ROHMUSDC/ROHM_SensorPlatform_Multi-Sensor-Shield/Platform Code/NXP_LPCXpresso54102_BlinkyExample/Firmware/periph_blinky/example/readme.txt

LPC5410x Simple blinky example
============================

Example description
-------------------
The Blinky example is known as the "Hello, World!" of embedded programming. This
example will flash an LED on your board at a periodic rate using sysTick.

Special connection requirements
-------------------------------
There are no special connection requirements for this example.

Build procedures:
-----------------
Visit the at 'LPCOpen quickstart guides' [http://www.lpcware.com/content/project/lpcopen-platform-nxp-lpc-microcontrollers/lpcopen-v200-quickstart-guides]
to get started building LPCOpen projects.
