ROHMUSDC/ROHM_SensorPlatform_Multi-Sensor-Shield/Documentation/CE Declaration of Conformity/technical_documentation/[10]_ROHMSensorShield_BoxPhotos_20160830.pdf

© 2016 ROHM Semiconductor U.S.A.,LLC

# SENSORSHLD1-EVK-101

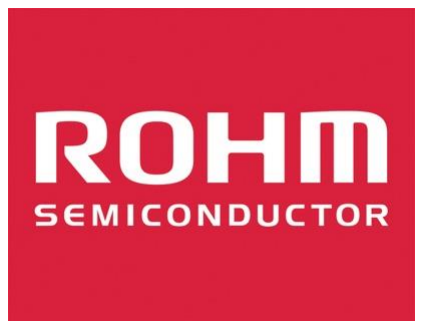
[picture p1: figure]

# Evaluation Board Box Pictures

# 08 August 2016 ROHM USDC Applications Engineering

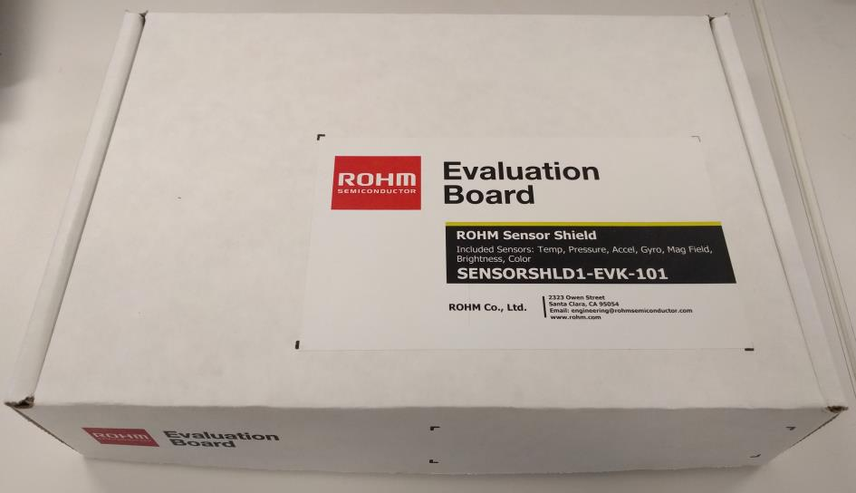
[picture p2: figure]

© 2016 ROHM Semiconductor U.S.A.,LLC | P. 1

# Sensor Shield Box, TOP

# Sensor Shield Box, TOP/SIDE

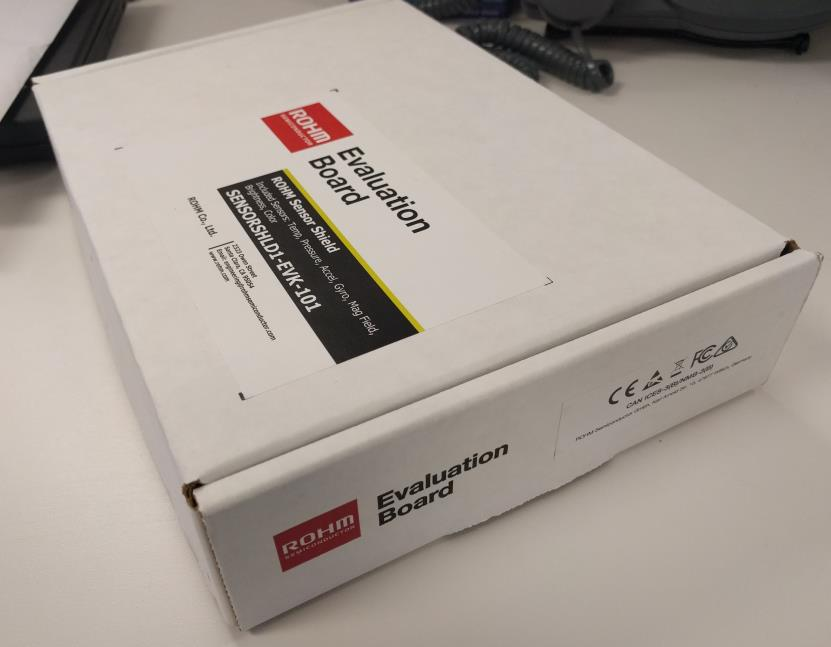
[picture p3: figure]

# Sensor Shield Box, SIDE

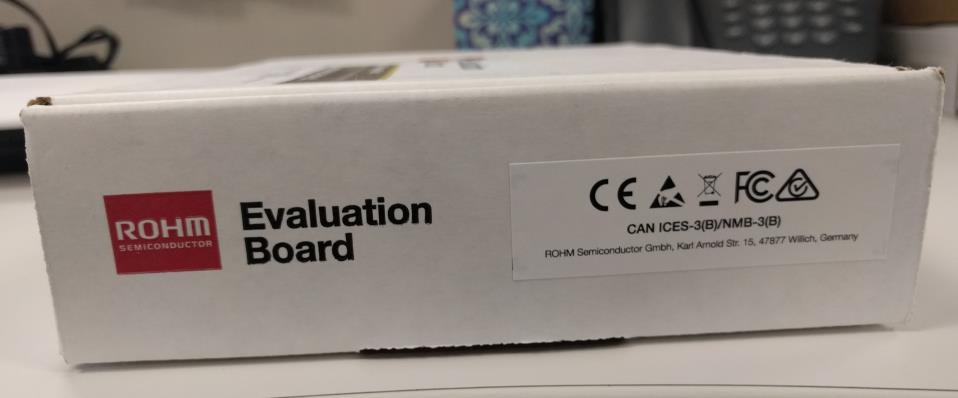
[picture p4: figure]

# Sensor Shield Box, Board Placement/Inner Box

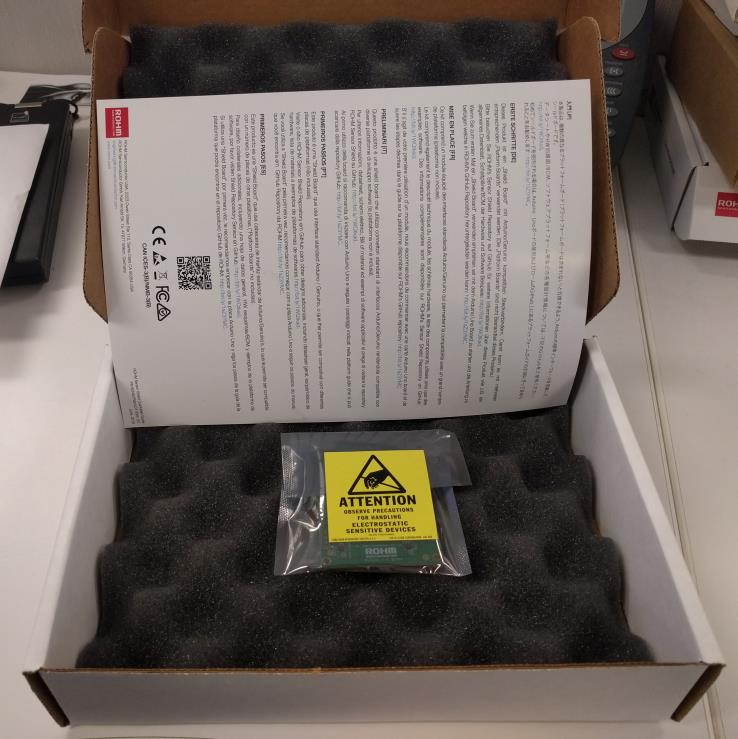
[picture p5: figure]

# Sensor Shield Box, Final QSG Placement

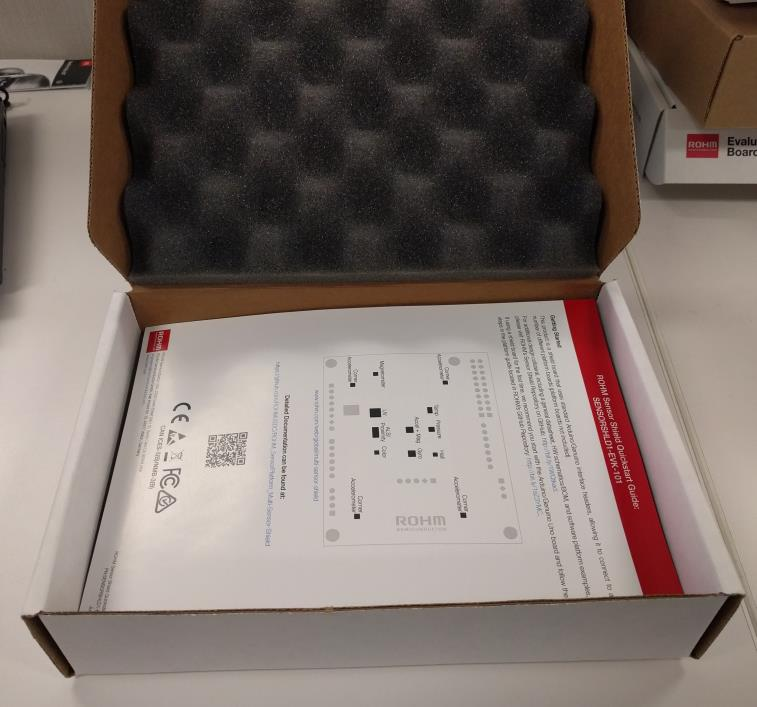
[picture p6: figure]

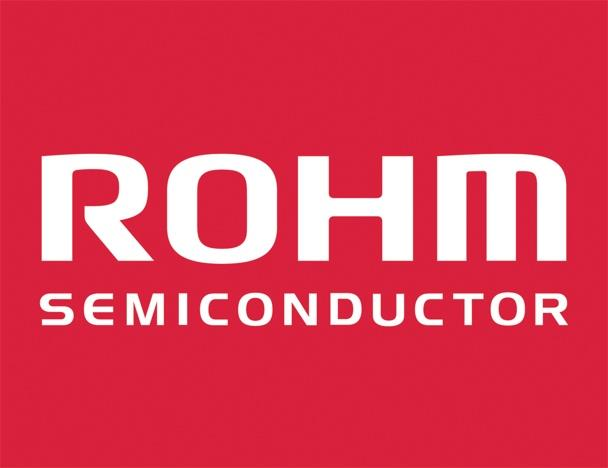
[picture p7: figure]

© 2016 ROHM Semiconductor U.S.A.,LLC .
