ROHMUSDC/ROHM_SensorPlatform_Multi-Sensor-Shield/Documentation/CE Declaration of Conformity/EUDC-DoC-201602-SENSORSHLD1-EVK-101.pdf

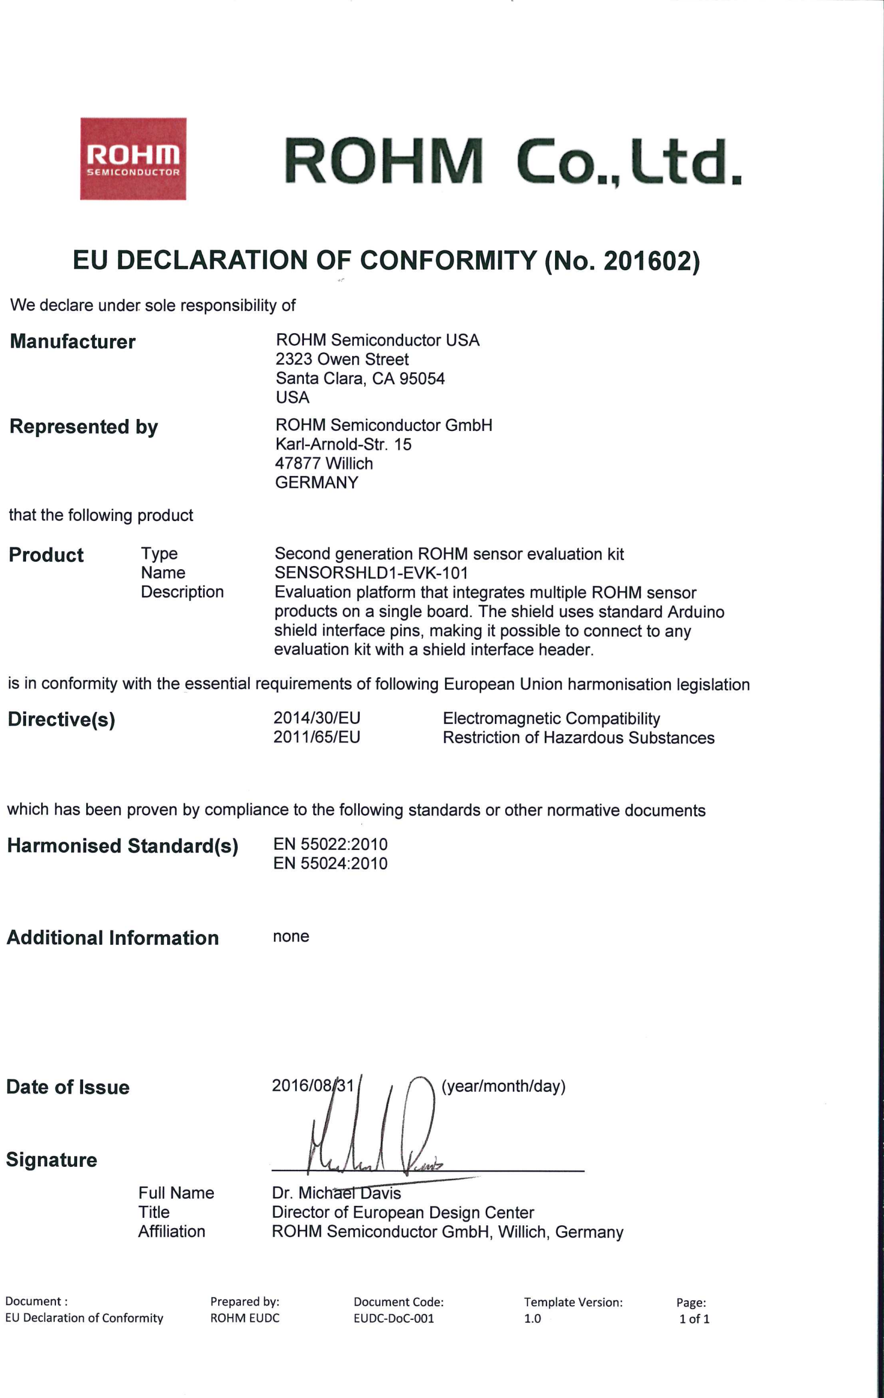
[picture p8: page 1]
