ROHMUSDC/ROHM_SensorPlatform_Multi-Sensor-Shield/Platform Code/LAPIS_SensorPlatform_Firmware/Firmware/_output/_hex/HTU8Success_Checksum.PNG

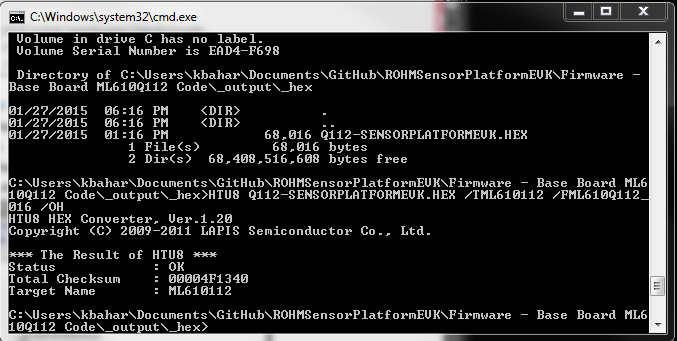
Platform Code/LAPIS_SensorPlatform_Firmware/Firmware/_output/_hex/HTU8Success_Checksum.PNG
