ROHMUSDC/ROHM_SensorPlatform_Multi-Sensor-Shield/HW Source Files/SENSORSHLD0-EVK-101 HW Design Files/Schematic_BOM/Revision 00.1/ROHM_SENSORSHLD1-EVK-101_BOM_REV00.1_2015-03-03.xlsx

Sheet: SENSORKIT-MULTISENSORSHIELD
Sensor Platform Multi-Sensor Shield Revised: Thursday, Sep 10, 2015
Bill Of Materials
Item | Quantity | Reference | Part | PCB Footprint | DESCRIPTION | MFG1 | MFG1_PART# | DISTR1 | DISTR1_PART# | DNP | Provided by ROHM | ROHM Comment
1 | 22 | C1,C2,C3,C5,C6,C9,C10,C11,C13,C14,C17,C21,C23,C24,C25,C26,C27,C28,C29,C30,C31,37 | 0.1uF | C0402 | CAP CER 0.1UF 10V 10% X5R 0402 | Murata | GRM155R61A104KA01D | DIGIKEY | 490-1318-1-ND |  | No
2 | 1 | C7 | 1nF | C0402 | CAP CER 1000PF 50V 10% X7R 0402 | Murata | GRM155R71H102KA01D | DIGIKEY | 490-1303-1-ND |  | No
3 | 1 | C8 | 0.47uF | C0402 | CAP CER 0.47UF 10V 10% X5R 0402 | Murata | GRM155R61A474KE15D | DIGIKEY | 490-3264-1-ND |  | No
4 | 6 | C12, C32, C33, C34,C35,C36, C38 | 1uF | C0402 | CAP CER 1UF 6.3V 10% X5R 0402 | Murata | GRM155R60J105KE19D | DIGIKEY | 490-1320-1-ND |  | No
5 | 1 | C19 | 2.2nF | C0402 | CAP CER 2200PF 50V 5% X7R 0402 | Murata | GRM155R71H222JA01J | DIGIKEY | 490-6359-1-ND |  | No
6 | 1 | C22 | 10nF | C0402 | CAP CER 10000PF 50V 10% X7R 0402 | Murata | GRM155R71H103KA88D | DIGIKEY | 490-4516-1-ND |  | No
7 | 1 | D1 | SML-P11VTT86 | LED0402 | LED 0402 RED 50MW 20MA SMD | Rohm | SML-P11VTT86 | ROHM | SML-P11VTT86 |  | Yes
8 | 9 | R1,R38,R8,R9,R10,R34,R36,R37,R43,R45,R46 | 10k | R0603 | RES SMD 10K OHM 5% 1/10W 0603 | Rohm | MCR03ERTJ103 | DIGIKEY | RHM10KCGTR-ND |  | Yes
9 | 28 | R11,R12,R13,R14,R15,R16,R17,R18,R19,R20,R21,R22,R23,R24,R25,R26,R27,R28,R29,R30,R31,R32,R33,R39,R40,R41,R44,R47 | 0 | R0603 | RES 0.0 OHM 1/10W JUMP 0603 SMD | Rohm | MCR03ERTJ000 | DIGIKEY | MCR03ERTJ000 |  | Yes
9 | 1 | R47 | 0 | R0603 | RES 0.0 OHM 1/10W JUMP 0603 SMD | Rohm | MCR03ERTJ000 | DIGIKEY | MCR03ERTJ000 | DNP | Yes
10 | 1 | R35 | 22 | R0603 | RES SMD 22 OHM 5% 1/10W 0603 | Rohm | MCR03ERTJ220 | Digi-Key | RHM22CGTR-ND |  | Yes
11 | 1 | R42 | 200k | R0402 | RES SMD 200K OHM 1% 1/16W 0402 | Rohm | TRR01MZPF2003 | Digi-Key | RHM200KBHCT-ND |  | Yes
12 | 1 | U1 | BDE0600G | SSOP5 | IC TEMP SENSOR THERM 60°C SSOP5 | Rohm | BDE0600G-TR | DIGIKEY | BDE0600GCT-ND |  | Yes
13 | 1 | U2 | BM1383GLV | BM1383GLV | Pressure Sensor IC | Rohm | BM1383GLV | ROHM | BM1383GLV |  | Yes
14 | 1 | U4 | BU52014HFV | HVSOF5 | IC HALL EFFECT SW BIPO HVSOF5 | Rohm | BU52011HFV-TR | DIGIKEY | BU52011HFV-TR |  | Yes
15 | 1 | U5 | ML8511 | TQFN12 | UV SENSOR W/AMP TQFN12 | Rohm | ML8511-00FCZ05B | DIGIKEY | ML8511-00FCZ05B |  | Yes
16 | 1 | U6 | RPR-0521 | IC_3P94X2P36 | ALS/Proximity Sensor | Rohm | RPR-0521 | Rohm | RPR-0521 |  | Yes
17 | 1 | U7 | BH1745NUC | BH1745NUC | Color Sensor | Rohm | BH1745NUC | Rohm | BH1745NUC |  | Yes
18 | 1 | U8 | KMX62 | LGA_3x3x0P9 | MAGNETOMETER AND ACCELEROMETER TRI-AXIS LGA16 | Kionix/Rohm | KMX62 | Kionix/Rohm | KMX62 |  | Yes
19 | 1 | U9 | KX122 | LGA_2x2x0P9 | Accel MEM Sensors | Kionix/Rohm | KX122 | Kionix/Rohm | KX122 |  | Yes
20 | 1 | U11 | KXG03 | LGA_3x3x0P9 | Gyro Sensor | Kionix/Rohm | KXG03 | Kionix/Rohm | KXG03 |  | Yes
21 | 1 | U12 | SPM0423HD4H-WB | IC_4P72X3P76 | MIC MEMS DIGITAL PDM OMNI -26DB | Knowles | SPM0423HD4H-WB | Digi-Key | 423-1126-2-ND |  | No
22 | 2 | U13,U15 | KX123 | LGA_3X3X0P9 | BOARD EVAL KXCJK ACCELEROMETER | Kionix Inc | KX123-1039 | ROHM | N/A |  | Yes
23 | 2 | U14,U16 | KX123 | LGA_3X3X0P9 | BOARD EVAL KXCJK ACCELEROMETER | Kionix Inc | KX123-1050 | ROHM | N/A |  | Yes
24 | 1 | U17 | BM1422GMV | MLLGA010V020A | 3-Axis Magnetometer | Rohm | BM1422GMV | Digi-Key | BM1422GMV |  | Yes
25 | 1 | U18 | NVT2003DP,118 (http://www.digikey.com/product-detail/en/NVT2003DP,118/568-8383-2-ND/2763882) | TSSOP10 | 3 Channel Level Shifter | NXP | NVT2003DP,118 (http://www.digikey.com/product-detail/en/NVT2003DP,118/568-8383-2-ND/2763882) | Digi-Key | 568-8383-2-ND (http://www.digikey.com/product-detail/en/NVT2003DP,118/568-8383-2-ND/2763882) |  | No
26 | 1 | U19 | BU18TA2WNVX-TR | 4-SSON-EP | 1.8v LDO | Rohm | BU18TA2WNVX-TR | Digi-Key | BU18TA2WNVXCT-ND |  | Yes
27 | 1 | H1 | SensorInterfaceHeader_1 | HDR_THVT_1X5_100 | CONN HEADER VERT SGL 5POS | Standard Pitch Through-Hole Male |  |  |  | DNP
28 | 1 | H2 | SensorInterfaceHeader_2 | HDR_THVT_1X5_100 | CONN HEADER VERT SGL 5POS |  |  |  |  | DNP
29 | 1 | H3 | SensorInterfaceHeader_3 | HDR_THVT_1X6_100 | CONN HEADER VERT SGL 6POS |  |  |  |  | DNP
30 | 1 | H4 | Stackable Headers | HDR_THVT_1X8_100 | CONN RCPT .100" 8POS TIN WW | Osepp | LS-00010 | MCMelectronics | 83-15512 |  | No | One order comes perfectly with (1)6-pos, (2) 8-pos, and (1) 10-pos http://www.mcmelectronics.com/product/OSEPP-LS-00010-/83-15512
31 | 1 | H5 | Stackable Headers | HDR_THVT_1X6_100 | CONN RCPT .100" 6POS TIN WW | Osepp | LS-00011 | MCMelectronics | 83-15513 |  | No
32 | 1 | H6 | Stackable Headers | HDR_THVT_1X8_100 | CONN RCPT .100" 8POS TIN WW | Osepp | LS-00012 | MCMelectronics | 83-15514 |  | No
33 | 1 | H7 | Stackable Headers | HDR_THVT_1X10_100 | CONN RCPT .100" 10POS TIN WW | Osepp | LS-00013 | MCMelectronics | 83-15515 |  | No
34 | 1 | H8 | ExpansionHeader_I2C+ADC | HDR_THVT_1X8_100 | CONN HEADER VERT SGL 8POS | Standard Pitch Through-Hole Male |  |  |  | DNP
35 | 1 | H9 | ExpansionHeader_SPI | HDR_THVT_1X7_100 | CONN HEADER VERT SGL 7POS |  |  |  |  | DNP
36 | 1 | H10 | Header_Ard_Digital2_TopSide | HDR_THVT_1X10_100 | CONN HEADER VERT SGL 8POS
37 | 5 | H11,H12,H13,H14, H15 | 3PinHeader | HDR_THVT_1X3_100 | CONN HEADER VERT SGL 3POS
38 | 4 | J1,J2,J3,J4 | 2-Pin Header | HDR_THVT_1X2_100 | CONN HEADER VERT SGL 2POS |  |  |  |  | DNP
39 | 1 | Header Purchase Info (This is the sum of headers for lines 18-28) | 111-Pin Header | N/A | CONN HEADER VERT SGL 2POS | EMS should have many of these leftover as I ordered way too many for the last build… Need to Confirm Before ordering again! |  |  |  |  | Yes

Sheet: Rohm Parts Only
Single Board Quantity | Total Build Quantity | Part Reference | DESCRIPTION | MFG1 | MFG1_PART#
1 | 1500 | SML-P11VTT86 | LED 0402 RED 50MW 20MA SMD | Rohm | SML-P11VTT86
9 | 13500 | 10k | RES SMD 10K OHM 5% 1/10W 0603 | Rohm | MCR03ERTJ103
28 | 42000 | 0 | RES 0.0 OHM 1/10W JUMP 0603 SMD | Rohm | MCR03ERTJ000
1 | 1500 | 22 | RES SMD 22 OHM 5% 1/10W 0603 | Rohm | MCR03ERTJ220
1 | 1500 | 200k | RES SMD 200K OHM 1% 1/16W 0402 | Rohm | TRR01MZPF2003
1 | 1500 | BDE0600G | IC TEMP SENSOR THERM 60°C SSOP5 | Rohm | BDE0600G-TR
1 | 1500 | BM1383GLV | Pressure Sensor IC | Rohm | BM1383GLV
1 | 1500 | BU52014HFV | IC HALL EFFECT SW BIPO HVSOF5 | Rohm | BU52011HFV-TR
1 | 1500 | ML8511 | UV SENSOR W/AMP TQFN12 | Rohm | ML8511-00FCZ05B
1 | 1500 | RPR-0521 | ALS/Proximity Sensor | Rohm | RPR-0521
1 | 1500 | BH1745NUC | Color Sensor | Rohm | BH1745NUC
1 | 1500 | KMX62 | MAGNETOMETER AND ACCELEROMETER TRI-AXIS LGA16 | Kionix/Rohm | KMX62
1 | 1500 | KX122 | Accel MEM Sensors | Kionix/Rohm | KX122
1 | 1500 | KXG03 | Gyro Sensor | Kionix/Rohm | KXG03
2 | 3000 | KX123 | BOARD EVAL KXCJK ACCELEROMETER | Kionix Inc | KX123-1039
2 | 3000 | KX123 | BOARD EVAL KXCJK ACCELEROMETER | Kionix Inc | KX123-1050
1 | 1500 | BM1422GMV | 3-Axis Magnetometer | Rohm | BM1422GMV
1 | 1500 | BU18TA2WNVX-TR | 1.8v LDO | Rohm | BU18TA2WNVX-TR
