ROHMUSDC/ROHM_SensorPlatform_Multi-Sensor-Shield/Documentation/CE Declaration of Conformity/technical_documentation/[6]_ROHM_SENSORSHLD1-EVK-101_BOM_REV01_2016-03-16_ROHS/FAB-9_FAB-ASSY_RoHS Cert.pdf

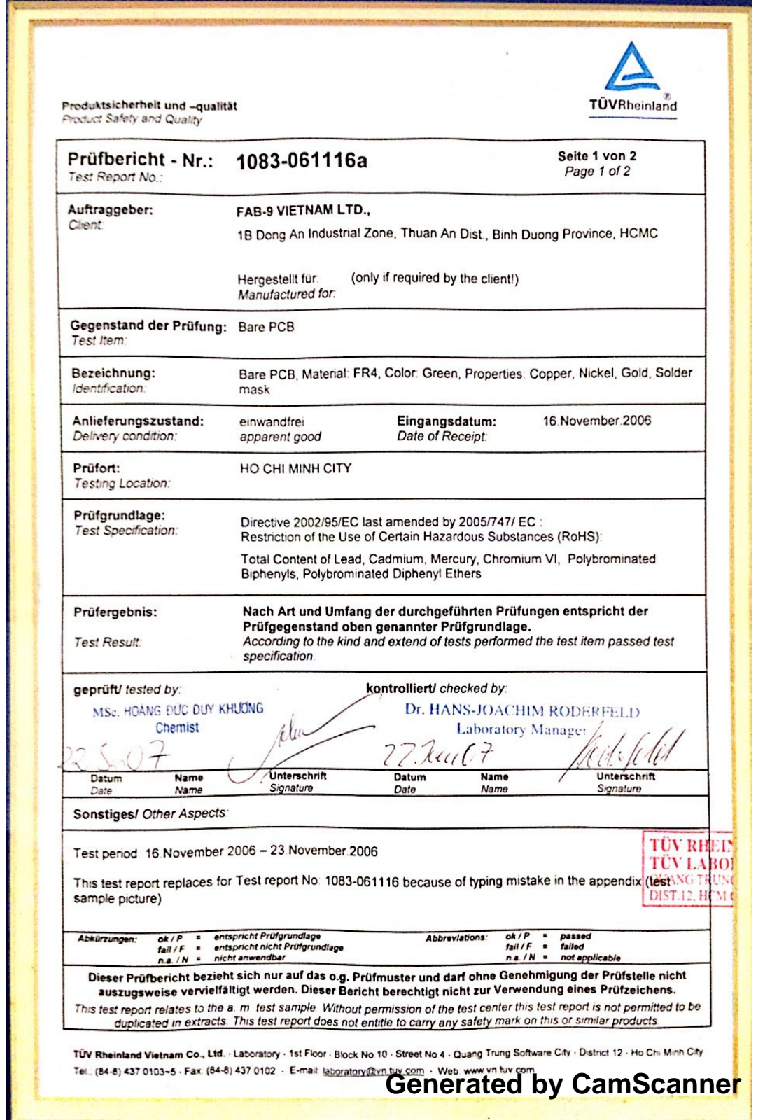
[picture p10: page 1]

Generated by CamScanner

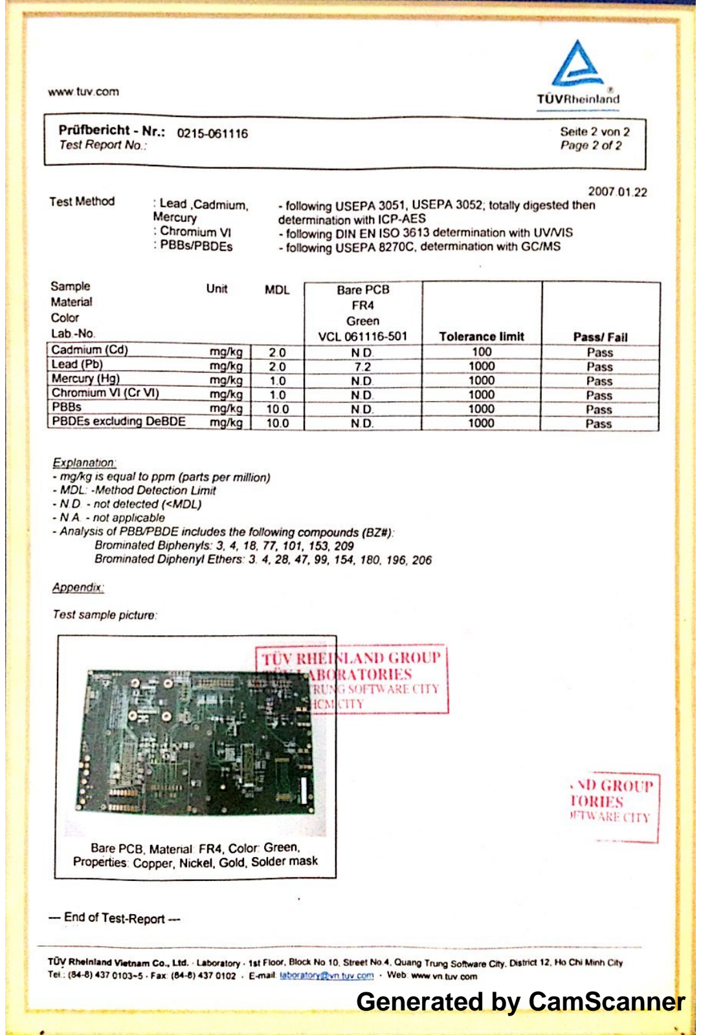
[picture p11: page 2]

Generated by CamScanner
