ROHMUSDC/ROHM_SensorPlatform_Multi-Sensor-Shield/Documentation/CE Declaration of Conformity/technical_documentation/[6]_ROHM_SENSORSHLD1-EVK-101_BOM_REV01_2016-03-16_ROHS/Knowles-Environmental-Compliance-Initiatives.pdf

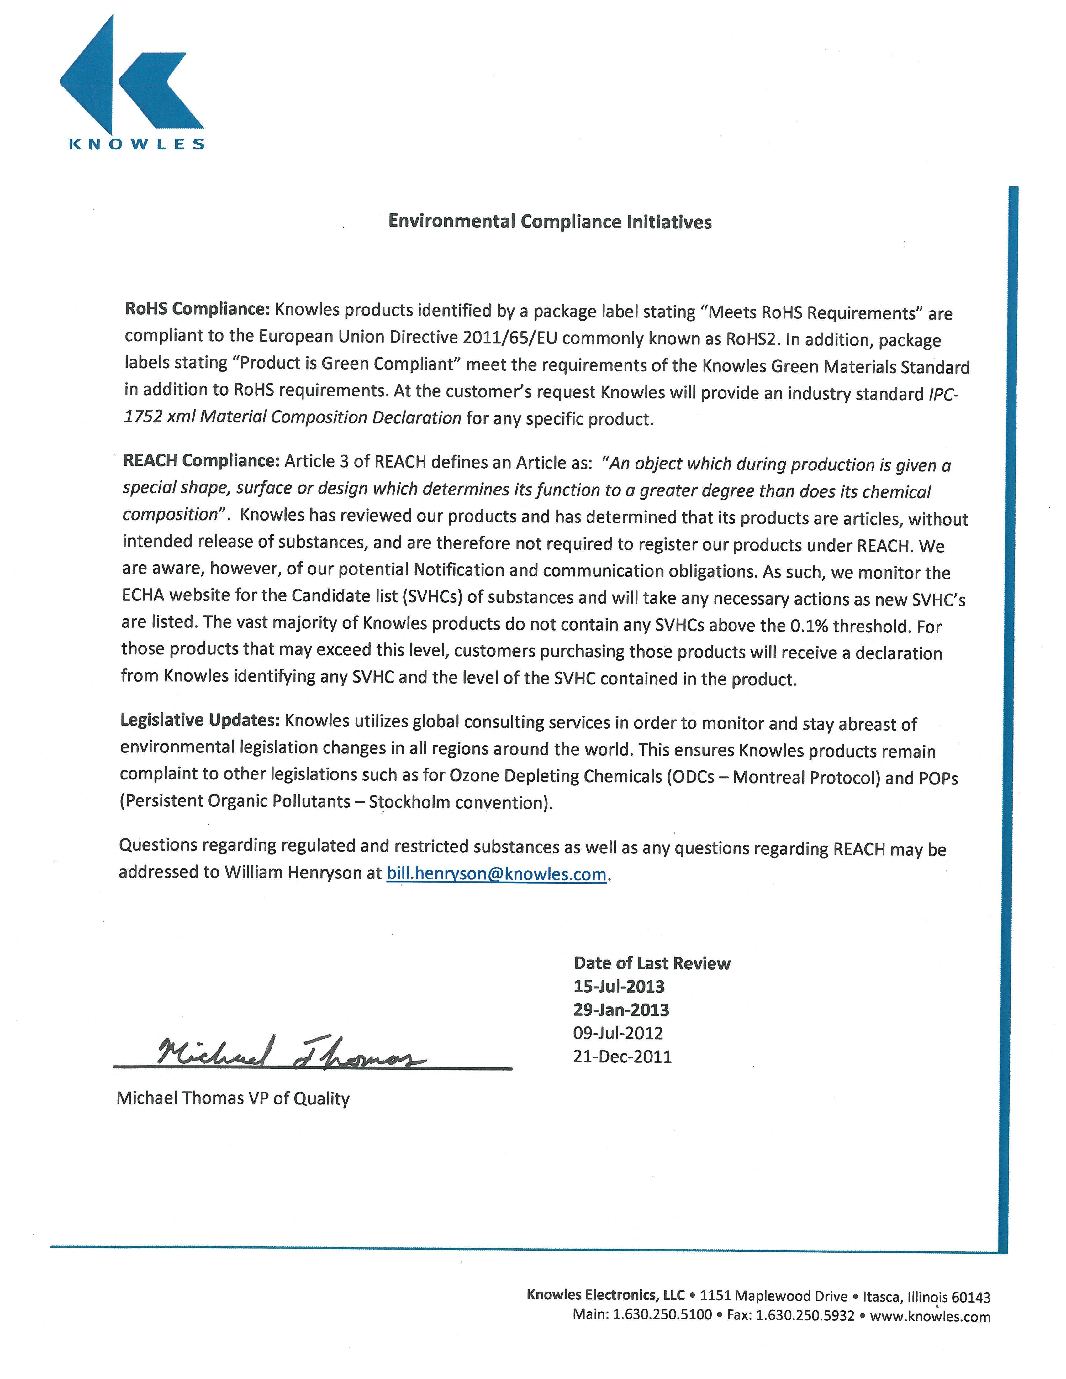
[picture p12: page 1]
