ROHMUSDC/ROHM_SensorPlatform_Multi-Sensor-Shield/Documentation/CE Declaration of Conformity/technical_documentation/[6]_ROHM_SENSORSHLD1-EVK-101_BOM_REV01_2016-03-16_ROHS/NXP-ROHS-DECLARATION.pdf

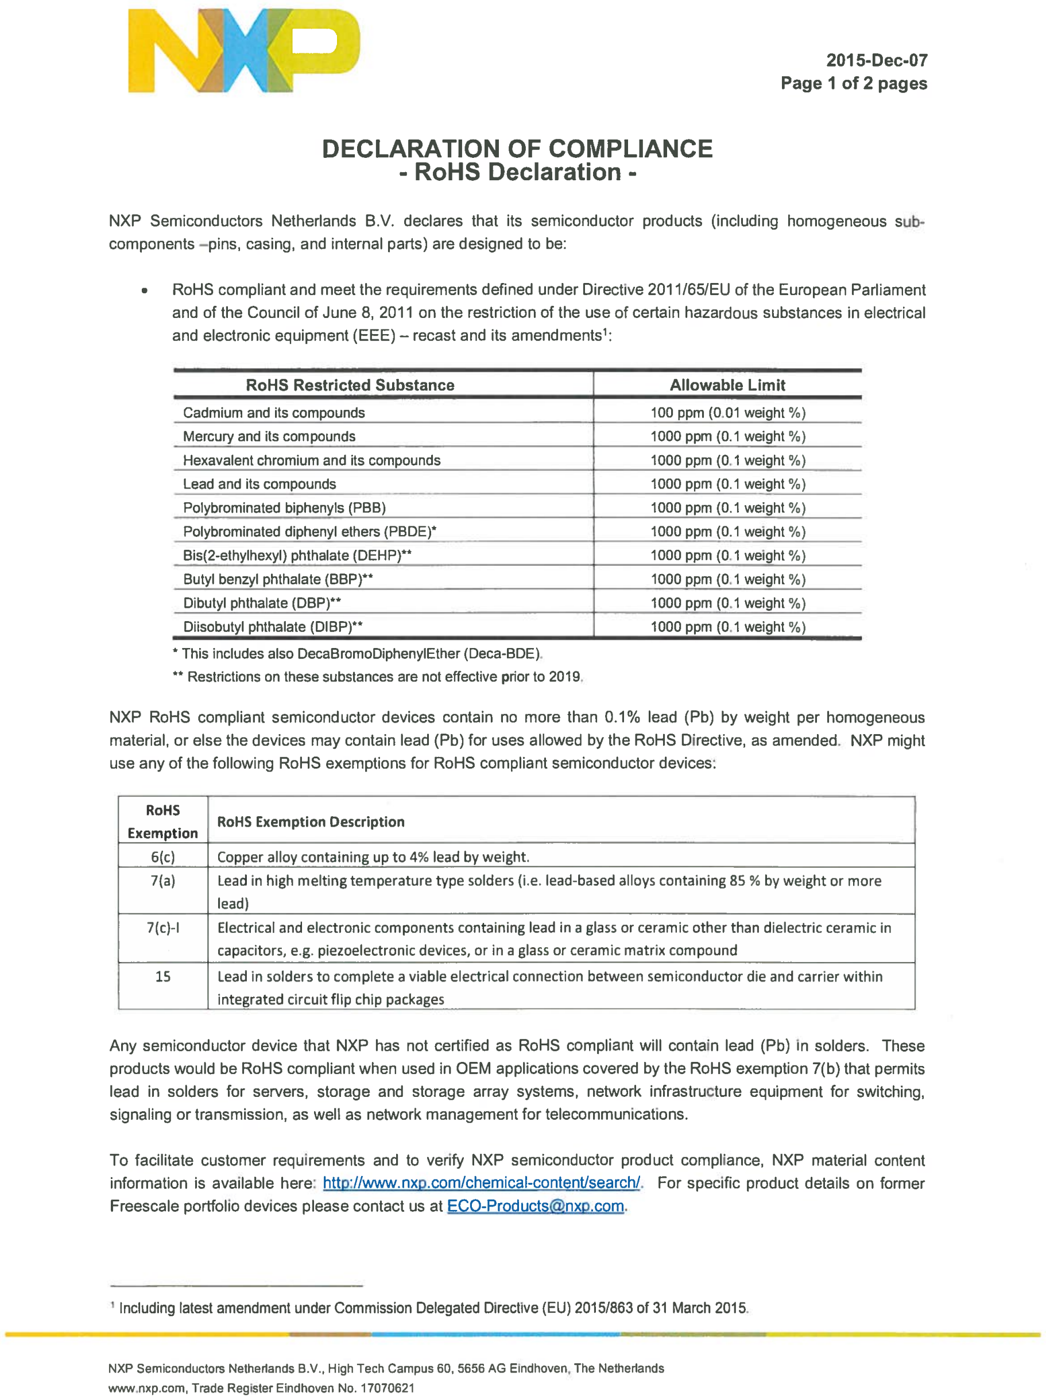
[picture p13: page 1]
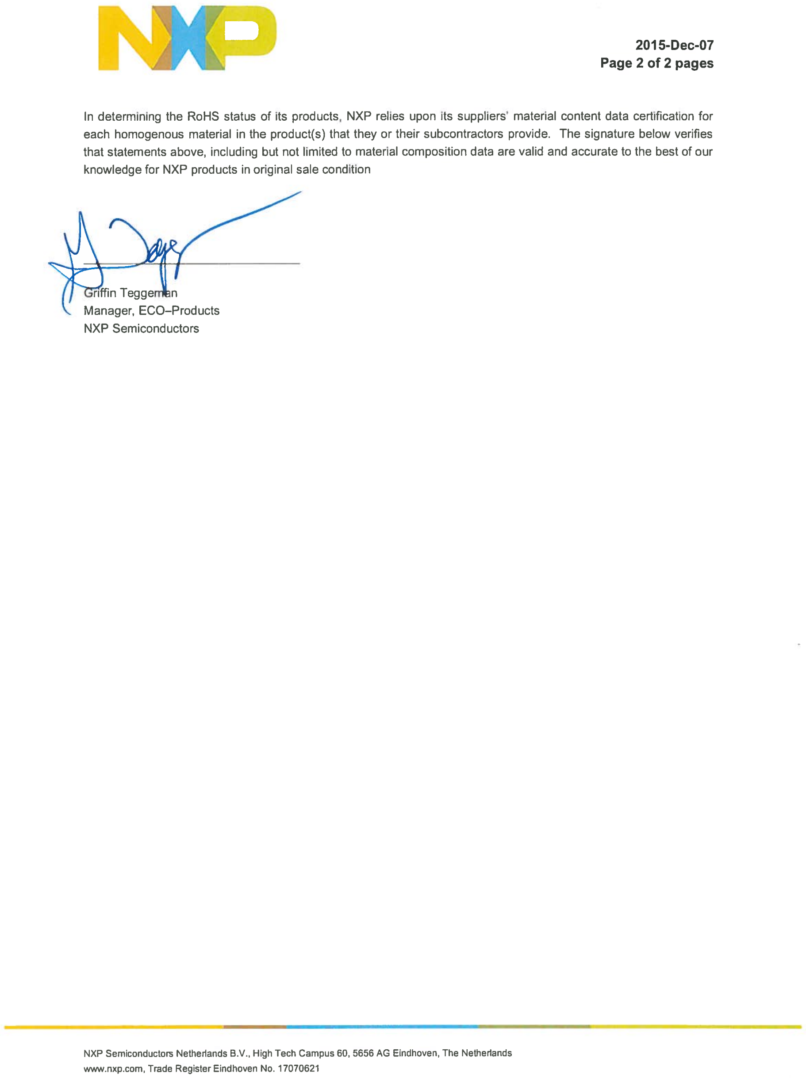
[picture p14: page 2]
