ROHMUSDC/ROHM_SensorPlatform_Multi-Sensor-Shield/HW Source Files/SENSORSHLD1-EVK-101 HW Design Files/Gerber/ASSY/ASSEMBLYINSTRUCTIONS_README.txt

NOTE: Please use "no clean" solder/flux and do not wash this board after assembly.
Two sensors on board (Pressure and Microphone sensor) are susceptible to failure if washed.
