ROHMUSDC/ROHM_SensorPlatform_Multi-Sensor-Shield/(threads)

Thread 8 (2015-06-26):

Issues with ROHM Base Board Application

kbahar, 2015-06-26:
Right now, I've messed up routing J1 to J11. Depending on the pins connected, initially, I wanted each single pin to map to the GPIO location... but in doing this, I inadvertently tied all these GPIO pins together.  Next revision, we will tie each GPIO to an individual jumper that will then map to the binary listing we made earlier.

Also, right now the code is trying to be modular by using the same block of code used with past sensors.  We will need to adjust this slightly so the standalone GPIO functionality does not cycle though each section and blink the LEDs quickly.  Needs to be cleaned

kbahar, 2016-03-19:
Removed from Shield1 design. This is no longer applicable. Closed.

Closed 2016-03-19.

Thread 9 (2016-03-01):

Add Jumpers to change I2C pins to accommodate Arduino Uno Scheme

kbahar, 2016-03-01:
Arduino UNO has I2C pins tied to some of the analog pins.  When making new layout for SHLD1, be sure to add jumpers/resistor settings to accommodate this without having to do wire re-work.

Closed 2016-03-19.

Thread 10 (2016-06-25):

Code for H2 ADC 0 and 1?

bigdady70, 2016-06-25:
All,
If this is the improper forum for a question, please direct me appropriately.

I am using the Multitech dragonfly with this shield. How do I read H2 ADC[0] and ADC[1] which I have wired to analog sensors? How are these pins addressed in code?
Thanks

kbahar, 2016-06-27:
Hi bigdady70,

_>>How do I read H2 ADC[0] and ADC[1] which I have wired to analog sensors?_
Please see the mbed section on how to use Analog input.
https://developer.mbed.org/handbook/AnalogIn. There are some examples shown in the platform code for the UV sensor.

_>>How are these pins addressed in code?_
I found the following link helpful for the dragonfly pinouts.
https://developer.mbed.org/platforms/MTS-Dragonfly/#pinout-diagram
A0 on Dragonfly is connected to Pin 18 (PC_2)
A1 on Dragonfly is connected to Pin 20 (PC_0)

Best regards,
Kris

bigdady70, 2016-06-28:
Kris,
A follow up question please, as this is my first time wiring up something external to the dragonfly with the Rohm Expansion Board.

On H2 of the Rohm Expansion / Sensor Board, the Rohm Schematic diagram (page 3 of https://github.com/ROHMUSDC/ROHM_SensorPlatform_Multi-Sensor-Shield/blob/master/Documentation/Sensor%20Shield%20HW%20PDF%20Files/ROHM_SENSORSHLD1-EVK-101_BRD_REV01_2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 ), labels ADC [0] and ADC[1]. And reading your response, above, is the below correct?
ADC[0] = A0 which is connected to Pin 18 (PC_2) and
ADC[1] = A1 which is connected to Pin 20 (PC_0) ?

If the above is correct, then I believe I understand the situation. The different Headers (Hx where x is a number corresponding to a Header in the schematic) are all connected to the same A/D converter. The expansion headers allow more analog inputs based on the size of the header, but they all trace back to the same A/D converter. Correct?

Thank you again for your patience and guidance.
Brian

kbahar, 2016-06-29:
Hi Brian,

I would recommend you take a look at the schematic file at the following link:
https://github.com/ROHMUSDC/ROHM_SensorPlatform_Multi-Sensor-Shield/blob/master/Documentation/Sensor%20Shield%20HW%20PDF%20Files/ROHM_SENSORSHLD1-EVK-101_SCH_REV01_2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

The board file you referenced works but as it is a PDF file, it is difficult to see where the pins are routed to in that file.  In the schematic shown above, we can see that the H2 ADC pins are routed to A0 and A1.  See below for some snipped images from the schematic:
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
Therefore, it looks like your indications are correct:
_ADC[0] = A0 which is connected to Pin 18 (PC_2)
ADC[1] = A1 which is connected to Pin 20 (PC_0)_

_>>The different Headers (Hx where x is a number corresponding to a Header in the schematic) are all connected to the same A/D converter. The expansion headers allow more analog inputs based on the size of the header, but they all trace back to the same A/D converter. Correct?_
The above is partially correct; the different headers were built in to accommodate any extra sensor devices users may want to add to the device, however they are not all connected to the same A/D converter.  These points are all connected to different pins on the shield board, which then get routed to different pins on the host board (in this case, the host board is the multitech dragonfly). As long as the pins connected to the host board support A/D conversion, it should work correctly.

BR,
Kris

Closed 2016-06-27.

Thread 11 (2017-03-20):

I2C Init Failed (SDA or SCL may not be pulled up!

OdingdongO, 2017-03-20:
When I use the demo "ROHM_SENSORSHLD1-EVK-101_TerminalDemo_11-10-2016.ino",the error is printed in the serial port. "I2C Init Failed (SDA or SCL may not be pulled up!"

kbahar, 2017-03-20:
See Question #4 in the FAQ section of the readme for this repository.

Closed 2017-03-20.

Thread 12 (2017-03-27):

"AssertionError: Incoming message too short" or " ib.evkit_protocol.ProtocolException: Version request wrong message type 91"

OdingdongO, 2017-03-27:
hi,
I would like to use the stream pattern of arduino and ROHM_SensorPlatform_MultiSensor-Shield.
But when I use Kionix-Multi-OS-Evaluation-Software, these problems arise.
https://github.com/RohmSemiconductor/Kionix-IoT-Evaluation-Kit/tree/master/Kionix-Multi-OS-Evaluation-Software
"""""
DEBUG :	sensor_base.py (39) :	__init__ :	Using INTERVAL_READ for data ready.
INFO :	connection_setup.py (112) :	setup_default_connection :	Bus serial_com_arduino_usdc selected
INFO :	bus_serial.py (126) :	get_com_port :	Automatic port choice: COM8
INFO :	bus_serial.py (144) :	open :	Waiting 3 seconds
DEBUG :	bus_serial.py (164) :	open :	Version query failed. Try 2nd time.
DEBUG :	bus_serial.py (101) :	_flush_input :	Flushing serial input.
CRITICAL :	connection_setup.py (129) :	open_bus_or_exit :	Version request wrong message type 56
WARNING :	connection_setup.py (131) :	open_bus_or_exit :	Try again.
Traceback (most recent call last):
  File "C:/Users/detao/Desktop/ROHM_SensorPlatform_Multi-Sensor-Shield/Kionix-IoT-Evaluation-Kit-master/Kionix-IoT-Evaluation-Kit-master/Kionix-Multi-OS-Evaluation-Software/kmx62/kmx62_data_logger.py", line 222, in <module>
    bus = open_bus_or_exit(sensor)
  File "..\connection_setup.py", line 122, in open_bus_or_exit
    bus = setup_default_connection(sensor)
  File "..\connection_setup.py", line 118, in setup_default_connection
    return bus_index_dict[bus_index](sensor)
  File "..\connection_setup.py", line 87, in setup_serial_i2c
    b.open()
  File "..\lib\bus_serial.py", line 170, in open
    self._message_handler.handle_version_resp(reponse_data)
  File "..\lib\evkit_protocol.py", line 144, in handle_version_resp
    raise ProtocolException('Version request wrong message type %d' % msg_type)
lib.evkit_protocol.ProtocolException: Version request wrong message type 56
"""

thank you
