ROHMUSDC/ROHM_SensorPlatform_Multi-Sensor-Shield/HW Source Files/SENSORSHLD0-EVK-101 HW Design Files/Schematic_BOM/ROHM_SENSORSHLD0-EVK-101_SCH_REV00_2015-05-18.pdf

# ROHM Sensor Platform MultiSensor Shield

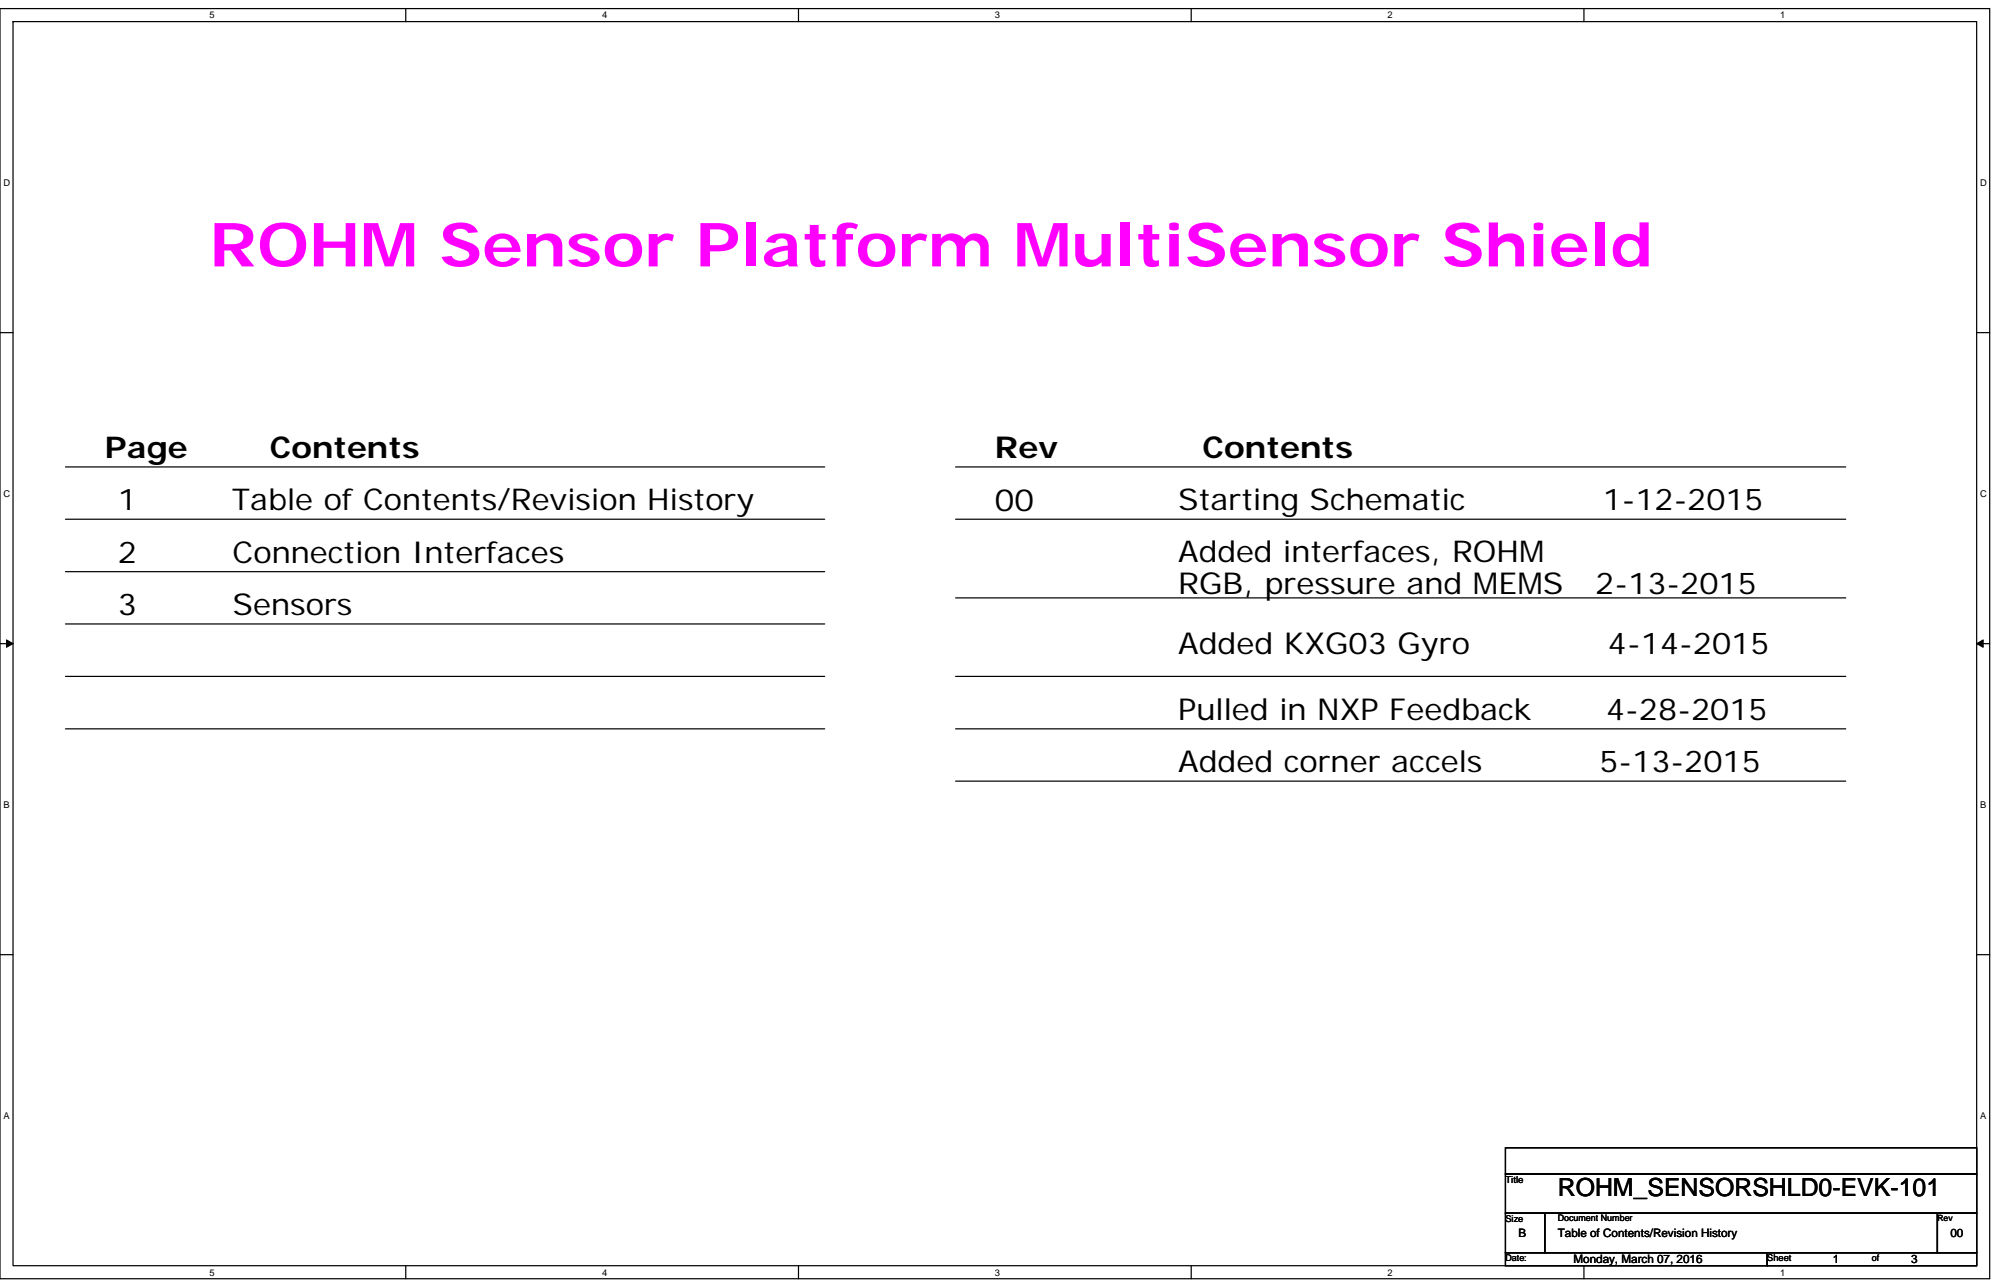
[picture p71: page 1]
Page; Contents; Table of Contents/Revision History; Rev; Starting Schematic; Sensors; Connection Interfaces; Added interfaces, ROHM; Added KXG03 Gyro; Pulled in NXP Feedback; Added corner accels; Title; ROHM_SENSORSHLD0-EVK-101

RGB, pressure and MEMS 2-13-2015

Size Size Size B B B | Document Number Document Number Document Number Table of Contents/Revision History Table of Contents/Revision History Table of Contents/Revision History | Rev Rev Rev 00 00 00

Date: Date: Date: Monday, March 07, 2016 Monday, March 07, 2016 Monday, March 07, 2016 | Sheet Sheet Sheet 1 1 1 of of of 3 3 3

# Hall Sensor BU52014HFV

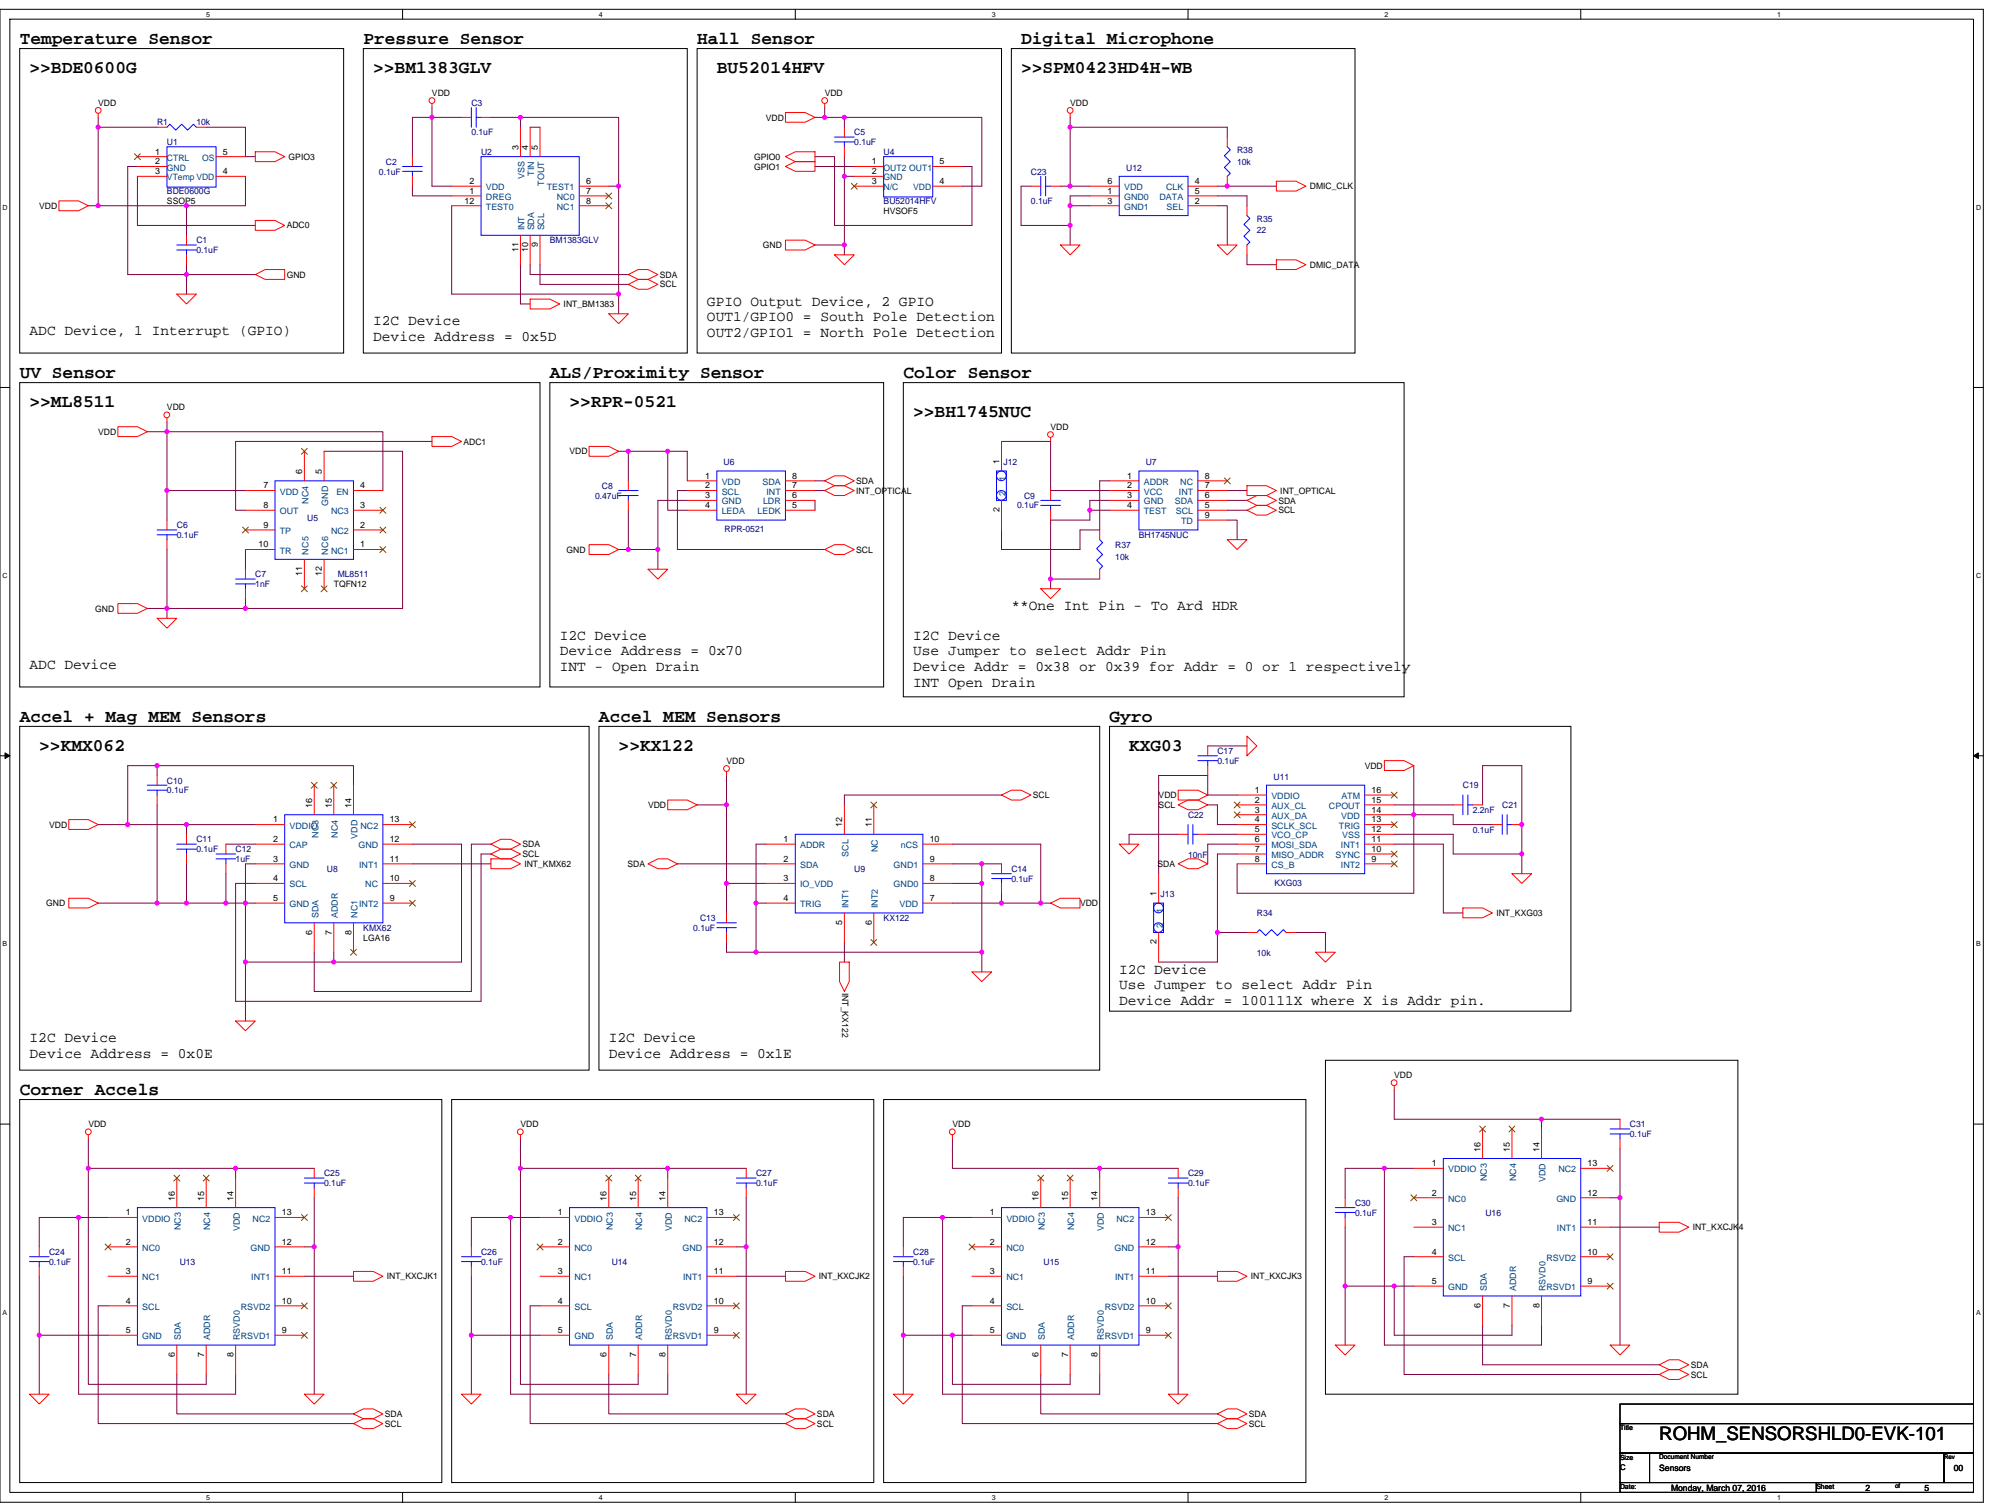
[picture p72: page 2]

SDA
SCL
GPIO Output Device, 2 GPIO
OUT1/GPIO0 = South Pole Detection
OUT2/GPIO1 = North Pole Detection

ADC Device, 1 Interrupt (GPIO)

**One Int Pin - To Ard HDR

I2C Device
Use Jumper to select Addr Pin
Device Addr = 0x38 or 0x39 for Addr = 0 or 1 respectively
INT Open Drain

Accel + Mag MEM Sensors
>>KMX062

Device Addr = 100111X where X is Addr pin.

# Common Platform Header Pins (Shield Layout)

# Sensor Platform Header Pins

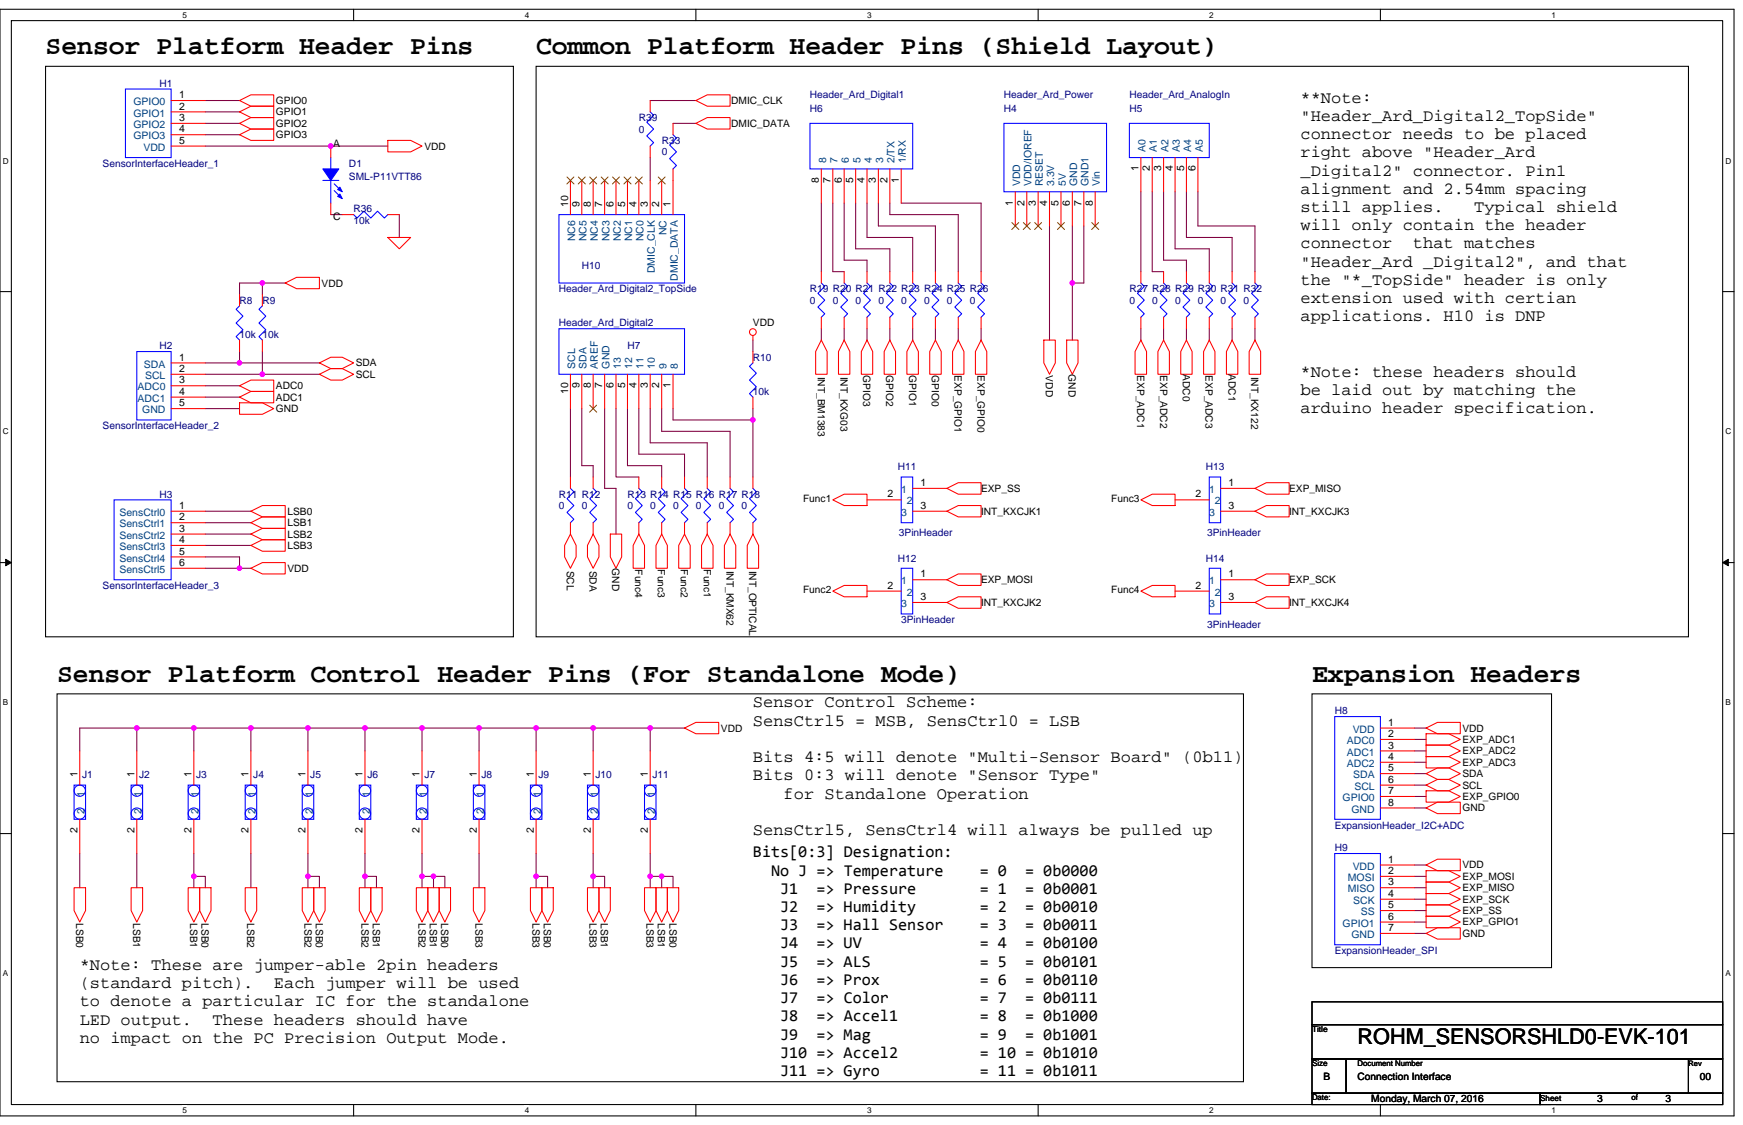
[picture p73: page 3]

**Note:
"Header_Ard_Digital2_TopSide"
connector needs to be placed
right above "Header_Ard
_Digital2" connector. Pin1
alignment and 2.54mm spacing
will only contain the header
connector that matches
"Header_Ard _Digital2", and that
the "*_TopSide" header is only

extension used with certian
applications. H10 is DNP

8 1 9 2 10 3 11 4 12 5 13 6 GND 7 AREF 8 SDA 9 SCL 10

*Note: these headers should
be laid out by matching the
arduino header specification.

Sensor Platform Control Header Pins (For Standalone Mode)

Sensor Control Scheme:
SensCtrl5 = MSB, SensCtrl0 = LSB
VDD
Bits 4:5 will denote "Multi-Sensor Board" (0b11)
Bits 0:3 will denote "Sensor Type"
for Standalone Operation
SensCtrl5, SensCtrl4 will always be pulled up
Bits[0:3] Designation:

LSB0
*Note: These are jumper-able 2pin headers
(standard pitch). Each jumper will be used
to denote a particular IC for the standalone
LED output. These headers should have
no impact on the PC Precision Output Mode.

Size Size Size B B B | Document Number Document Number Document Number Connection Interface Connection Interface Connection Interface | Rev Rev Rev 00 00 00

Date: Date: Date: Monday, March 07, 2016 Monday, March 07, 2016 Monday, March 07, 2016 | Sheet Sheet Sheet 3 3 3 of of of 3 3 3
