ROHMUSDC/ROHM_SensorPlatform_Multi-Sensor-Shield/HW Source Files/SENSORSHLD0-EVK-101 HW Design Files/PCB_Layout/FAB_DRAWING.pdf

D

2

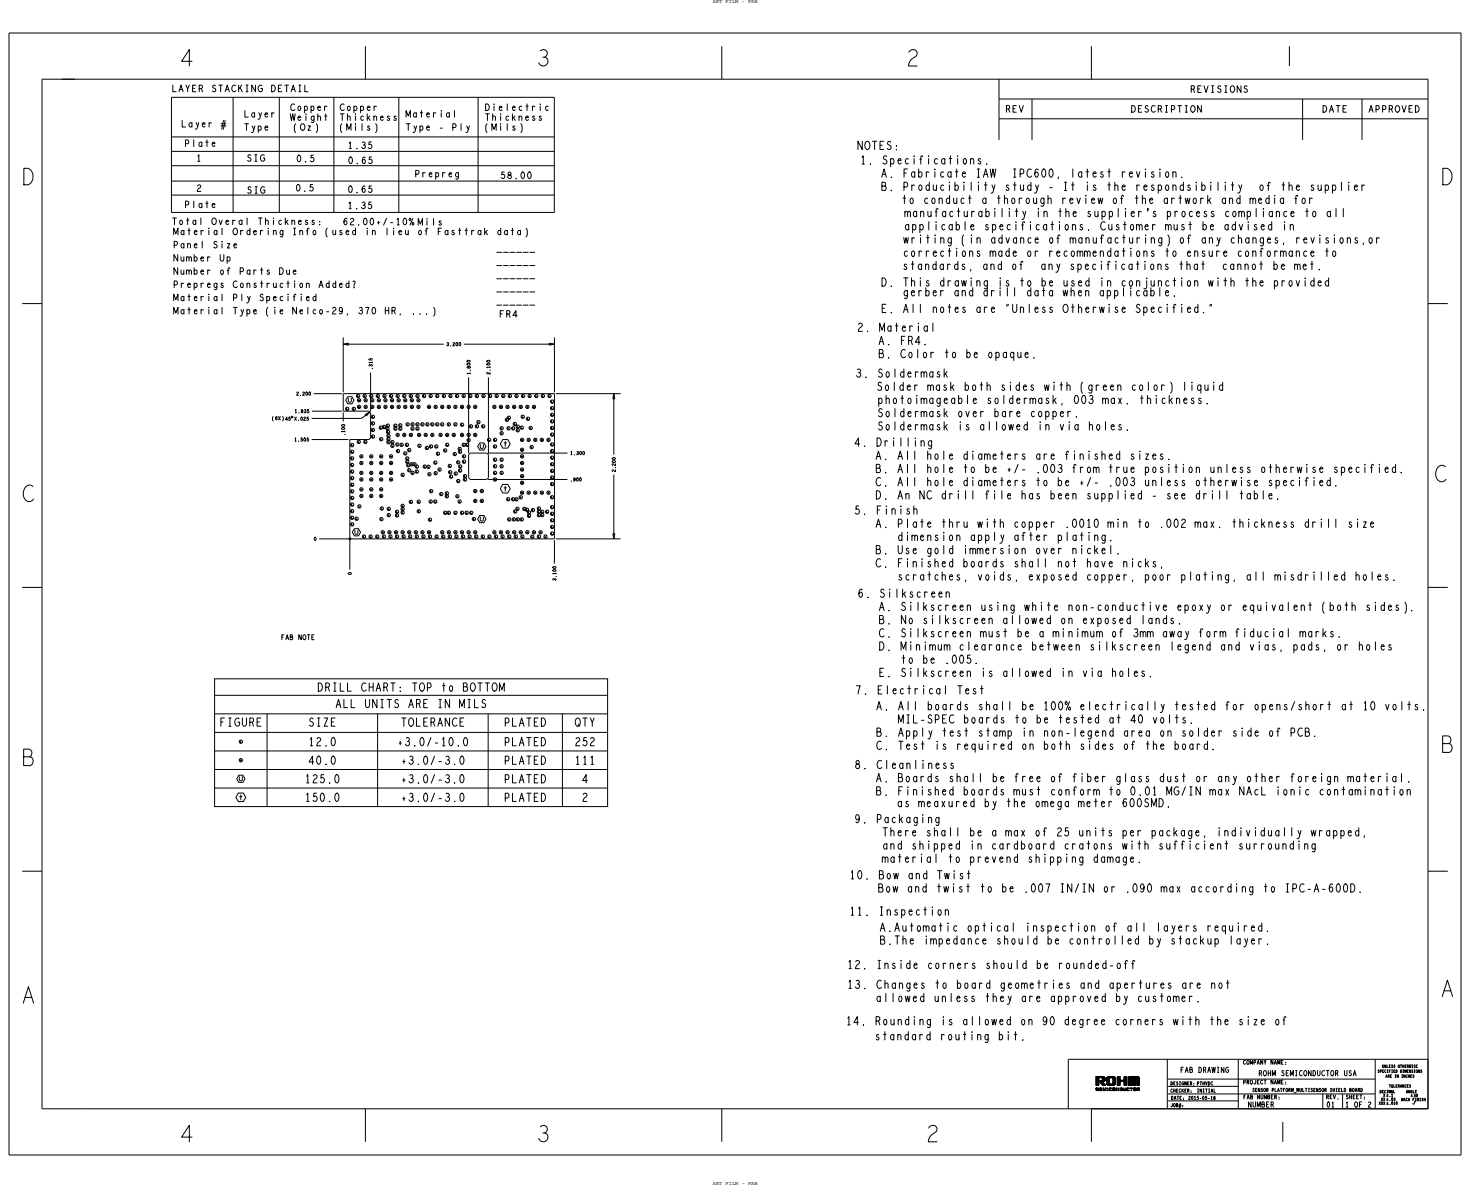
[picture p74: page 1]
APPROVED; SHEET:; DATE; REV.; NUMBER; FAB NUMBER:; REVISIONS; INITIAL; FAB DRAWING; JOB#:; DATE:; CHECKER:; REV; DESCRIPTION; B. Producibility study -; the; respondsibility of; the supplier; A. Fabricate IAW; IPC600,; latest; revision.; corrections; made or; recommendations; to ensure conformance; applicable specifications. Customer; must; advised; D. This drawing; be used; in conjunction with; provided; standards, and of any specifications; that cannot; met.; E. All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

ART FILM - FAB

LAYER STACKING DETAIL

NOTES:
1. Specifications.
gerber and drill data when applicable.
2. Material
3. Soldermask
4. Drilling
5. Finish
6. Silkscreen

Plate
Total Overal Thickness:
Material Ordering Info (used in lieu of Fasttrak data)
Panel Size
Number Up
Number of Parts Due
Prepregs Construction Added?
Material Ply Specified
Material Type (ie Nelco-29, 370 HR, ...)

DRILL CHART: TOP to BOTTOM
ALL UNITS ARE IN MILS
SIZE

9. Packaging
and shipped in cardboard cratons with sufficient surrounding
material to prevend shipping damage.
10. Bow and Twist
Bow and twist to be .007 IN/IN or .090 max according to IPC-A-600D.
11. Inspection
12. Inside corners should be rounded-off
13. Changes to board geometries and apertures are not
allowed unless they are approved by customer.
14. Rounding is allowed on 90 degree corners with the size of
standard routing bit.

COMPANY NAME: ROHM SEMICONDUCTOR USA | UNLESS OTHERWISE SPECIFIED DIMENSIONS ARE IN INCHES TOLERANCES DECIMAL ANGLE X .1 30 XX .03 MACH FINISH XXX .010

DESIGNER: PTHVDC | PROJECT NAME: SENSOR PLATFORM_MULTISENSOR SHIELD BOARD
