ROHMUSDC/ROHM_SensorPlatform_Multi-Sensor-Shield/Documentation/CE Declaration of Conformity/technical_documentation/[9]_CarboardBoxLayout_LabelProofs/EvaluationBoardBoxDimensions.pdf

## 20.875in / 530.225mm

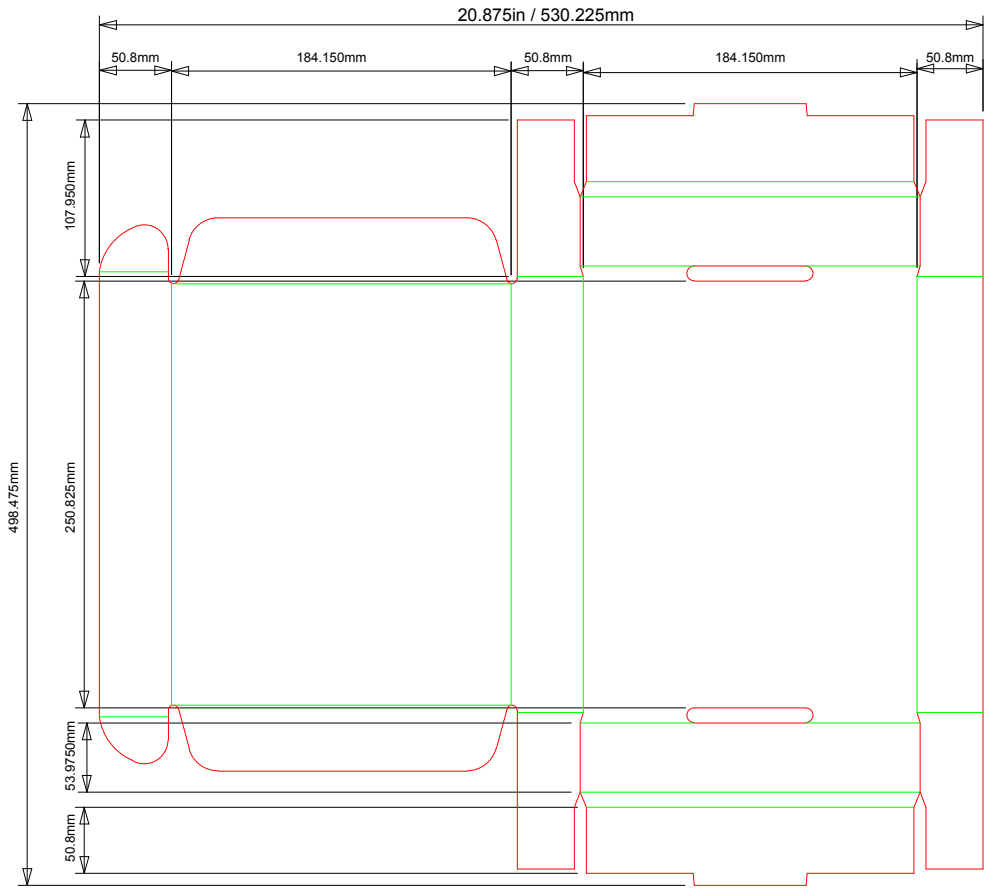
[picture p75: page 1]
