ROHMUSDC/ROHM_SensorPlatform_Multi-Sensor-Shield/HW Source Files/SENSORSHLD1-EVK-101 HW Design Files/Gerber/FAB/FAB_DRAWING.pdf

D

2

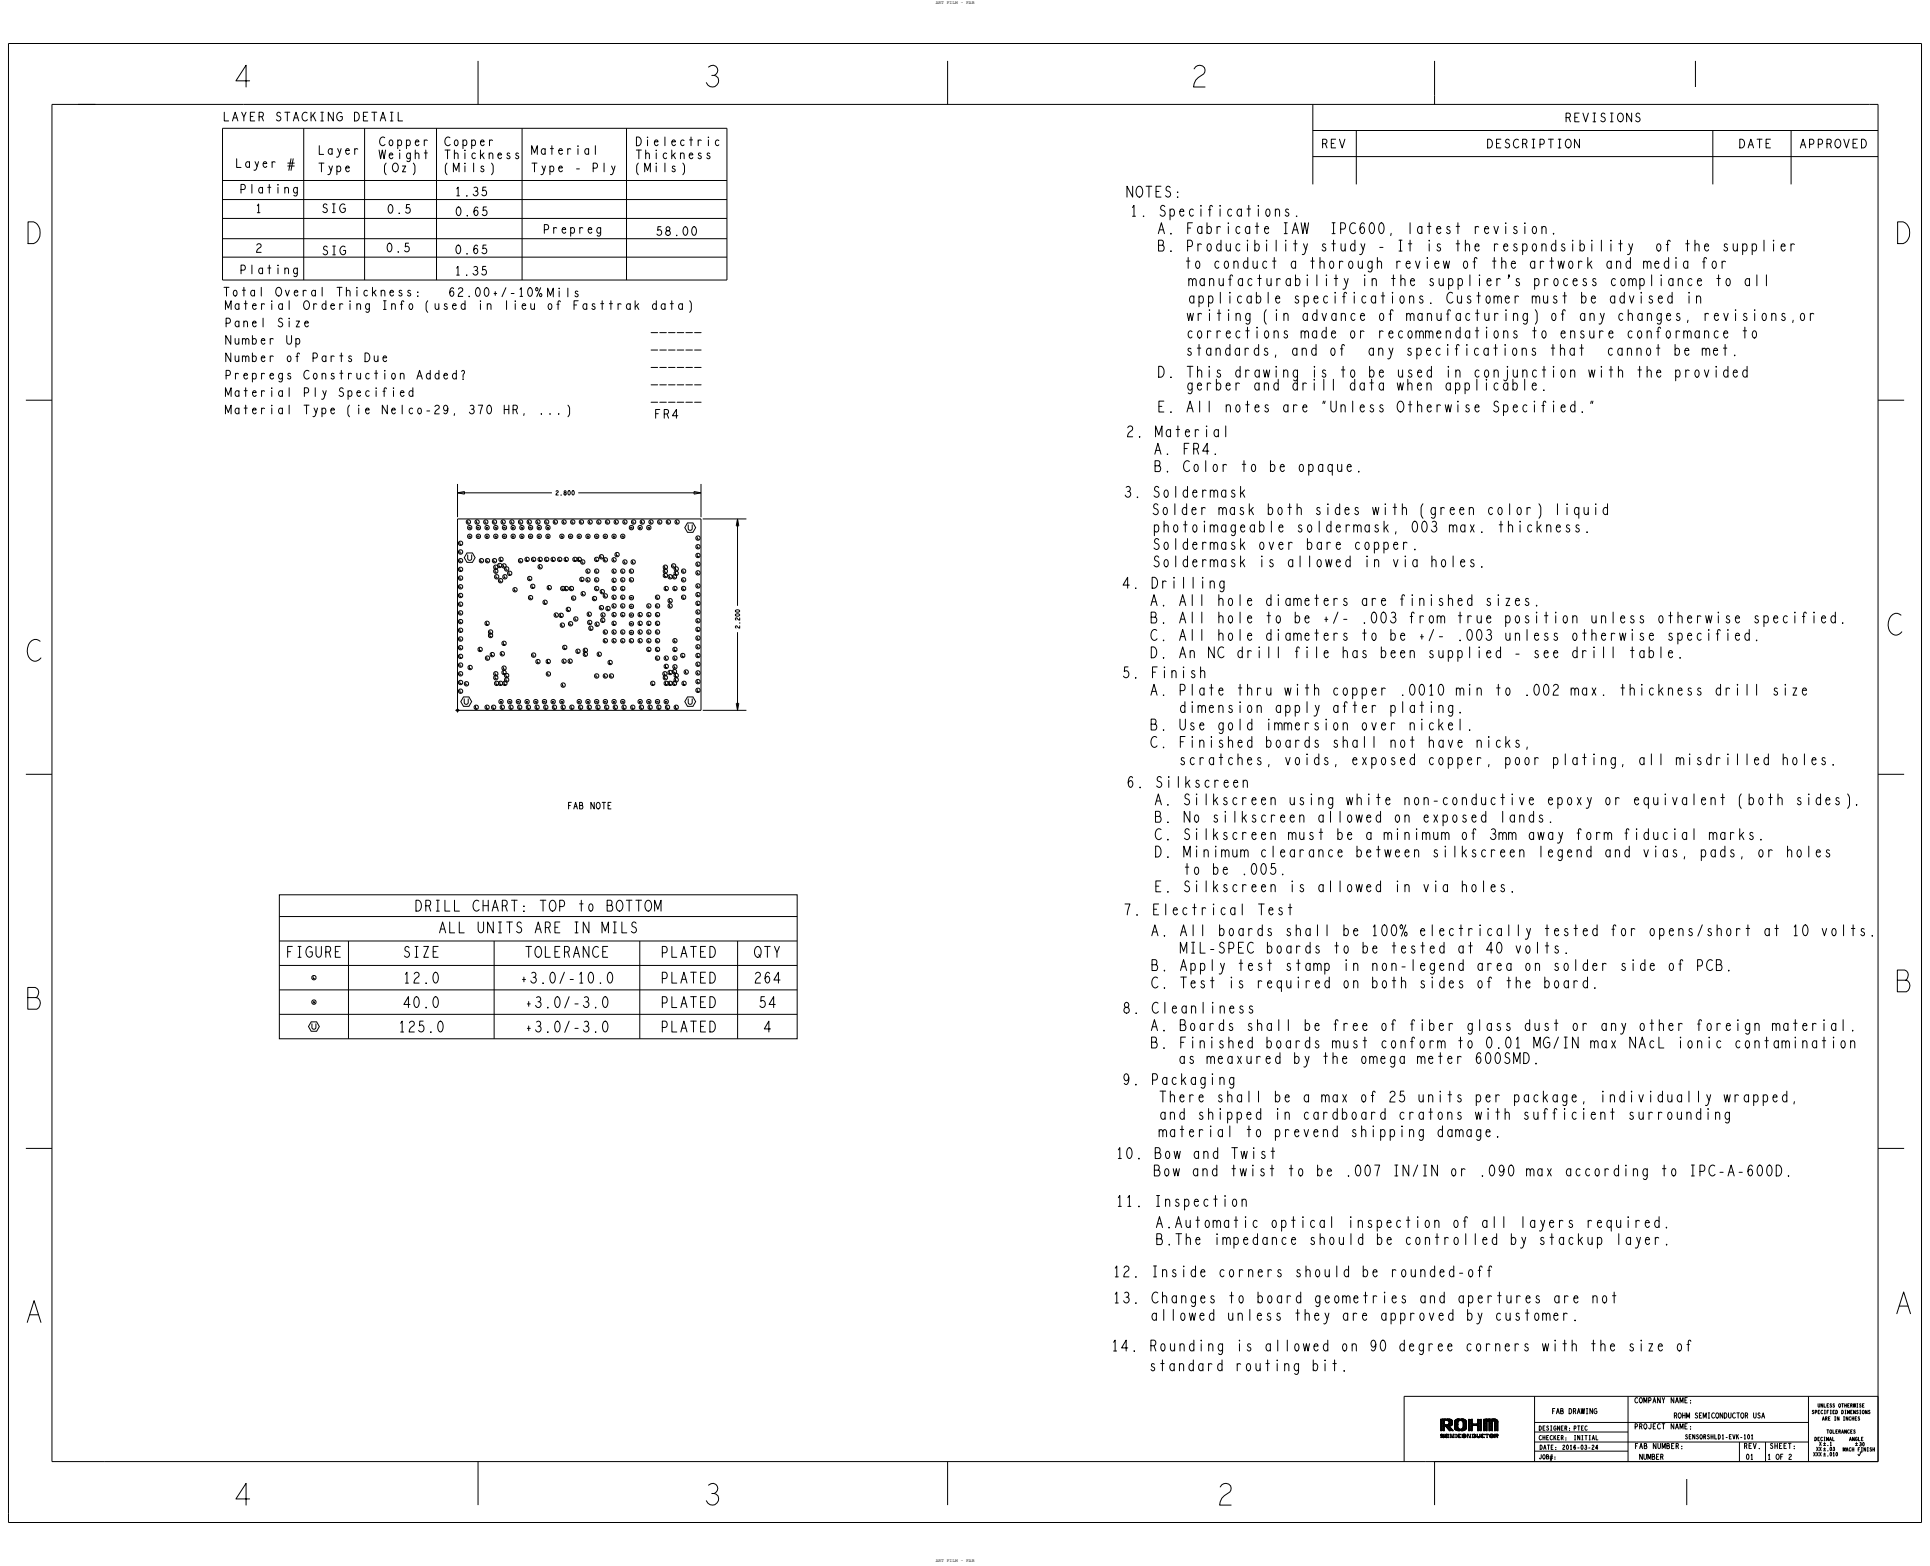
[picture p76: page 1]
TOLERANCES; MACH FINISH; ANGLE; APPROVED; XXX; DECIMAL X; SHEET:; DATE; REV.; SENSORSHLD1-EVK-101; ROHM; SEMICONDUCTOR USA; PROJECT; NAME:; COMPANY NAME:; NUMBER; FAB NUMBER:; PTEC; INITIAL; REVISIONS; DESIGNER:; FAB DRAWING; JOB#:; DATE:; CHECKER:; REV; DESCRIPTION; applicable; specifications.; Customer; must be; advised; standards, and of; any specifications that cannot; met.; B. Producibility study - It; is the respondsibility of the; supplier; corrections; made or; recommendations to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

ART FILM - FAB

LAYER STACKING DETAIL

NOTES:
1. Specifications.
A. Fabricate IAW IPC600, latest revision.

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

DRILL CHART: TOP to BOTTOM
ALL UNITS ARE IN MILS

10. Bow and Twist
Bow and twist to be .007 IN/IN or .090 max according to IPC-A-600D.

12. Inside corners should be rounded-off

13. Changes to board geometries and apertures are not
allowed unless they are approved by customer.

14. Rounding is allowed on 90 degree corners with the size of
standard routing bit.

UNLESS OTHERWISE
SPECIFIED DIMENSIONS
ARE IN INCHES
