ROHMUSDC/ROHM_SensorPlatform_Multi-Sensor-Shield/HW Source Files/SENSORSHLD0-EVK-101 HW Design Files/PCB_Layout/REV00.1/FAB_DRAWING.pdf

D

2

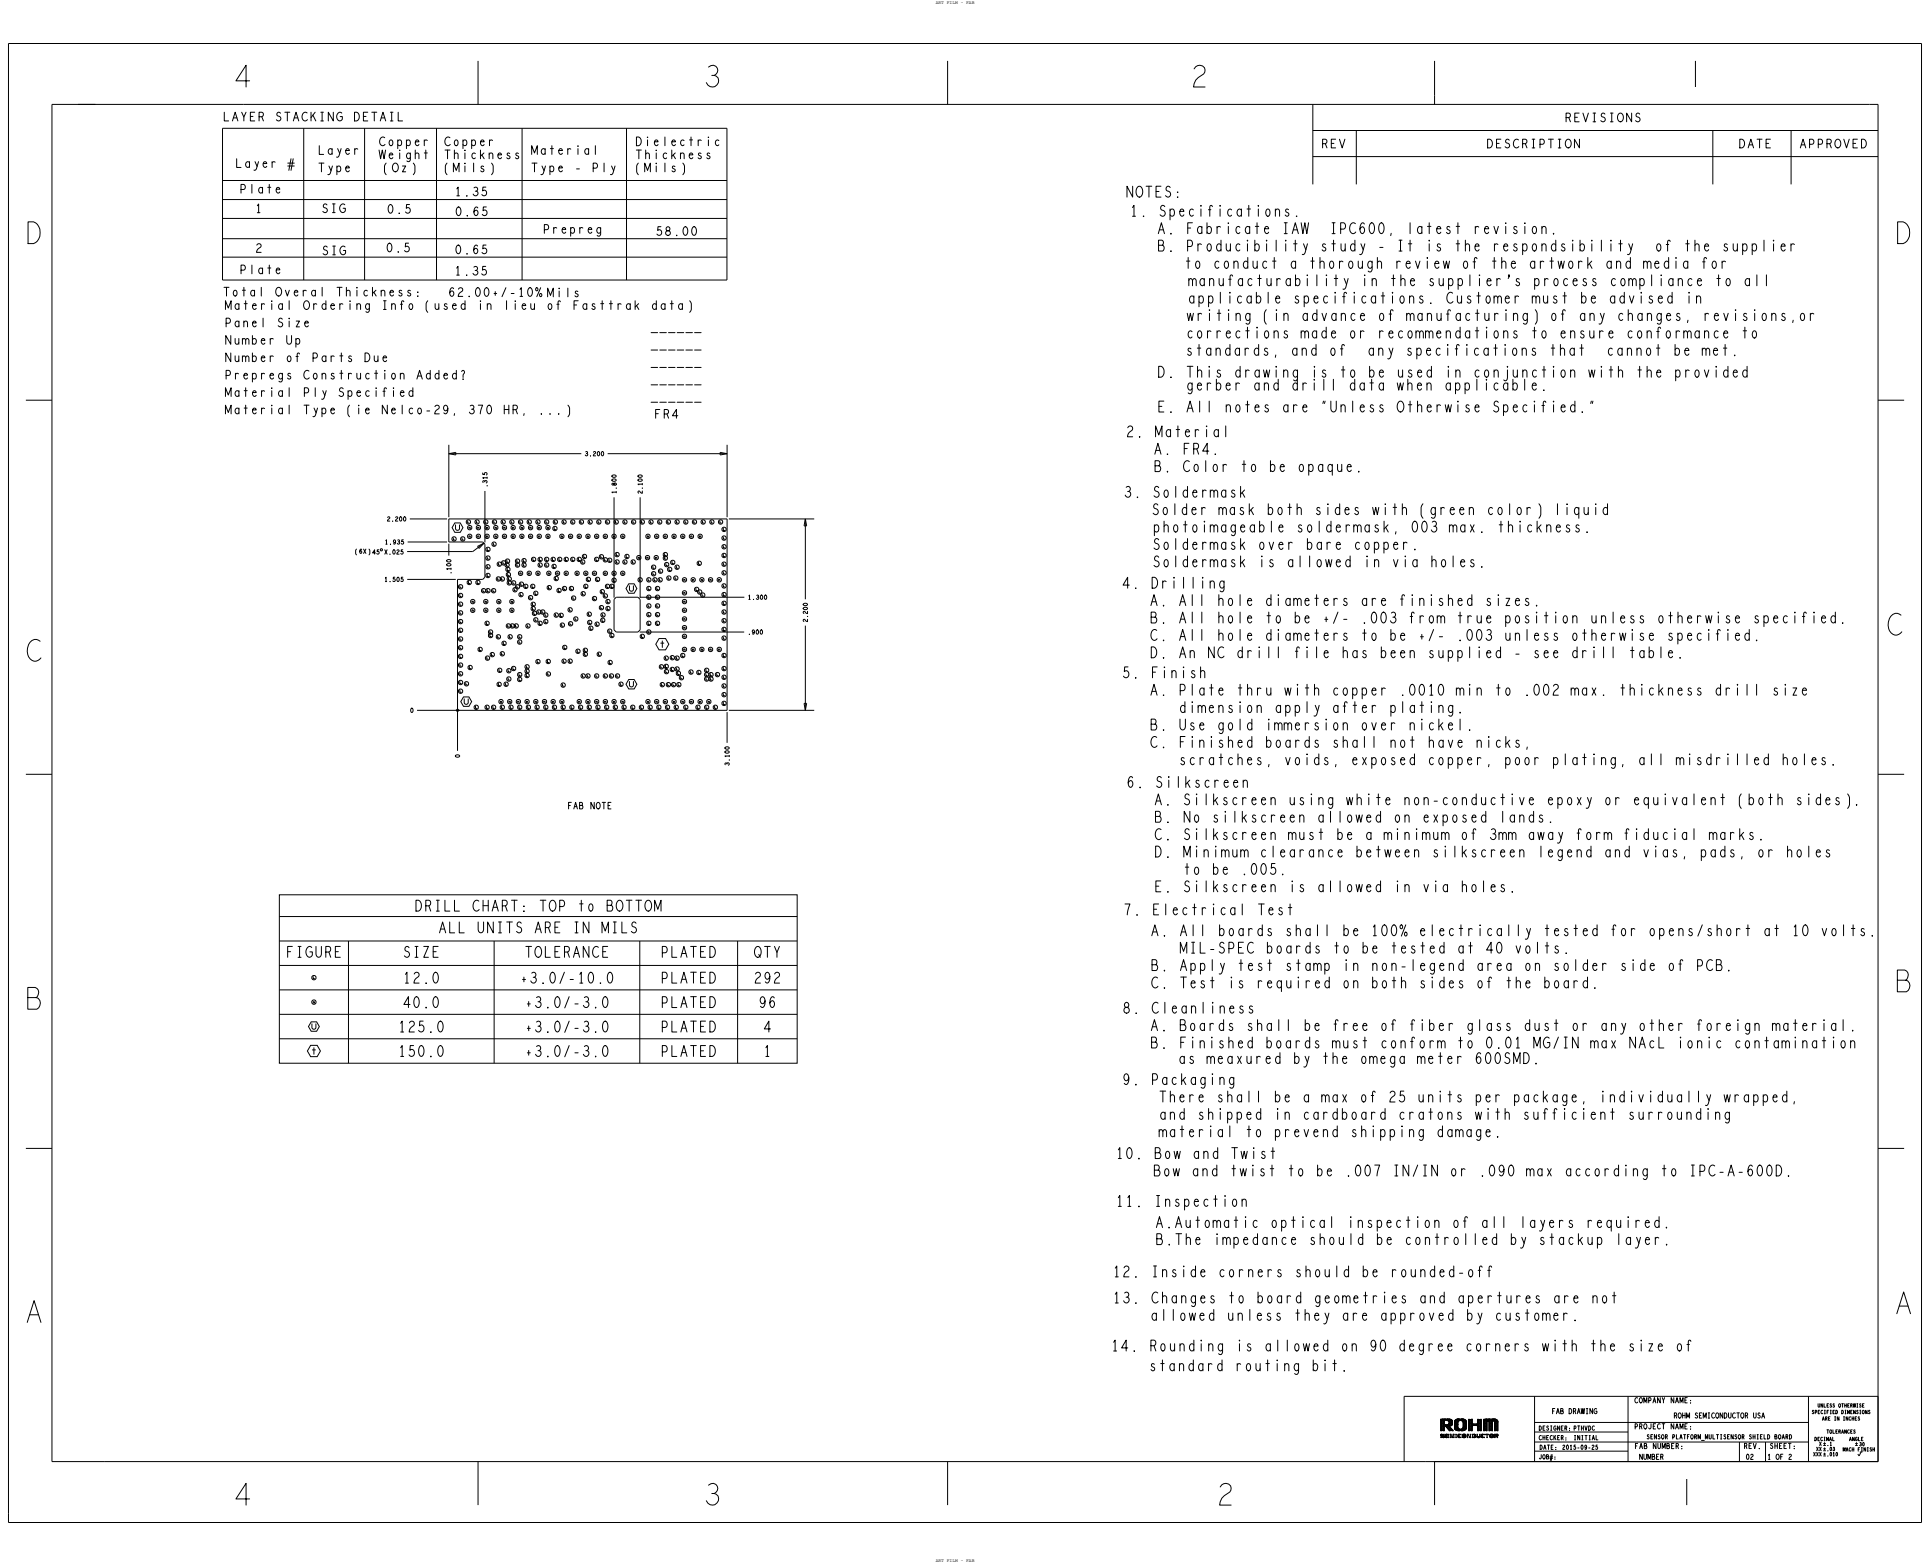
[picture p77: page 1]
MACH FINISH; ANGLE; APPROVED; XXX; DECIMAL; TOLERANCES; SHEET:; DATE; REV.; ROHM; SEMICONDUCTOR USA; COMPANY NAME:; PROJECT; NAME:; REVISIONS; INITIAL; PTHVDC; FAB DRAWING; JOB#:; DATE:; CHECKER:; DESIGNER:; REV; DESCRIPTION; applicable; specifications.; Customer; must be; advised; standards, and of; any specifications that cannot; met.; B. Producibility study - It; is the respondsibility of the; supplier; corrections; made or; recommendations to; ensure; conformance to; D. This; drawing; used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

ART FILM - FAB

LAYER STACKING DETAIL

NOTES:
1. Specifications.
A. Fabricate IAW IPC600, latest revision.

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

DRILL CHART: TOP to BOTTOM
ALL UNITS ARE IN MILS

8. Cleanliness
B. Finished boards must conform to 0.01 MG/IN max NAcL ionic contamination
as meaxured by the omega meter 600SMD.

10. Bow and Twist
Bow and twist to be .007 IN/IN or .090 max according to IPC-A-600D.

12. Inside corners should be rounded-off

13. Changes to board geometries and apertures are not
allowed unless they are approved by customer.

14. Rounding is allowed on 90 degree corners with the size of
standard routing bit.

UNLESS OTHERWISE
SPECIFIED DIMENSIONS
ARE IN INCHES

SENSOR PLATFORM_MULTISENSOR SHIELD BOARD
FAB NUMBER:
NUMBER
