ROHMUSDC/ROHM_SensorPlatform_Multi-Sensor-Shield/HW Source Files/SENSORSHLD0-EVK-101 HW Design Files/Schematic_BOM/Revision 00.1/ROHM_SENSORSHLD1-EVK-101_SCH__REV00.1_2015-09-22.pdf

# ROHM Sensor Platform MultiSensor Shield

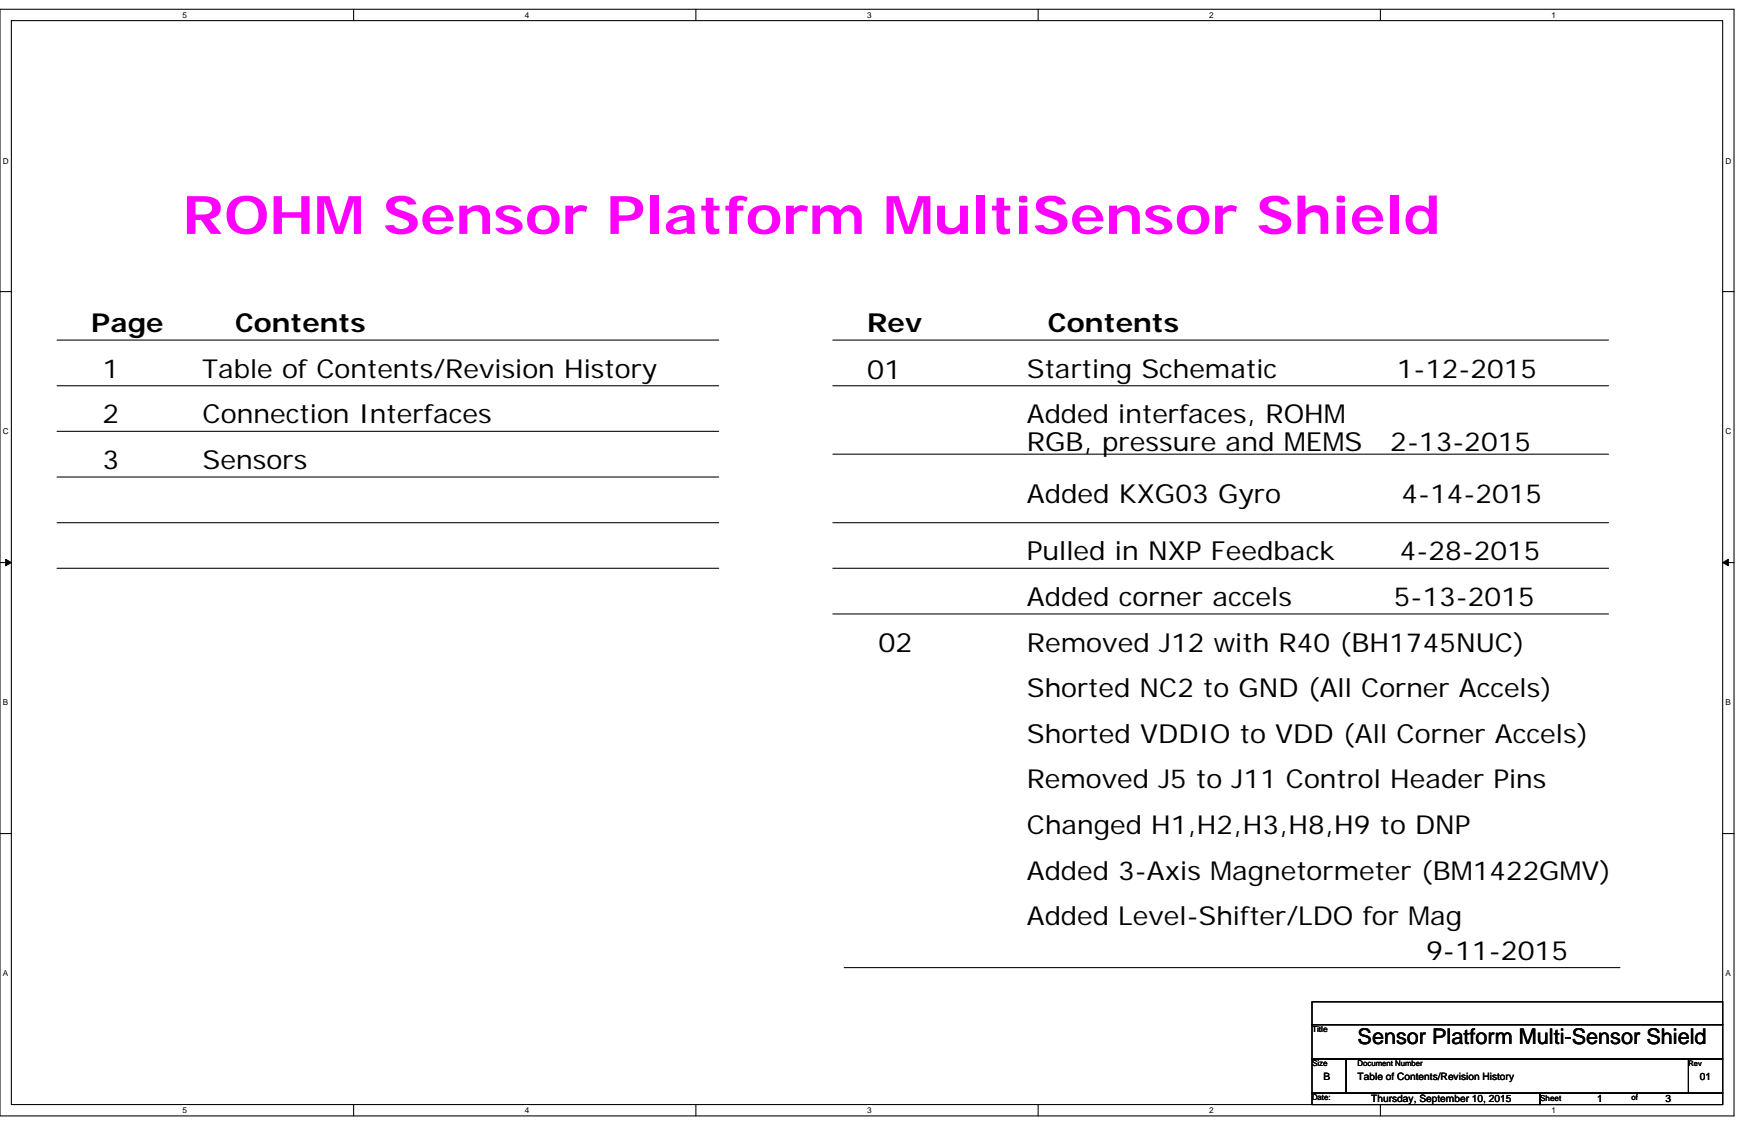
[picture p78: page 1]
Page; Contents; Table of Contents/Revision History; Rev; Starting Schematic; Sensors; Connection Interfaces; Added interfaces, ROHM; Added KXG03 Gyro; Pulled in NXP Feedback; Added corner accels; Removed J12 with R40 (BH1745NUC); Title

RGB, pressure and MEMS 2-13-2015

Shorted NC2 to GND (All Corner Accels)
Shorted VDDIO to VDD (All Corner Accels)
Removed J5 to J11 Control Header Pins
Changed H1,H2,H3,H8,H9 to DNP
Added 3-Axis Magnetormeter (BM1422GMV)
Added Level-Shifter/LDO for Mag

Sensor Platform Multi-Sensor Shield

Size Size Size B B B | Document Number Document Number Document Number Table of Contents/Revision History Table of Contents/Revision History Table of Contents/Revision History | Rev Rev Rev 01 01 01

Date: Date: Date: Thursday, September 10, 2015 Thursday, September 10, 2015 Thursday, September 10, 2015 | Sheet Sheet Sheet 1 1 1 of of of 3 3 3

# Hall Sensor BU52014HFV

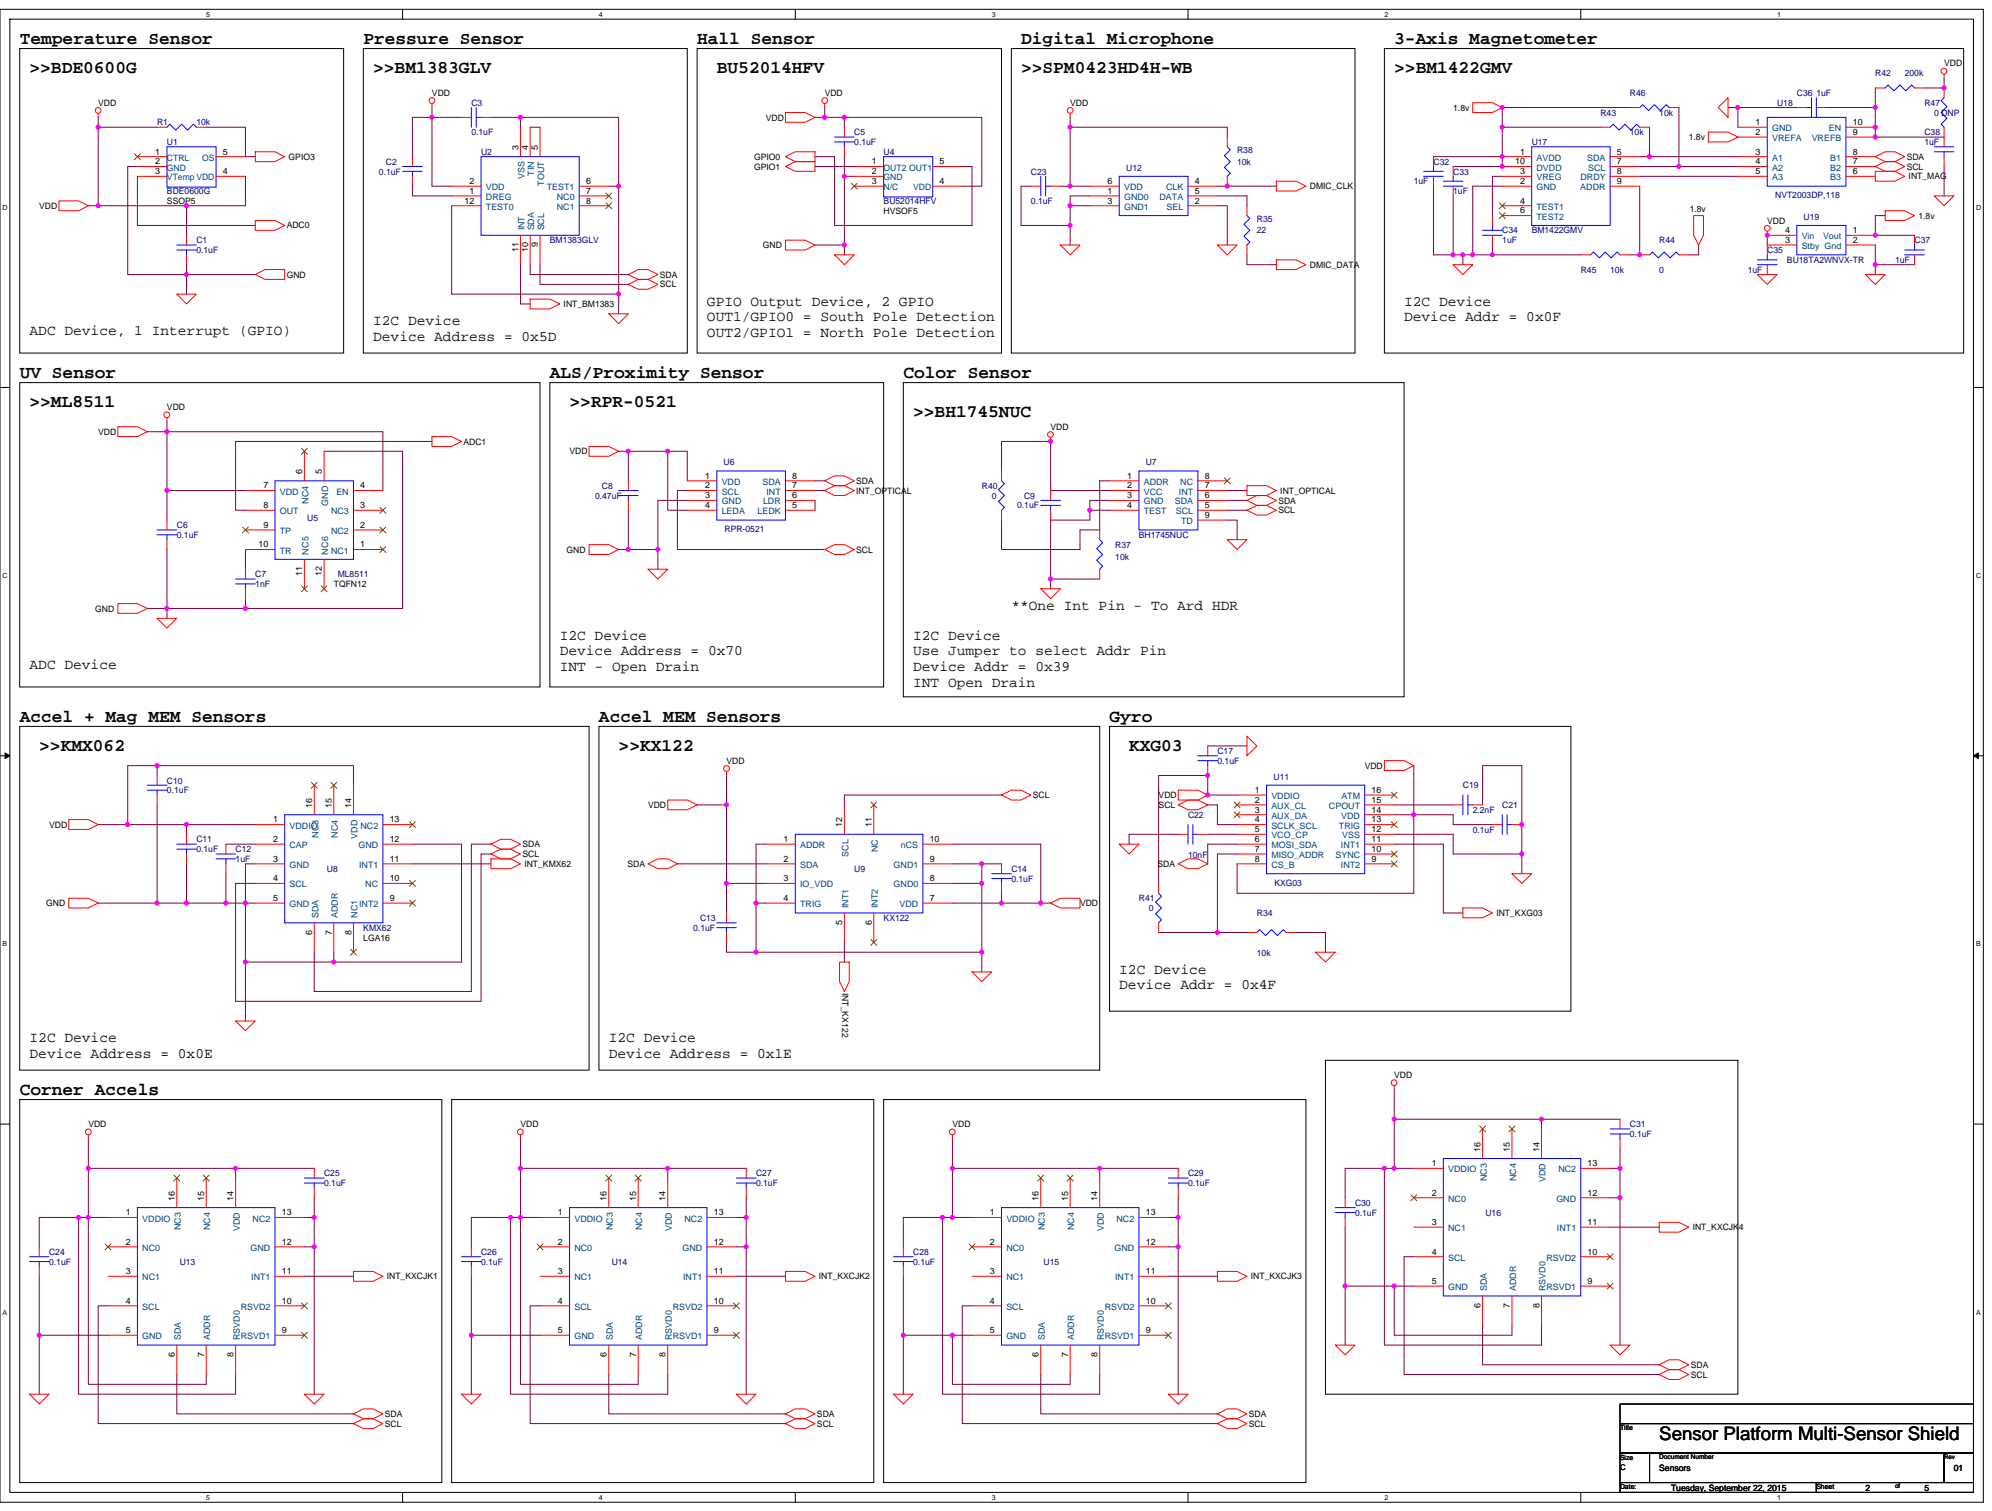
[picture p79: page 2]

SDA
SCL
GPIO Output Device, 2 GPIO
OUT1/GPIO0 = South Pole Detection
OUT2/GPIO1 = North Pole Detection

ADC Device, 1 Interrupt (GPIO)

**One Int Pin - To Ard HDR

I2C Device
Use Jumper to select Addr Pin
Device Addr = 0x39
INT Open Drain

Accel + Mag MEM Sensors
>>KMX062

Sensor Platform Multi-Sensor Shield

# Common Platform Header Pins (Shield Layout)

# Sensor Platform Header Pins

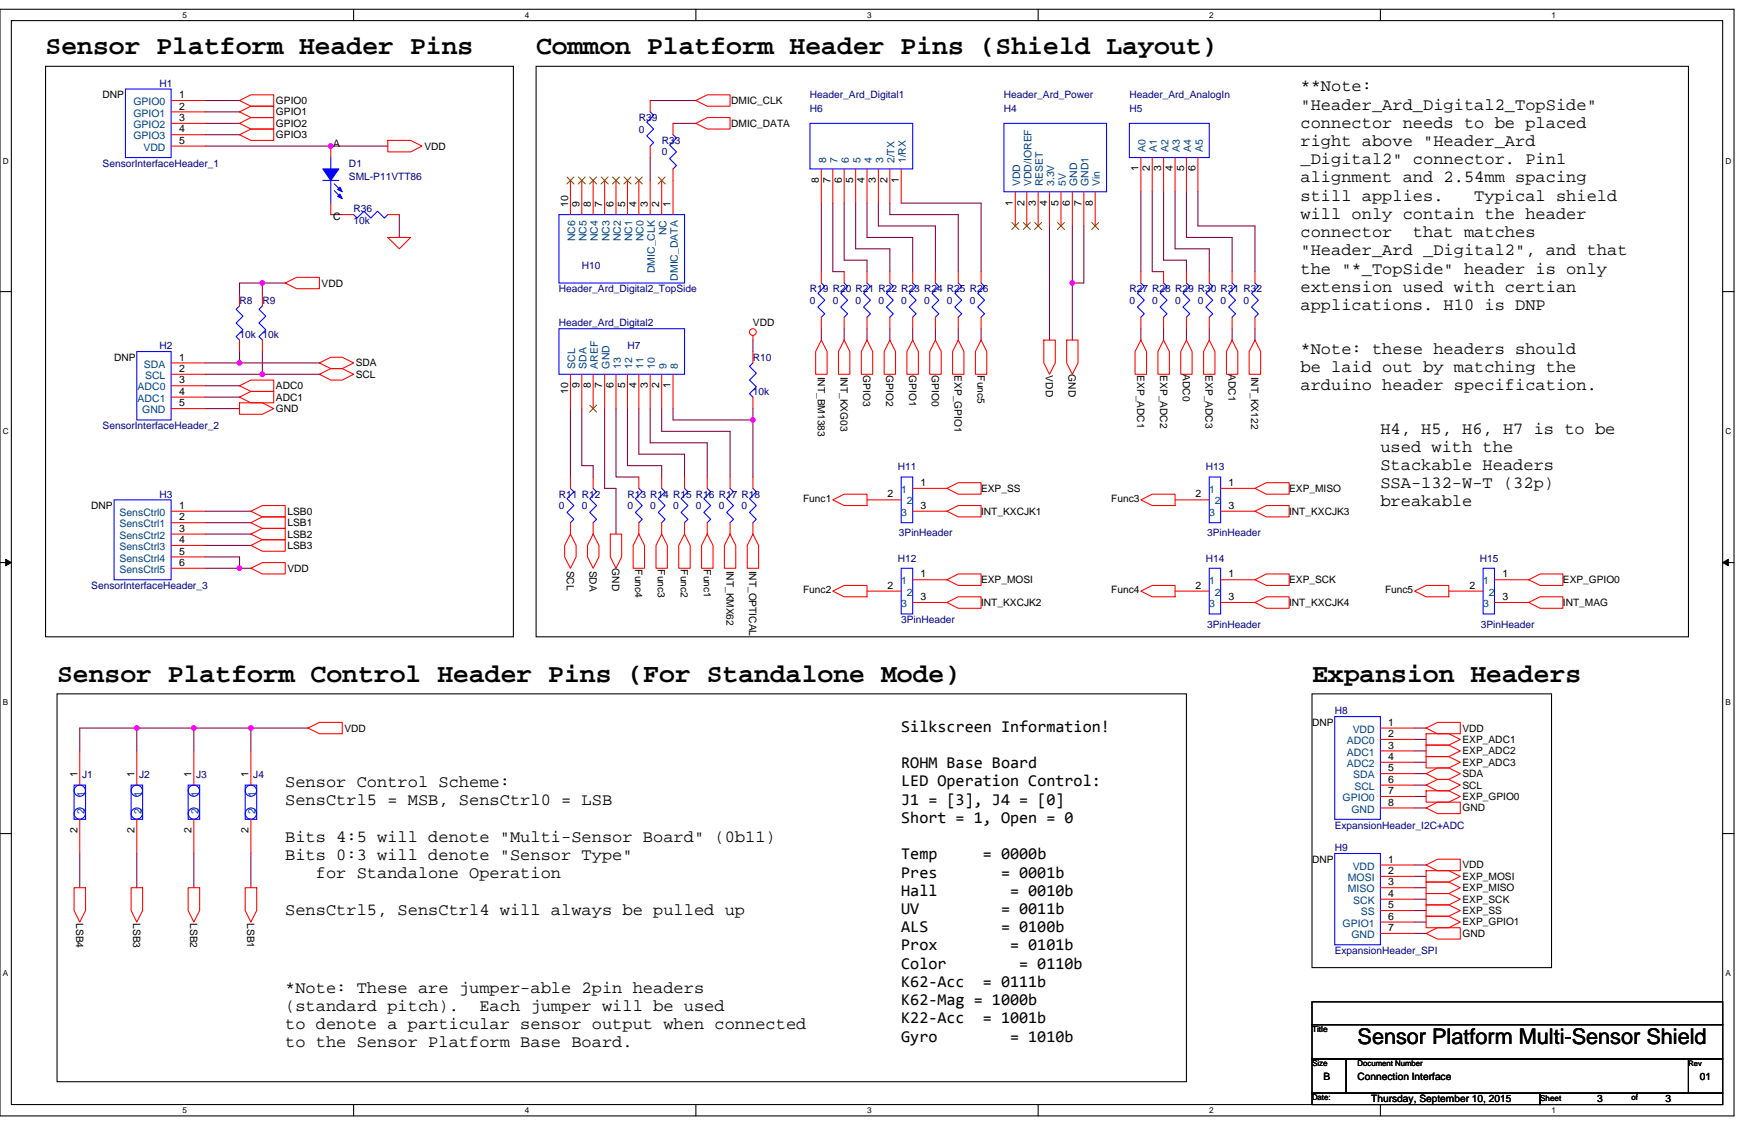
[picture p80: page 3]

alignment and 2.54mm spacing
will only contain the header
connector that matches
"Header_Ard _Digital2", and that
the "*_TopSide" header is only
extension used with certian

2 10 3 11 4 12 5 13 6 GND 7 AREF 8 SDA 9 SCL 10

*Note: these headers should
be laid out by matching the
arduino header specification.

Sensor Platform Control Header Pins (For Standalone Mode)

Sensor Control Scheme:
SensCtrl5 = MSB, SensCtrl0 = LSB
Bits 4:5 will denote "Multi-Sensor Board" (0b11)
Bits 0:3 will denote "Sensor Type"
for Standalone Operation
SensCtrl5, SensCtrl4 will always be pulled up

*Note: These are jumper-able 2pin headers
(standard pitch). Each jumper will be used
to denote a particular sensor output when connected
to the Sensor Platform Base Board.

Sensor Platform Multi-Sensor Shield

Size Size Size B B B | Document Number Document Number Document Number Connection Interface Connection Interface Connection Interface | Rev Rev Rev 01 01 01

Date: Date: Date: Thursday, September 10, 2015 Thursday, September 10, 2015 Thursday, September 10, 2015 | Sheet Sheet Sheet 3 3 3 of of of 3 3 3
