ROHMUSDC/ROHM_SensorPlatform_Multi-Sensor-Shield/Documentation/CE Declaration of Conformity/technical_documentation/[9]_CarboardBoxLayout_LabelProofs/SENSORSHLD1-EVK-101_MainLabelProof.pdf

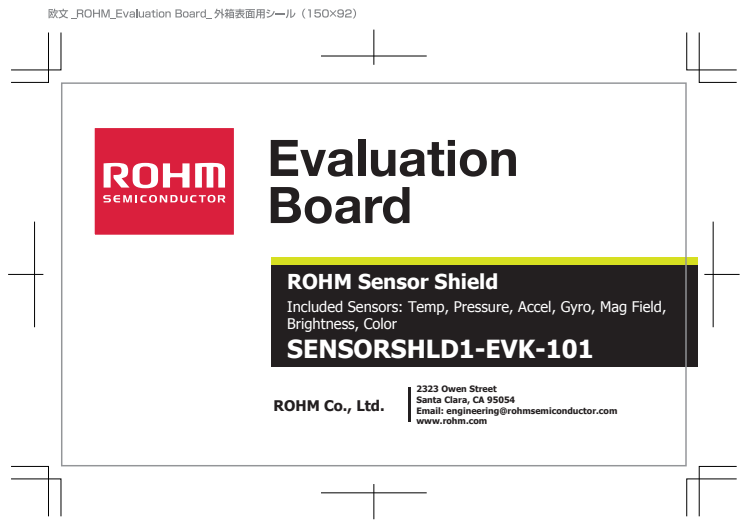
[picture p81: page 1]

ROHM Sensor Shield
Included Sensors: Temp, Pressure, Accel, Gyro, Mag Field,
Brightness, Color
SENSORSHLD1-EVK-101

2323 Owen Street
Santa Clara, CA 95054
Email: engineering@rohmsemiconductor.com
www.rohm.com

ROHM Co., Ltd.
