ROHMUSDC/ROHM_SensorPlatform_Multi-Sensor-Shield/HW Source Files/SENSORSHLD0-EVK-101 HW Design Files/PCB_Layout/BOTTOM_VIEW.pdf

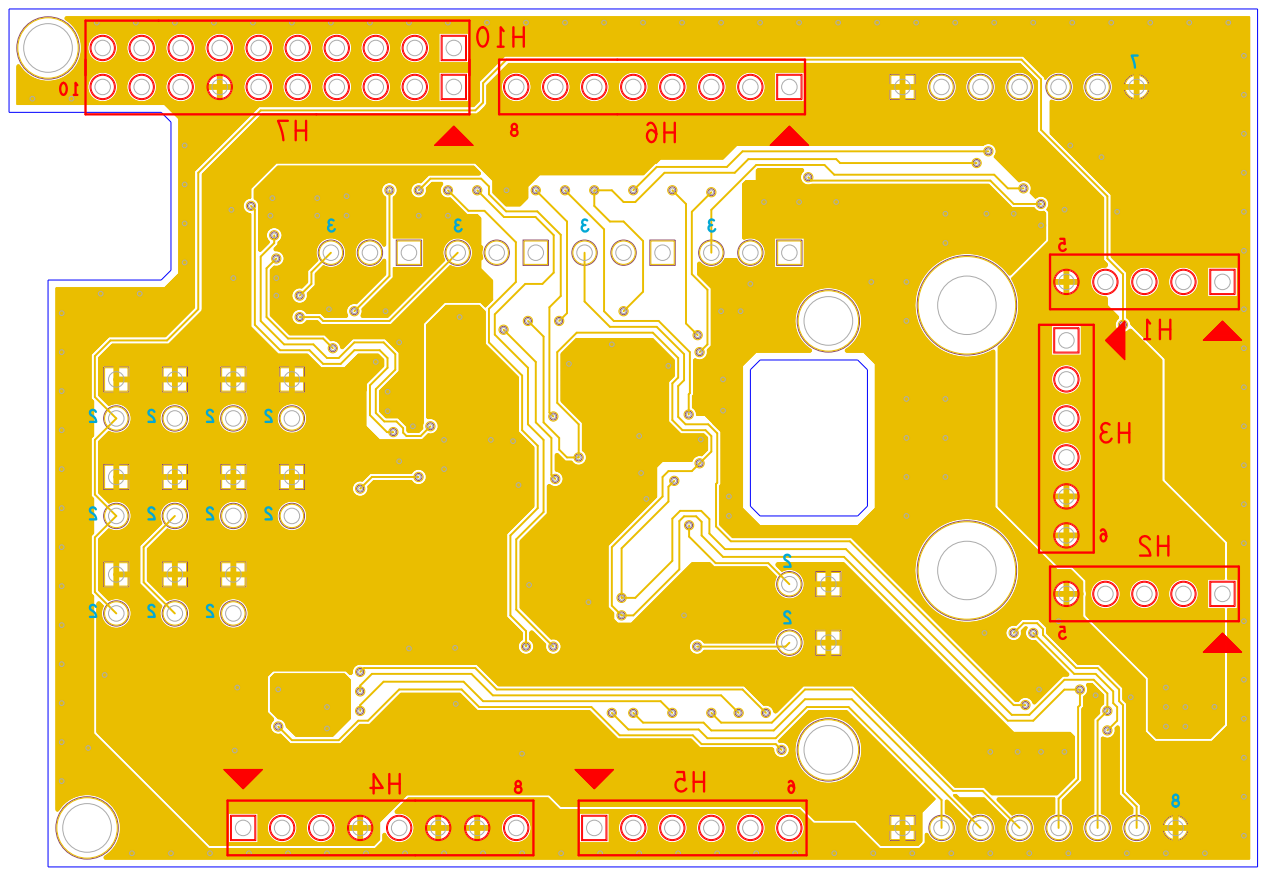
[picture p82: page 1]
