ROHMUSDC/ROHM_SensorPlatform_Multi-Sensor-Shield/HW Source Files/SENSORSHLD0-EVK-101 HW Design Files/PCB_Layout/TOP_VIEW.pdf

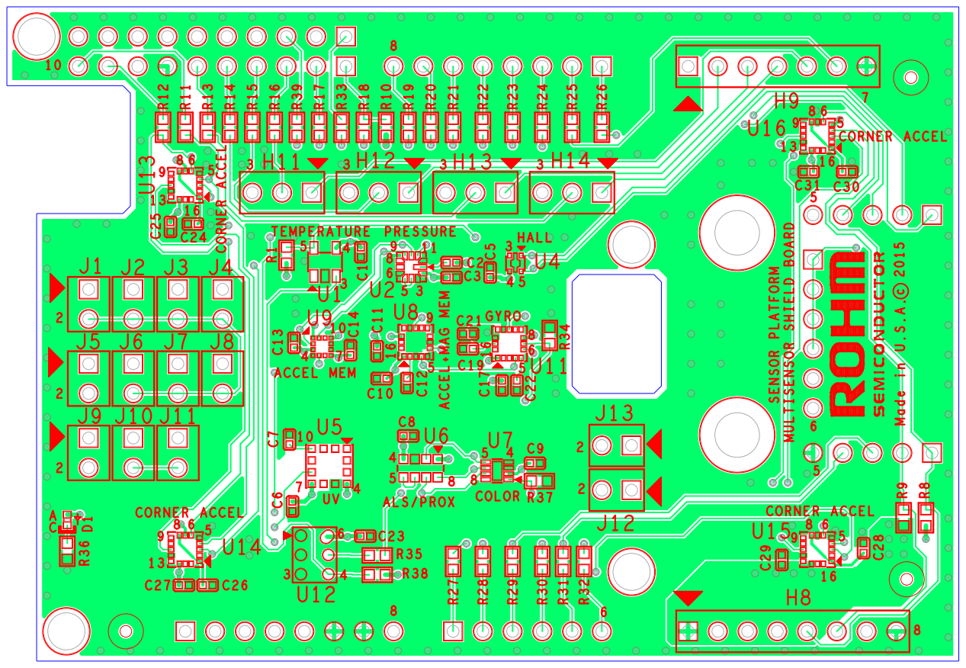
[picture p83: page 1]
