ROHMUSDC/ROHM_SensorPlatform_Multi-Sensor-Shield/HW Source Files/SENSORSHLD1-EVK-101 HW Design Files/Gerber/ASSY/ASSY_BOTTOM.pdf

D

DATE | APPROVED

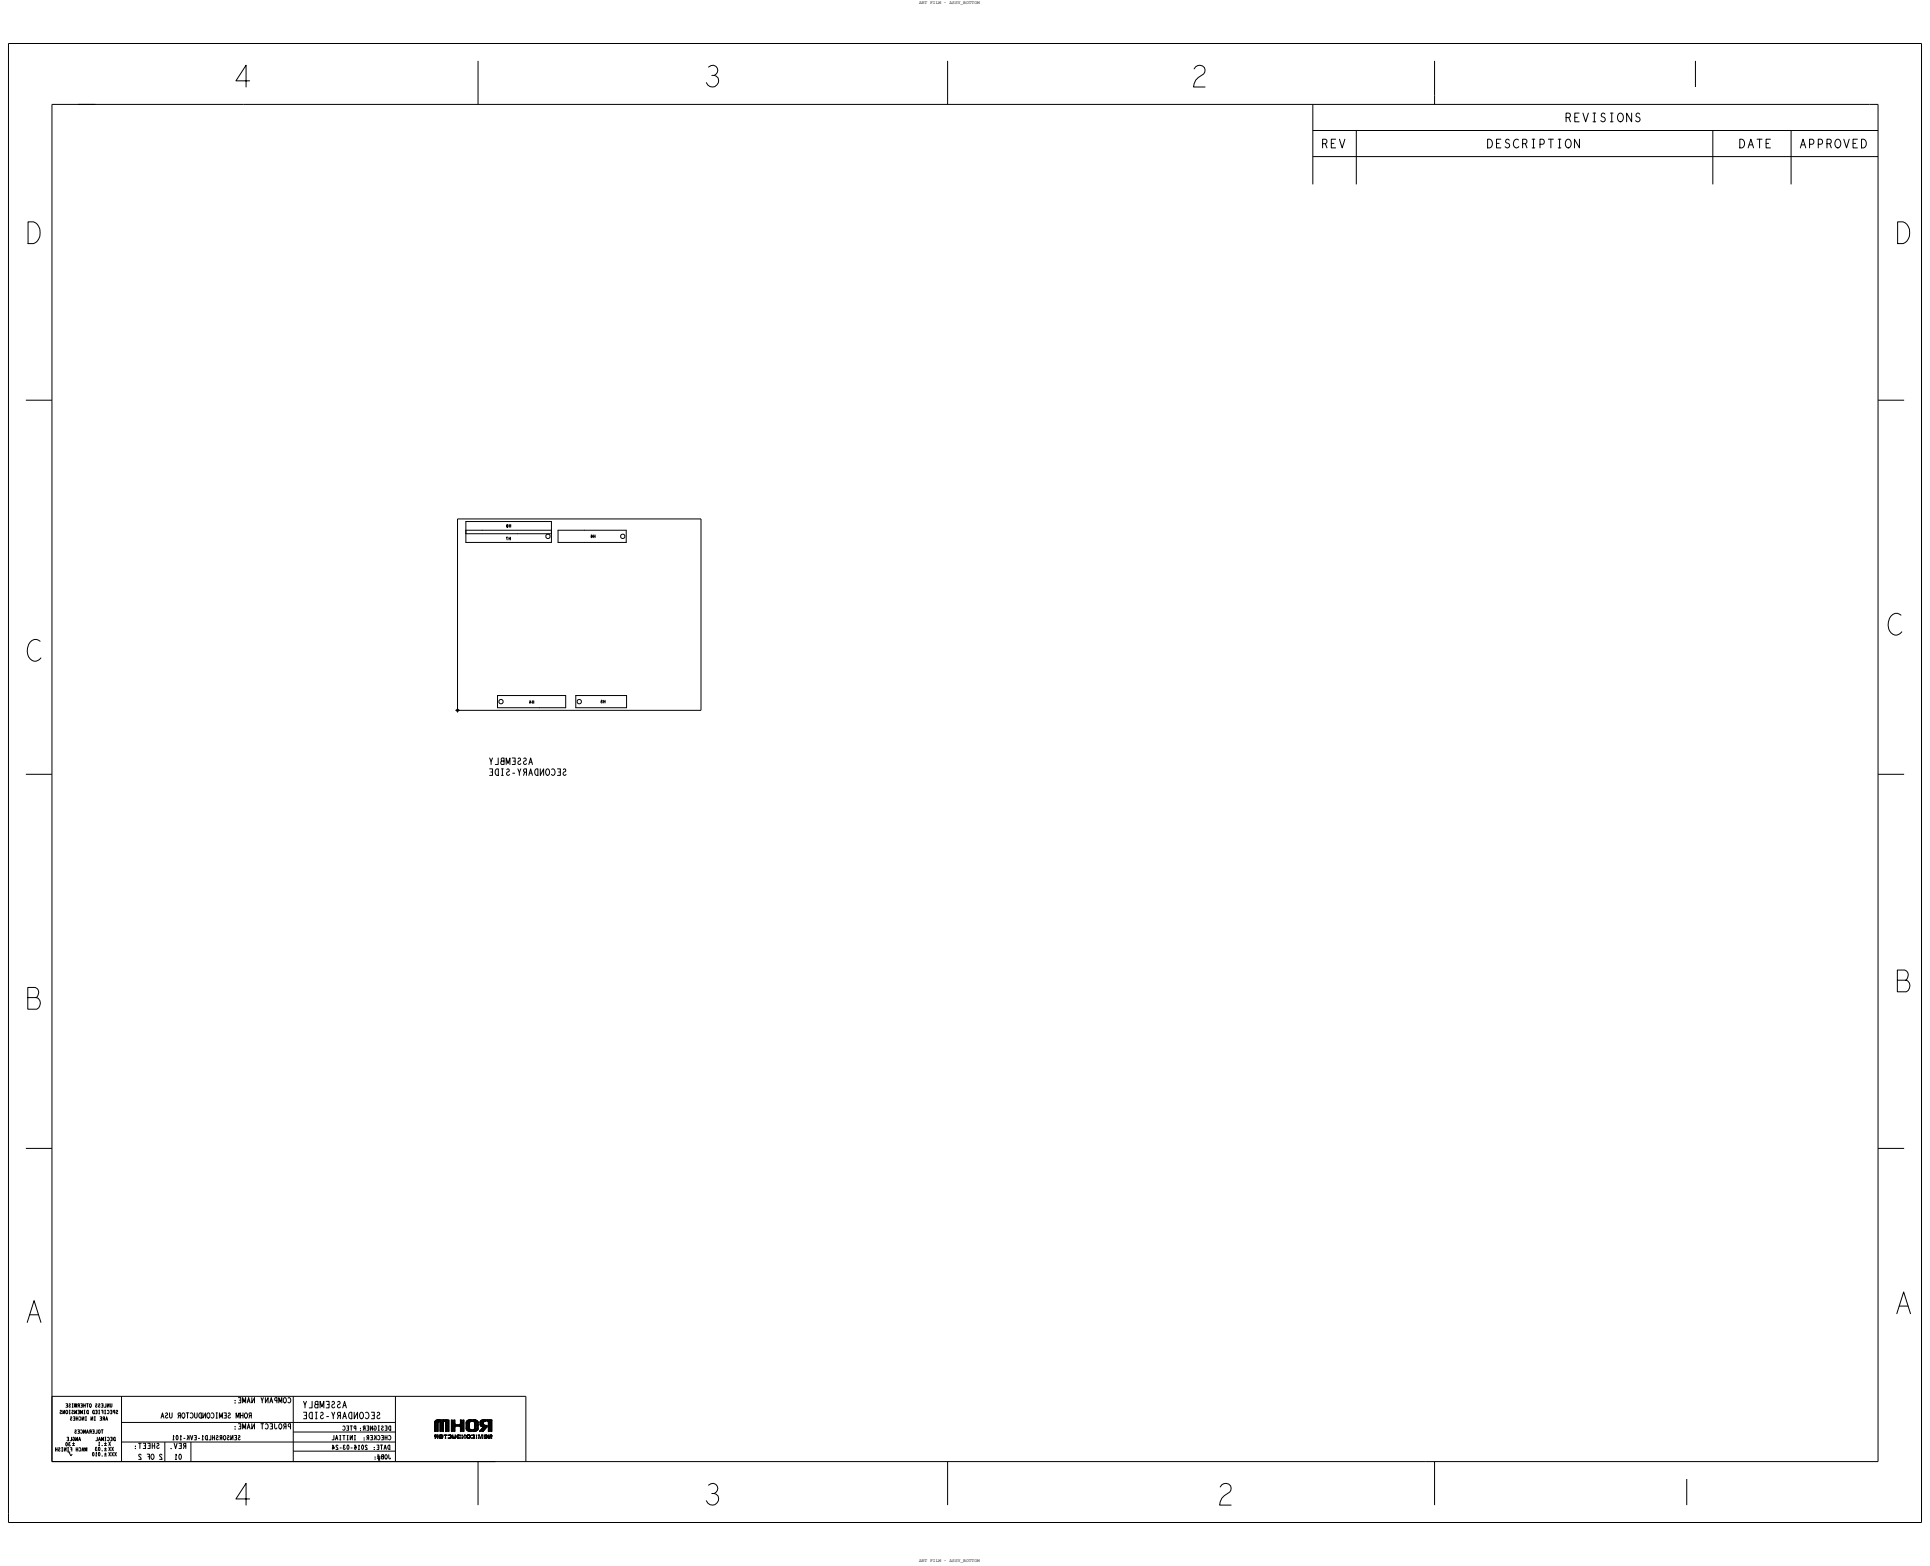
[picture p84: page 1]
ART FILM - ASSY_BOTTOM; REVISIONS; REV; DESCRIPTION
