ROHMUSDC/ROHM_SensorPlatform_Multi-Sensor-Shield/HW Source Files/SENSORSHLD1-EVK-101 HW Design Files/Gerber/ASSY/ASSY_TOP.pdf

# ART FILM - ASSY_TOP

D

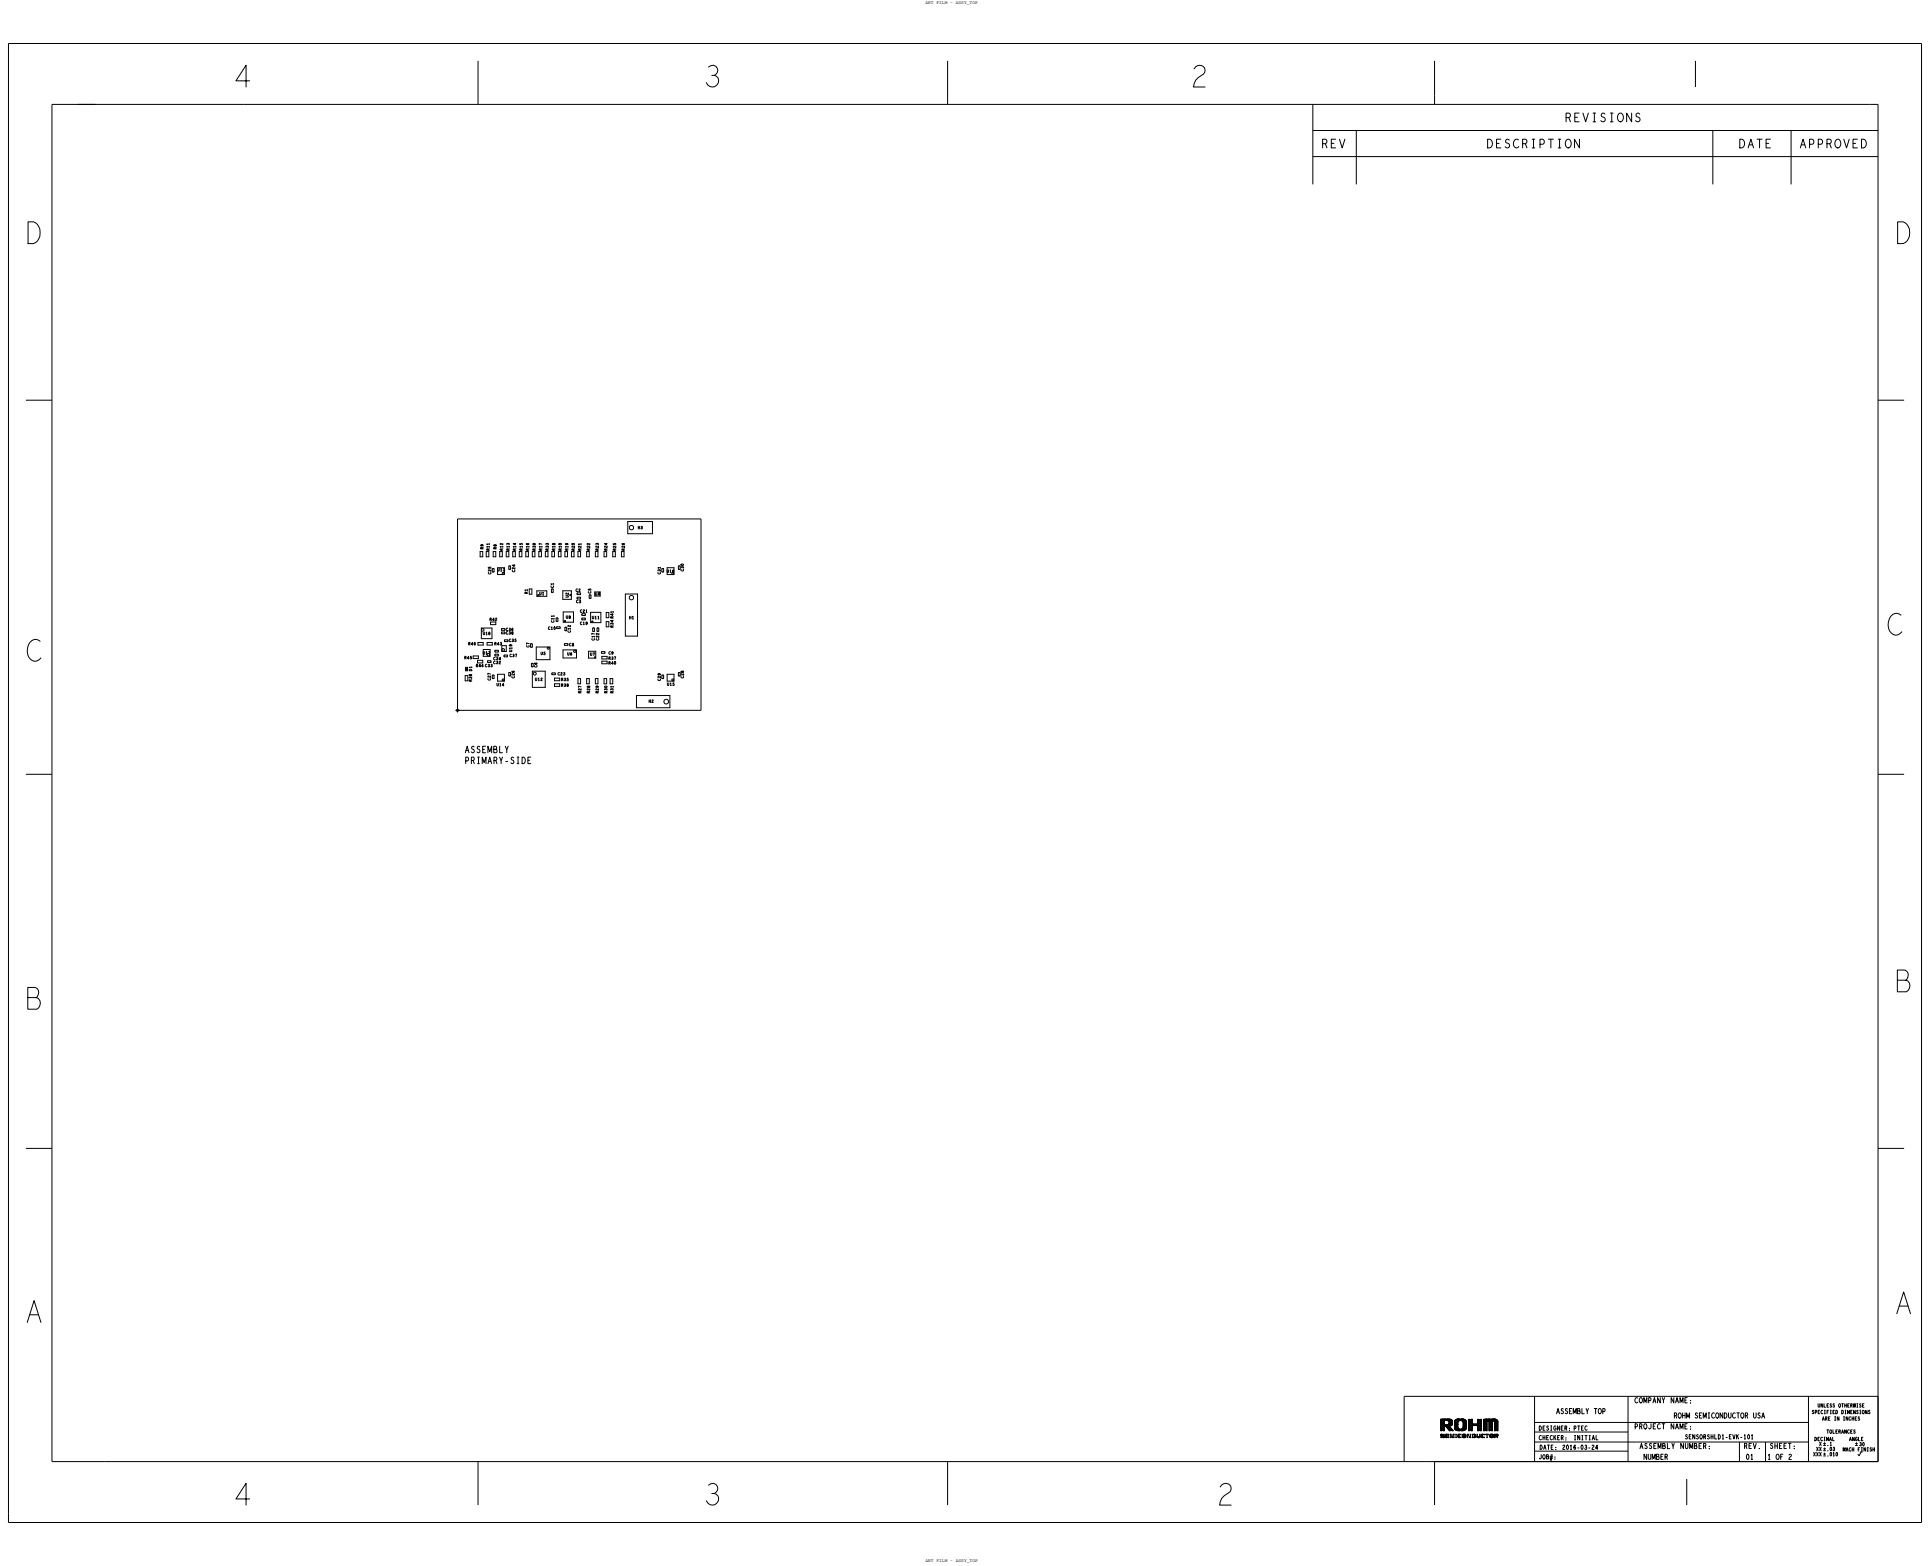
[picture p85: page 1]

REVISIONS

APPROVED
