ROHMUSDC/ROHM_SensorPlatform_Multi-Sensor-Shield/HW Source Files/SENSORSHLD0-EVK-101 HW Design Files/PCB_Layout/REV00.1/BOTTOM_VIEW.pdf

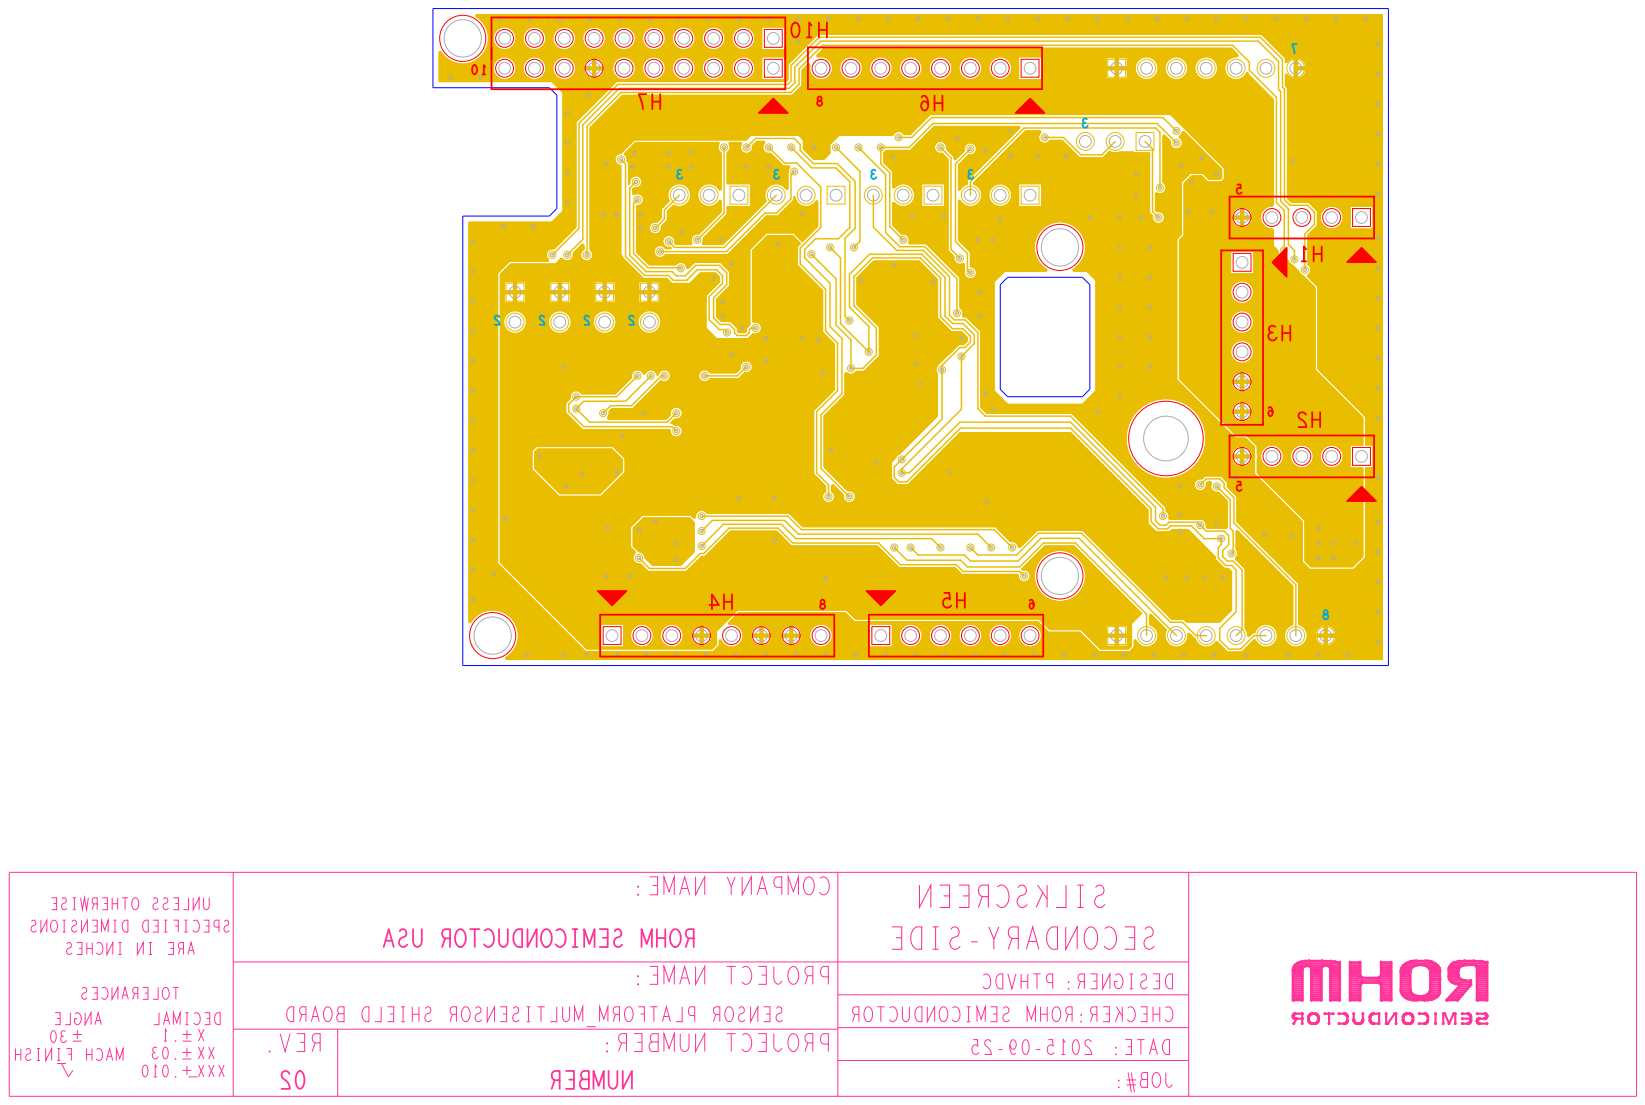
[picture p86: page 1]
