ROHMUSDC/ROHM_SensorPlatform_Multi-Sensor-Shield/Documentation/CE Declaration of Conformity/technical_documentation/[9]_CarboardBoxLayout_LabelProofs/SENSORSHLD1-EVK-101_SideLabelProof.pdf

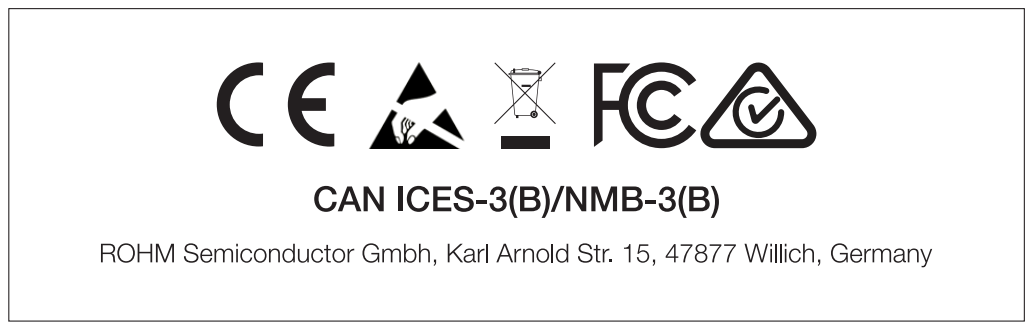
[picture p88: page 1]
