ROHMUSDC/ROHM_SensorPlatform_Multi-Sensor-Shield/(list of files, drawings)

Other design files:
HW Source Files/SENSORSHLD0-EVK-101 HW Design Files/Schematic_BOM/Revision 00.1/ROHM_SENSORSHLD1-EVK-101_SCH_REV00.1_2015-09-22.DSN
HW Source Files/SENSORSHLD0-EVK-101 HW Design Files/Schematic_BOM/ROHM_SENSORSHLD0-EVK-101_SCH_REV00_2015-05-18.DSN
HW Source Files/SENSORSHLD1-EVK-101 HW Design Files/Schematic_BOM/ROHM_SENSORSHLD1-EVK-101_SCH_REV01_2016-03-16.DSN
