ROHMUSDC/ROHM_SensorPlatform_Multi-Sensor-Shield/Platform Code/LAPIS_SensorPlatform_Firmware/Firmware/_output/_obj/main.asm

;; Compile Options : /TML610112 /MS /near /Icommon /Imain /Iirq /Itimer /Iclock /Itbc /Iuart /Ii2c /SS 256 /SD /Oa /Ot /W 3 /Wc /Fa_output\_obj\ 
;; Version Number  : Ver.3.41.8
;; File Name       : main.c

	type (ML610112) 
	model small, near
	$$NVARmain segment data 2h #0h
	$$NINITVAR segment data 2h #0h
	$$NINITTAB segment table 2h any
	$$NTABmain segment table 2h #0h
	$$ADC_Read$main segment code 2h #0h
	$$DeviceSelection$main segment code 2h #0h
	$$FlashLEDs$main segment code 2h #0h
	$$I2C_Read$main segment code 2h #0h
	$$I2C_Write$main segment code 2h #0h
	$$Init_ALS_PROX_Sensor_11$main segment code 2h #0h
	$$Init_Ambient_Light_Sensor_5$main segment code 2h #0h
	$$Init_Ambient_Light_Sensor_6$main segment code 2h #0h
	$$Init_Ambient_Light_Sensor_7$main segment code 2h #0h
	$$Init_Ambient_Light_Sensor_8$main segment code 2h #0h
	$$Init_Ambient_Light_Sensor_9$main segment code 2h #0h
	$$Init_Color_Sensor_4$main segment code 2h #0h
	$$Init_Hall_Effect_Sensors_1$main segment code 2h #0h
	$$Init_Hall_Effect_Sensors_2$main segment code 2h #0h
	$$Init_KMX61$main segment code 2h #0h
	$$Init_KX022$main segment code 2h #0h
	$$Init_KXG03_Sensor_12$main segment code 2h #0h
	$$Init_Pressure_Sensor_3$main segment code 2h #0h
	$$Init_Temperature_Sensor_20$main segment code 2h #0h
	$$Init_Temperature_Sensor_21$main segment code 2h #0h
	$$Init_Temperature_Sensor_22$main segment code 2h #0h
	$$Init_Temperature_Sensor_23$main segment code 2h #0h
	$$Init_UV_Sensor_10$main segment code 2h #0h
	$$Initialization$main segment code 2h #0h
	$$MainOp_ALS_PROX_Sensor_11$main segment code 2h #0h
	$$MainOp_Ambient_Light_Sensor_5$main segment code 2h #0h
	$$MainOp_Ambient_Light_Sensor_6$main segment code 2h #0h
	$$MainOp_Ambient_Light_Sensor_7$main segment code 2h #0h
	$$MainOp_Ambient_Light_Sensor_8$main segment code 2h #0h
	$$MainOp_Ambient_Light_Sensor_9$main segment code 2h #0h
	$$MainOp_Color_Sensor_4$main segment code 2h #0h
	$$MainOp_Hall_Effect_Sensors_1$main segment code 2h #0h
	$$MainOp_Hall_Effect_Sensors_2$main segment code 2h #0h
	$$MainOp_KMX61$main segment code 2h #0h
	$$MainOp_KX022$main segment code 2h #0h
	$$MainOp_KXG03_Sensor_12$main segment code 2h #0h
	$$MainOp_Pressure_Sensor_3$main segment code 2h #0h
	$$MainOp_Temperature_Sensor_20$main segment code 2h #0h
	$$MainOp_Temperature_Sensor_21$main segment code 2h #0h
	$$MainOp_Temperature_Sensor_22$main segment code 2h #0h
	$$MainOp_Temperature_Sensor_23$main segment code 2h #0h
	$$MainOp_UV_Sensor_10$main segment code 2h #0h
	$$NOPms$main segment code 2h #0h
	$$PortA_Low$main segment code 2h #0h
	$$PortB_Low$main segment code 2h #0h
	$$PortC_Low$main segment code 2h #0h
	$$PortD_Low$main segment code 2h #0h
	$$ReverseBits$main segment code 2h #0h
	$$SensorInitialization$main segment code 2h #0h
	$$SetOSC$main segment code 2h #0h
	$$TAB$$S134$main segment table 2h #0h
	$$TAB$$S143$main segment table 2h #0h
	$$TAB$$S152$main segment table 2h #0h
	$$TAB$$S154$main segment table 2h #0h
	$$TAB$$S158$main segment table 2h #0h
	$$TAB$$S160$main segment table 2h #0h
	$$TAB$$S165$main segment table 2h #0h
	$$TAB$$S167$main segment table 2h #0h
	$$TAB$$S178$main segment table 2h #0h
	$$TAB$$S180$main segment table 2h #0h
	$$TAB$$S194$main segment table 2h #0h
	$$TAB$$S196$main segment table 2h #0h
	$$TAB$$S198$main segment table 2h #0h
	$$TAB$$S200$main segment table 2h #0h
	$$TAB$$S202$main segment table 2h #0h
	$$TAB$$S204$main segment table 2h #0h
	$$TAB$$S205$main segment table 2h #0h
	$$TAB$$S207$main segment table 2h #0h
	$$TAB$$S220$main segment table 2h #0h
	$$TAB$$S270$main segment table 2h #0h
	$$TAB$$S272$main segment table 2h #0h
	$$TAB$$S274$main segment table 2h #0h
	$$TAB$$S277$main segment table 2h #0h
	$$TAB$$S279$main segment table 2h #0h
	$$TAB$$S281$main segment table 2h #0h
	$$TAB$$S283$main segment table 2h #0h
	$$TAB$$S286$main segment table 2h #0h
	$$TAB$$S288$main segment table 2h #0h
	$$TAB$$S30$main segment table 2h #0h
	$$TAB$$S58$main segment table 2h #0h
	$$TAB$$S59$main segment table 2h #0h
	$$TABBH1710FVC_CONT_H_RES_MOD$main segment table 2h #0h
	$$TABBH1710FVC_CONT_L_RES_MOD$main segment table 2h #0h
	$$TABBH1710FVC_CONT_M_RES_MOD$main segment table 2h #0h
	$$TABBH1710FVC_ONET_H_RES_MOD$main segment table 2h #0h
	$$TABBH1710FVC_ONET_L_RES_MOD$main segment table 2h #0h
	$$TABBH1710FVC_ONET_M_RES_MOD$main segment table 2h #0h
	$$TABBH1710FVC_RESET$main segment table 2h #0h
	$$TABBH1721FVC_CONT_A_RES_MOD$main segment table 2h #0h
	$$TABBH1721FVC_CONT_H_RES_MOD$main segment table 2h #0h
	$$TABBH1721FVC_CONT_L_RES_MOD$main segment table 2h #0h
	$$TABBH1730FVC_CMD_RESET_INT_OUT$main segment table 2h #0h
	$$TABBH1730FVC_CMD_START_MIM$main segment table 2h #0h
	$$TABBH1730FVC_CMD_STOP_MIM$main segment table 2h #0h
	$$TABBH1730FVC_CMD_SW_RESET$main segment table 2h #0h
	$$TABBH1730FVC_REG_CONTROL$main segment table 2h #0h
	$$TABBH1730FVC_REG_DATA0HIGH$main segment table 2h #0h
	$$TABBH1730FVC_REG_DATA0LOW$main segment table 2h #0h
	$$TABBH1730FVC_REG_DATA1HIGH$main segment table 2h #0h
	$$TABBH1730FVC_REG_DATA1LOW$main segment table 2h #0h
	$$TABBH1730FVC_REG_GAIN$main segment table 2h #0h
	$$TABBH1730FVC_REG_ID$main segment table 2h #0h
	$$TABBH1730FVC_REG_INTERRUPT$main segment table 2h #0h
	$$TABBH1730FVC_REG_THHHIGH$main segment table 2h #0h
	$$TABBH1730FVC_REG_THHLOW$main segment table 2h #0h
	$$TABBH1730FVC_REG_THLHIGH$main segment table 2h #0h
	$$TABBH1730FVC_REG_THLLOW$main segment table 2h #0h
	$$TABBH1730FVC_REG_TIMING$main segment table 2h #0h
	$$TABBH1745_BLUE_DATA_LSBs$main segment table 2h #0h
	$$TABBH1745_BLUE_DATA_MSBs$main segment table 2h #0h
	$$TABBH1745_GREEN_DATA_LSBs$main segment table 2h #0h
	$$TABBH1745_GREEN_DATA_MSBs$main segment table 2h #0h
	$$TABBH1745_I2C_ADDR$main segment table 2h #0h
	$$TABBH1745_INTERRUPT$main segment table 2h #0h
	$$TABBH1745_MANUFACTURER_ID$main segment table 2h #0h
	$$TABBH1745_MODE_CONTROL1$main segment table 2h #0h
	$$TABBH1745_MODE_CONTROL2$main segment table 2h #0h
	$$TABBH1745_MODE_CONTROL3$main segment table 2h #0h
	$$TABBH1745_PERSISTENCE$main segment table 2h #0h
	$$TABBH1745_RED_DATA_LSBs$main segment table 2h #0h
	$$TABBH1745_RED_DATA_MSBs$main segment table 2h #0h
	$$TABBH1745_SYSTEM_CONTROL$main segment table 2h #0h
	$$TABBH1780GLI_REG_CONTROL$main segment table 2h #0h
	$$TABBH1780GLI_REG_DATAHIGH$main segment table 2h #0h
	$$TABBH1780GLI_REG_DATALOW$main segment table 2h #0h
	$$TABBH1780GLI_REG_MFG_ID$main segment table 2h #0h
	$$TABBH1780GLI_REG_PART_ID$main segment table 2h #0h
	$$TABBH17xxFVC_ADDR_1$main segment table 2h #0h
	$$TABBH17xxFVC_ADDR_2$main segment table 2h #0h
	$$TABBH17xxFVC_PWR_DOWN$main segment table 2h #0h
	$$TABBH17xxFVC_PWR_ON$main segment table 2h #0h
	$$TABBM1383GLV_I2C_ADDR$main segment table 2h #0h
	$$TABBM1383GLV_ID$main segment table 2h #0h
	$$TABBM1383GLV_MODE_CONTROL$main segment table 2h #0h
	$$TABBM1383GLV_MODE_CONTROL_AVGN$main segment table 2h #0h
	$$TABBM1383GLV_MODE_CONTROL_MODE$main segment table 2h #0h
	$$TABBM1383GLV_MODE_CONTROL_REG$main segment table 2h #0h
	$$TABBM1383GLV_POWER_DOWN$main segment table 2h #0h
	$$TABBM1383GLV_POWER_OFF$main segment table 2h #0h
	$$TABBM1383GLV_POWER_ON$main segment table 2h #0h
	$$TABBM1383GLV_PRESSURE_LSB$main segment table 2h #0h
	$$TABBM1383GLV_PRESSURE_MSB$main segment table 2h #0h
	$$TABBM1383GLV_RESET_CONTROL$main segment table 2h #0h
	$$TABBM1383GLV_SLEEP$main segment table 2h #0h
	$$TABBM1383GLV_SLEEP_ACT$main segment table 2h #0h
	$$TABBM1383GLV_SLEEP_SLP$main segment table 2h #0h
	$$TABBM1383GLV_TEMPERATURE_LSB$main segment table 2h #0h
	$$TABBM1383GLV_TEMPERATURE_MSB$main segment table 2h #0h
	$$TABKMX61_ACCEL_XOUT_H$main segment table 2h #0h
	$$TABKMX61_ACCEL_XOUT_L$main segment table 2h #0h
	$$TABKMX61_ACCEL_YOUT_H$main segment table 2h #0h
	$$TABKMX61_ACCEL_YOUT_L$main segment table 2h #0h
	$$TABKMX61_ACCEL_ZOUT_H$main segment table 2h #0h
	$$TABKMX61_ACCEL_ZOUT_L$main segment table 2h #0h
	$$TABKMX61_BTH$main segment table 2h #0h
	$$TABKMX61_BTSC$main segment table 2h #0h
	$$TABKMX61_BUF_CLEAR$main segment table 2h #0h
	$$TABKMX61_BUF_CTRL1$main segment table 2h #0h
	$$TABKMX61_BUF_CTRL1_CFGDAT$main segment table 2h #0h
	$$TABKMX61_BUF_CTRL2$main segment table 2h #0h
	$$TABKMX61_BUF_CTRL2_CFGDAT$main segment table 2h #0h
	$$TABKMX61_BUF_READ$main segment table 2h #0h
	$$TABKMX61_BUF_STATUS_H$main segment table 2h #0h
	$$TABKMX61_BUF_STATUS_L$main segment table 2h #0h
	$$TABKMX61_BUF_STATUS_REG$main segment table 2h #0h
	$$TABKMX61_BUF_THRESH_H$main segment table 2h #0h
	$$TABKMX61_BUF_THRESH_L$main segment table 2h #0h
	$$TABKMX61_CNTL1$main segment table 2h #0h
	$$TABKMX61_CNTL1_CFGDAT$main segment table 2h #0h
	$$TABKMX61_CNTL2$main segment table 2h #0h
	$$TABKMX61_CNTL2_CFGDAT$main segment table 2h #0h
	$$TABKMX61_COTR$main segment table 2h #0h
	$$TABKMX61_I2C_ADDR$main segment table 2h #0h
	$$TABKMX61_INC1$main segment table 2h #0h
	$$TABKMX61_INC2$main segment table 2h #0h
	$$TABKMX61_INC3$main segment table 2h #0h
	$$TABKMX61_INL$main segment table 2h #0h
	$$TABKMX61_INS1$main segment table 2h #0h
	$$TABKMX61_INS2$main segment table 2h #0h
	$$TABKMX61_MAG_XOUT_H$main segment table 2h #0h
	$$TABKMX61_MAG_XOUT_L$main segment table 2h #0h
	$$TABKMX61_MAG_YOUT_H$main segment table 2h #0h
	$$TABKMX61_MAG_YOUT_L$main segment table 2h #0h
	$$TABKMX61_MAG_ZOUT_H$main segment table 2h #0h
	$$TABKMX61_MAG_ZOUT_L$main segment table 2h #0h
	$$TABKMX61_ODCNTL$main segment table 2h #0h
	$$TABKMX61_ODCNTL_CFGDAT$main segment table 2h #0h
	$$TABKMX61_SELF_TEST$main segment table 2h #0h
	$$TABKMX61_SELF_TEST_CFGDAT$main segment table 2h #0h
	$$TABKMX61_SN_1$main segment table 2h #0h
	$$TABKMX61_SN_2$main segment table 2h #0h
	$$TABKMX61_SN_3$main segment table 2h #0h
	$$TABKMX61_SN_4$main segment table 2h #0h
	$$TABKMX61_STATUS_REG$main segment table 2h #0h
	$$TABKMX61_STBY_REG$main segment table 2h #0h
	$$TABKMX61_TEMP_EN_CNTL$main segment table 2h #0h
	$$TABKMX61_TEMP_EN_CNTL_CFGDAT$main segment table 2h #0h
	$$TABKMX61_TEMP_OUT_H$main segment table 2h #0h
	$$TABKMX61_TEMP_OUT_L$main segment table 2h #0h
	$$TABKMX61_WHO_AM_I$main segment table 2h #0h
	$$TABKMX61_WUFC$main segment table 2h #0h
	$$TABKMX61_WUFTH$main segment table 2h #0h
	$$TABKMX61_XOUT_HPF_H$main segment table 2h #0h
	$$TABKMX61_XOUT_HPF_L$main segment table 2h #0h
	$$TABKMX61_YOUT_HPF_H$main segment table 2h #0h
	$$TABKMX61_YOUT_HPF_L$main segment table 2h #0h
	$$TABKMX61_ZOUT_HPF_H$main segment table 2h #0h
	$$TABKMX61_ZOUT_HPF_L$main segment table 2h #0h
	$$TABKMX62_CNTL2$main segment table 2h #0h
	$$TABKMX62_CNTL2_CFG$main segment table 2h #0h
	$$TABKMX62_MAG_XOUT_L$main segment table 2h #0h
	$$TABKX022_ATH$main segment table 2h #0h
	$$TABKX022_BUF_CLEAR$main segment table 2h #0h
	$$TABKX022_BUF_CNTL1$main segment table 2h #0h
	$$TABKX022_BUF_CNTL2$main segment table 2h #0h
	$$TABKX022_BUF_READ$main segment table 2h #0h
	$$TABKX022_BUF_STATUS_1$main segment table 2h #0h
	$$TABKX022_BUF_STATUS_2$main segment table 2h #0h
	$$TABKX022_CNTL1$main segment table 2h #0h
	$$TABKX022_CNTL1_CFGDAT$main segment table 2h #0h
	$$TABKX022_CNTL2$main segment table 2h #0h
	$$TABKX022_CNTL3$main segment table 2h #0h
	$$TABKX022_CNTL3_CFGDAT$main segment table 2h #0h
	$$TABKX022_COTR$main segment table 2h #0h
	$$TABKX022_FTD$main segment table 2h #0h
	$$TABKX022_HYST_SET$main segment table 2h #0h
	$$TABKX022_I2C_ADDR$main segment table 2h #0h
	$$TABKX022_INC1$main segment table 2h #0h
	$$TABKX022_INC2$main segment table 2h #0h
	$$TABKX022_INC3$main segment table 2h #0h
	$$TABKX022_INC4$main segment table 2h #0h
	$$TABKX022_INC5$main segment table 2h #0h
	$$TABKX022_INC6$main segment table 2h #0h
	$$TABKX022_INS1$main segment table 2h #0h
	$$TABKX022_INS2$main segment table 2h #0h
	$$TABKX022_INS3$main segment table 2h #0h
	$$TABKX022_INT_REL$main segment table 2h #0h
	$$TABKX022_LP_CNTL$main segment table 2h #0h
	$$TABKX022_ODCNTL$main segment table 2h #0h
	$$TABKX022_ODCNTL_CFGDAT$main segment table 2h #0h
	$$TABKX022_SELF_TEST$main segment table 2h #0h
	$$TABKX022_STAT$main segment table 2h #0h
	$$TABKX022_STD$main segment table 2h #0h
	$$TABKX022_TDTC$main segment table 2h #0h
	$$TABKX022_TDTRC$main segment table 2h #0h
	$$TABKX022_TILT_ANGLE_HL$main segment table 2h #0h
	$$TABKX022_TILT_ANGLE_LL$main segment table 2h #0h
	$$TABKX022_TILT_TIMER$main segment table 2h #0h
	$$TABKX022_TILT_TIMER_CFGDAT$main segment table 2h #0h
	$$TABKX022_TLT$main segment table 2h #0h
	$$TABKX022_TSCP$main segment table 2h #0h
	$$TABKX022_TSPP$main segment table 2h #0h
	$$TABKX022_TTH$main segment table 2h #0h
	$$TABKX022_TTL$main segment table 2h #0h
	$$TABKX022_TWS$main segment table 2h #0h
	$$TABKX022_WHO_AM_I$main segment table 2h #0h
	$$TABKX022_WUFC$main segment table 2h #0h
	$$TABKX022_XHPH$main segment table 2h #0h
	$$TABKX022_XHPL$main segment table 2h #0h
	$$TABKX022_XOUTH$main segment table 2h #0h
	$$TABKX022_XOUTL$main segment table 2h #0h
	$$TABKX022_YHPH$main segment table 2h #0h
	$$TABKX022_YHPL$main segment table 2h #0h
	$$TABKX022_YOUTH$main segment table 2h #0h
	$$TABKX022_YOUTL$main segment table 2h #0h
	$$TABKX022_ZHPH$main segment table 2h #0h
	$$TABKX022_ZHPL$main segment table 2h #0h
	$$TABKX022_ZOUTH$main segment table 2h #0h
	$$TABKX022_ZOUTL$main segment table 2h #0h
	$$TABKXG03_ACC_XOUT_H$main segment table 2h #0h
	$$TABKXG03_ACC_XOUT_L$main segment table 2h #0h
	$$TABKXG03_ACC_YOUT_H$main segment table 2h #0h
	$$TABKXG03_ACC_YOUT_L$main segment table 2h #0h
	$$TABKXG03_ACC_ZOUT_H$main segment table 2h #0h
	$$TABKXG03_ACC_ZOUT_L$main segment table 2h #0h
	$$TABKXG03_CTRL_REG1$main segment table 2h #0h
	$$TABKXG03_CTRL_REG1_CFDAT$main segment table 2h #0h
	$$TABKXG03_CTRL_REG2$main segment table 2h #0h
	$$TABKXG03_CTRL_REG2_CFDAT$main segment table 2h #0h
	$$TABKXG03_GYRO_XOUT_H$main segment table 2h #0h
	$$TABKXG03_GYRO_XOUT_L$main segment table 2h #0h
	$$TABKXG03_GYRO_YOUT_H$main segment table 2h #0h
	$$TABKXG03_GYRO_YOUT_L$main segment table 2h #0h
	$$TABKXG03_GYRO_ZOUT_H$main segment table 2h #0h
	$$TABKXG03_GYRO_ZOUT_L$main segment table 2h #0h
	$$TABKXG03_I2C_ADDR$main segment table 2h #0h
	$$TABKXG03_ODCTRL$main segment table 2h #0h
	$$TABKXG03_ODCTRL_CFDAT$main segment table 2h #0h
	$$TABKXG03_STBY_REG$main segment table 2h #0h
	$$TABKXG03_STBY_SET$main segment table 2h #0h
	$$TABRPR0521_ALS0_LSB$main segment table 2h #0h
	$$TABRPR0521_ALS0_MSB$main segment table 2h #0h
	$$TABRPR0521_ALS1_LSB$main segment table 2h #0h
	$$TABRPR0521_ALS1_MSB$main segment table 2h #0h
	$$TABRPR0521_ALS_ModeCTR$main segment table 2h #0h
	$$TABRPR0521_ALS_ModeCTR_CFG$main segment table 2h #0h
	$$TABRPR0521_I2C_ADDR$main segment table 2h #0h
	$$TABRPR0521_Manufact_ID$main segment table 2h #0h
	$$TABRPR0521_PS_ModeCTR$main segment table 2h #0h
	$$TABRPR0521_PS_ModeCTR_CFG$main segment table 2h #0h
	$$TABRPR0521_Prox_ModeCTR$main segment table 2h #0h
	$$TABRPR0521_Prox_ModeCTR_CFG$main segment table 2h #0h
	$$TABRPR0521_Prox_PS_LSB$main segment table 2h #0h
	$$TABRPR0521_Prox_PS_MSB$main segment table 2h #0h
	$$TAB_uartSetParam$main segment table 2h #0h
	$$_funcI2CFin$main segment code 2h #0h
	$$_funcUartFin$main segment code 2h #0h
	$$_intADC$main segment code 2h #0h
	$$_intI2c$main segment code 2h #0h
	$$_intUart$main segment code 2h #0h
	$$main$main segment code 2h #0h
	$$main_clrWDT$main segment code 2h #0h
	$$main_reqNotHalt$main segment code 2h #0h
	$$write$main segment code 2h #0h
	$$NTABmain$main segment table 2h #0h
	$$NTABADC_Read$main segment table 2h #0h
	$$NTABSensorInitialization$main segment table 2h #0h
	STACKSEG 0100h
CVERSION 3.41.8
CGLOBAL 01H 03H 0000H "Init_Hall_Effect_Sensors_1" 08H 02H 0DBH 00H 80H 00H 00H 00H 07H
CGLOBAL 01H 03H 0000H "Init_Hall_Effect_Sensors_2" 08H 02H 0DCH 00H 80H 00H 00H 00H 07H
CGLOBAL 01H 03H 0000H "Init_KXG03_Sensor_12" 08H 02H 0E6H 00H 81H 08H 00H 00H 07H
CGLOBAL 01H 03H 0000H "MainOp_Hall_Effect_Sensors_1" 08H 02H 0C9H 00H 81H 0aH 00H 00H 07H
CGLOBAL 01H 03H 0000H "MainOp_Hall_Effect_Sensors_2" 08H 02H 0CAH 00H 81H 06H 00H 00H 07H
CGLOBAL 01H 03H 0000H "NOPms" 08H 02H 0C4H 00H 81H 0aH 00H 00H 07H
CGLOBAL 01H 03H 0000H "MainOp_Temperature_Sensor_20" 08H 02H 0D7H 00H 81H 14H 00H 00H 07H
CGLOBAL 01H 03H 0000H "MainOp_Temperature_Sensor_21" 08H 02H 0D8H 00H 81H 14H 00H 00H 07H
CGLOBAL 01H 03H 0000H "MainOp_Temperature_Sensor_22" 08H 02H 0D9H 00H 81H 0cH 00H 00H 07H
CGLOBAL 01H 03H 0000H "MainOp_Temperature_Sensor_23" 08H 02H 0DAH 00H 81H 14H 00H 00H 07H
CGLOBAL 01H 03H 0000H "main_clrWDT" 08H 02H 0B3H 00H 80H 00H 00H 00H 07H
CSGLOBAL 03H 0000H "_funcUartFin" 08H 02H 0BEH 00H 81H 02H 00H 00H 07H
CGLOBAL 01H 03H 0000H "main_reqNotHalt" 08H 02H 0C0H 00H 80H 00H 00H 00H 07H
CGLOBAL 01H 03H 0000H "MainOp_UV_Sensor_10" 08H 02H 0D2H 00H 81H 14H 00H 00H 07H
CGLOBAL 01H 03H 0000H "Init_Color_Sensor_4" 08H 02H 0DEH 00H 81H 08H 00H 00H 07H
CGLOBAL 01H 03H 0000H "DeviceSelection" 08H 02H 0C7H 00H 80H 00H 00H 00H 07H
CGLOBAL 01H 03H 0000H "Init_KX022" 08H 02H 0E7H 00H 81H 08H 00H 00H 07H
CSGLOBAL 03H 0000H "Initialization" 08H 02H 0B4H 00H 81H 04H 00H 00H 07H
CGLOBAL 01H 03H 0000H "MainOp_KMX61" 08H 02H 0D6H 00H 81H 22H 00H 00H 07H
CGLOBAL 01H 03H 0000H "Init_Pressure_Sensor_3" 08H 02H 0DDH 00H 81H 08H 00H 00H 07H
CGLOBAL 01H 03H 0000H "Init_Temperature_Sensor_20" 08H 02H 0E9H 00H 80H 00H 00H 00H 07H
CGLOBAL 01H 03H 0000H "Init_Temperature_Sensor_21" 08H 02H 0EAH 00H 80H 00H 00H 00H 07H
CGLOBAL 01H 03H 0000H "Init_Temperature_Sensor_22" 08H 02H 0EBH 00H 80H 00H 00H 00H 07H
CGLOBAL 01H 03H 0000H "main" 08H 02H 0EDH 00H 80H 06H 00H 00H 01H
CGLOBAL 01H 03H 0000H "Init_Temperature_Sensor_23" 08H 02H 0ECH 00H 80H 00H 00H 00H 07H
CGLOBAL 01H 03H 0000H "Init_UV_Sensor_10" 08H 02H 0E4H 00H 80H 00H 00H 00H 07H
CSGLOBAL 03H 0000H "_intUart" 08H 02H 0C1H 00H 80H 00H 00H 00H 07H
CGLOBAL 01H 03H 0000H "SensorInitialization" 08H 02H 0C8H 00H 81H 02H 00H 00H 07H
CGLOBAL 01H 03H 0000H "I2C_Write" 08H 02H 0BDH 00H 83H 10H 00H 00H 07H
CGLOBAL 01H 03H 0000H "MainOp_KXG03_Sensor_12" 08H 02H 0D4H 00H 81H 22H 00H 00H 07H
CGLOBAL 01H 03H 0000H "PortD_Low" 08H 02H 0B9H 00H 80H 00H 00H 00H 07H
CSGLOBAL 03H 0000H "_intI2c" 08H 02H 0C2H 00H 81H 02H 00H 00H 07H
CGLOBAL 01H 03H 0000H "write" 08H 02H 0BAH 00H 83H 08H 00H 00H 01H
CSGLOBAL 03H 0000H "SetOSC" 08H 02H 0B5H 00H 80H 00H 00H 00H 07H
CGLOBAL 01H 03H 0000H "PortC_Low" 08H 02H 0B8H 00H 80H 00H 00H 00H 07H
CSGLOBAL 03H 0000H "_intADC" 08H 02H 0C3H 00H 80H 00H 00H 00H 07H
CGLOBAL 01H 03H 0000H "Init_ALS_PROX_Sensor_11" 08H 02H 0E5H 00H 81H 08H 00H 00H 07H
CGLOBAL 01H 03H 0000H "PortB_Low" 08H 02H 0B7H 00H 80H 00H 00H 00H 07H
CGLOBAL 01H 03H 0000H "MainOp_ALS_PROX_Sensor_11" 08H 02H 0D3H 00H 81H 0eH 00H 00H 07H
CGLOBAL 01H 03H 0000H "I2C_Read" 08H 02H 0BCH 00H 83H 10H 00H 00H 07H
CGLOBAL 01H 03H 0000H "ADC_Read" 08H 02H 0BBH 00H 81H 04H 00H 00H 01H
CGLOBAL 01H 03H 0000H "MainOp_KX022" 08H 02H 0D5H 00H 81H 22H 00H 00H 07H
CGLOBAL 01H 03H 0000H "Init_Ambient_Light_Sensor_5" 08H 02H 0DFH 00H 80H 00H 00H 00H 07H
CGLOBAL 01H 03H 0000H "Init_Ambient_Light_Sensor_6" 08H 02H 0E0H 00H 81H 08H 00H 00H 07H
CGLOBAL 01H 03H 0000H "Init_Ambient_Light_Sensor_7" 08H 02H 0E1H 00H 83H 0cH 00H 00H 07H
CGLOBAL 01H 03H 0000H "Init_Ambient_Light_Sensor_8" 08H 02H 0E2H 00H 81H 08H 00H 00H 07H
CGLOBAL 01H 03H 0000H "Init_Ambient_Light_Sensor_9" 08H 02H 0E3H 00H 81H 08H 00H 00H 07H
CGLOBAL 01H 03H 0000H "PortA_Low" 08H 02H 0B6H 00H 80H 00H 00H 00H 07H
CGLOBAL 01H 03H 0000H "MainOp_Color_Sensor_4" 08H 02H 0CCH 00H 81H 12H 00H 00H 07H
CGLOBAL 01H 02H 0000H "ReverseBits" 08H 02H 0C5H 00H 80H 00H 00H 00H 00H
CSGLOBAL 03H 0000H "_funcI2CFin" 08H 02H 0BFH 00H 81H 02H 00H 00H 07H
CGLOBAL 01H 02H 0000H "FlashLEDs" 08H 02H 0C6H 00H 80H 00H 00H 00H 00H
CGLOBAL 01H 03H 0000H "Init_KMX61" 08H 02H 0E8H 00H 81H 08H 00H 00H 07H
CGLOBAL 01H 03H 0000H "MainOp_Pressure_Sensor_3" 08H 02H 0CBH 00H 83H 26H 00H 00H 07H
CGLOBAL 01H 03H 0000H "MainOp_Ambient_Light_Sensor_8" 08H 02H 0D0H 00H 81H 0aH 00H 00H 07H
CGLOBAL 01H 03H 0000H "MainOp_Ambient_Light_Sensor_9" 08H 02H 0D1H 00H 81H 08H 00H 00H 07H
CGLOBAL 01H 03H 0000H "MainOp_Ambient_Light_Sensor_5" 08H 02H 0CDH 00H 81H 0aH 00H 00H 07H
CGLOBAL 01H 03H 0000H "MainOp_Ambient_Light_Sensor_6" 08H 02H 0CEH 00H 81H 0aH 00H 00H 07H
CGLOBAL 01H 03H 0000H "MainOp_Ambient_Light_Sensor_7" 08H 02H 0CFH 00H 81H 0eH 00H 00H 07H
CSTRUCTTAG 0000H 0000H 0005H 000CH 00000016H "_Notag"
CSTRUCTMEM 42H 00000002H 00000000H "_Mode" 02H 00H 08H
CSTRUCTMEM 43H 00000002H 00000002H "_Handle" 02H 00H 08H
CSTRUCTMEM 42H 00000002H 00000004H "_Buf" 04H 03H 00H 00H 00H
CSTRUCTMEM 42H 00000002H 00000006H "_Bend" 04H 03H 00H 00H 00H
CSTRUCTMEM 42H 00000002H 00000008H "_Next" 04H 03H 00H 00H 00H
CSTRUCTMEM 42H 00000002H 0000000AH "_Rend" 04H 03H 00H 00H 00H
CSTRUCTMEM 42H 00000002H 0000000CH "_Rsave" 04H 03H 00H 00H 00H
CSTRUCTMEM 42H 00000002H 0000000EH "_Wend" 04H 03H 00H 00H 00H
CSTRUCTMEM 42H 00000002H 00000010H "_Back" 05H 01H 02H 00H 00H 00H
CSTRUCTMEM 42H 00000001H 00000012H "_Cbuf" 02H 00H 00H
CSTRUCTMEM 42H 00000001H 00000013H "_Nback" 02H 00H 00H
CSTRUCTMEM 43H 00000002H 00000014H "_Tmpnam" 04H 03H 00H 00H 00H
CSTRUCTTAG 0000H 0000H 0004H 0001H 00000004H "_Notag"
CSTRUCTMEM 42H 00000004H 00000000H "_Off" 02H 00H 02H
CSTRUCTTAG 0000H 0000H 0003H 0006H 0000000AH "_Notag"
CSTRUCTMEM 42H 00000004H 00000000H "br" 02H 00H 02H
CSTRUCTMEM 42H 00000001H 00000004H "lg" 02H 00H 00H
CSTRUCTMEM 42H 00000001H 00000005H "pt" 02H 00H 00H
CSTRUCTMEM 42H 00000001H 00000006H "stp" 02H 00H 00H
CSTRUCTMEM 42H 00000001H 00000007H "neg" 02H 00H 00H
CSTRUCTMEM 42H 00000001H 00000008H "dir" 02H 00H 00H
CSTRUCTTAG 0000H 0000H 0002H 0002H 00000008H "_Notag"
CSTRUCTMEM 43H 00000004H 00000000H "quot" 02H 00H 02H
CSTRUCTMEM 43H 00000004H 00000004H "rem" 02H 00H 02H
CSTRUCTTAG 0000H 0000H 0001H 0002H 00000004H "_Notag"
CSTRUCTMEM 43H 00000002H 00000000H "quot" 02H 00H 01H
CSTRUCTMEM 43H 00000002H 00000002H "rem" 02H 00H 01H
CSTRUCTTAG 0000H 0000H 0000H 0008H 00000001H "_Notag"
CSTRUCTMEM 52H 00000001H 00000000H "b0" 02H 00H 00H
CSTRUCTMEM 52H 00000001H 00000001H "b1" 02H 00H 00H
CSTRUCTMEM 52H 00000001H 00000002H "b2" 02H 00H 00H
CSTRUCTMEM 52H 00000001H 00000003H "b3" 02H 00H 00H
CSTRUCTMEM 52H 00000001H 00000004H "b4" 02H 00H 00H
CSTRUCTMEM 52H 00000001H 00000005H "b5" 02H 00H 00H
CSTRUCTMEM 52H 00000001H 00000006H "b6" 02H 00H 00H
CSTRUCTMEM 52H 00000001H 00000007H "b7" 02H 00H 00H
CUNIONTAG 0000H 0000H 0006H 0006H 00000006H "_Notag"
CUNIONMEM 42H 00000001H "_uchar" 02H 00H 00H
CUNIONMEM 42H 00000006H "_ucharArr" 05H 01H 06H 00H 00H 00H
CUNIONMEM 42H 00000002H "_uint" 02H 00H 01H
CUNIONMEM 42H 00000006H "_uintArr" 05H 01H 03H 00H 00H 01H
CUNIONMEM 43H 00000006H "_intArr" 05H 01H 03H 00H 00H 01H
CUNIONMEM 43H 00000004H "_float" 02H 00H 03H
CTYPEDEF 0000H 0000H 43H "_Ptrdifft" 02H 00H 01H
CTYPEDEF 0000H 0000H 42H "_Sizet" 02H 00H 01H
CTYPEDEF 0000H 0000H 43H "tUartSetParam" 04H 00H 05H 03H 00H
CTYPEDEF 0000H 0000H 42H "size_t" 02H 00H 01H
CTYPEDEF 0000H 0000H 43H "cbfUart" 0AH 03H 00H 02H 2EH 00H 00H 00H 00H 00H 07H
CTYPEDEF 0000H 0000H 43H "fpos_t" 04H 00H 05H 04H 00H
CTYPEDEF 0000H 0000H 43H "cbfI2c" 0AH 03H 00H 02H 43H 00H 00H 00H 00H 00H 07H
CTYPEDEF 0000H 0000H 03H "_Cmpfun_nf" 08H 02H 01H 00H 00H 00H 00H 00H 01H
CTYPEDEF 0000H 0000H 03H "_Cmpfun_nn" 08H 02H 00H 00H 00H 00H 00H 00H 01H
CTYPEDEF 0000H 0000H 03H "_Cmpfun_ff" 08H 02H 03H 00H 00H 00H 00H 00H 01H
CTYPEDEF 0000H 0000H 03H "_Cmpfun_fn" 08H 02H 02H 00H 00H 00H 00H 00H 01H
CTYPEDEF 0000H 0000H 43H "FILE" 04H 00H 05H 05H 00H
CTYPEDEF 0000H 0000H 43H "div_t" 04H 00H 05H 01H 00H
CTYPEDEF 0000H 0000H 43H "ldiv_t" 04H 00H 05H 02H 00H
CTYPEDEF 0000H 0000H 43H "_BYTE_FIELD" 04H 00H 05H 00H 00H
CGLOBAL 01H 00H 0001H "KX022_SELF_TEST" 02H 00H 00H
CGLOBAL 01H 00H 0001H "BH1745_RED_DATA_LSBs" 02H 00H 00H
CGLOBAL 01H 00H 0001H "BM1383GLV_ID" 02H 00H 00H
CGLOBAL 00H 42H 0001H "_flgUartFin" 02H 00H 00H
CGLOBAL 01H 00H 0001H "KMX61_WUFC" 02H 00H 00H
CGLOBAL 01H 00H 0001H "BH1780GLI_REG_PART_ID" 02H 00H 00H
CGLOBAL 01H 00H 0001H "KXG03_I2C_ADDR" 02H 00H 00H
CGLOBAL 01H 00H 0001H "BM1383GLV_SLEEP_SLP" 02H 00H 00H
CGLOBAL 01H 00H 0001H "BH1730FVC_CMD_RESET_INT_OUT" 02H 00H 00H
CGLOBAL 01H 00H 0001H "BH1745_RED_DATA_MSBs" 02H 00H 00H
CGLOBAL 01H 00H 0001H "KX022_INT_REL" 02H 00H 00H
CGLOBAL 01H 00H 0001H "BH1780GLI_REG_DATALOW" 02H 00H 00H
CGLOBAL 01H 00H 0001H "RPR0521_I2C_ADDR" 02H 00H 00H
CGLOBAL 01H 00H 0001H "BH1721FVC_CONT_A_RES_MOD" 02H 00H 00H
CGLOBAL 01H 00H 0001H "BM1383GLV_RESET_CONTROL" 02H 00H 00H
CGLOBAL 01H 00H 0001H "KXG03_GYRO_XOUT_L" 02H 00H 00H
CGLOBAL 01H 00H 0001H "KXG03_GYRO_ZOUT_L" 02H 00H 00H
CGLOBAL 01H 00H 0001H "BH1710FVC_CONT_H_RES_MOD" 02H 00H 00H
CGLOBAL 01H 00H 0001H "KXG03_GYRO_XOUT_H" 02H 00H 00H
CGLOBAL 01H 00H 0001H "KXG03_GYRO_ZOUT_H" 02H 00H 00H
CGLOBAL 01H 00H 0001H "BH1721FVC_CONT_H_RES_MOD" 02H 00H 00H
CGLOBAL 01H 00H 0001H "BH1745_INTERRUPT" 02H 00H 00H
CGLOBAL 01H 00H 0001H "BH1730FVC_REG_THHHIGH" 02H 00H 00H
CGLOBAL 01H 00H 0001H "BH1745_I2C_ADDR" 02H 00H 00H
CGLOBAL 01H 00H 0001H "KMX61_TEMP_EN_CNTL_CFGDAT" 02H 00H 00H
CGLOBAL 01H 00H 0001H "KMX61_CNTL1_CFGDAT" 02H 00H 00H
CGLOBAL 01H 00H 0001H "KMX61_CNTL2_CFGDAT" 02H 00H 00H
CGLOBAL 01H 00H 0001H "BM1383GLV_I2C_ADDR" 02H 00H 00H
CGLOBAL 01H 00H 0001H "BH1780GLI_REG_DATAHIGH" 02H 00H 00H
CGLOBAL 00H 43H 0006H "uniRawSensorOut" 04H 00H 06H 06H 00H
CGLOBAL 01H 00H 0001H "KMX61_BTSC" 02H 00H 00H
CGLOBAL 01H 00H 0001H "KMX61_ODCNTL" 02H 00H 00H
CGLOBAL 01H 00H 0001H "KMX61_COTR" 02H 00H 00H
CGLOBAL 01H 00H 0001H "RPR0521_PS_ModeCTR_CFG" 02H 00H 00H
CGLOBAL 01H 00H 0001H "KXG03_ODCTRL" 02H 00H 00H
CGLOBAL 01H 00H 0001H "RPR0521_Prox_ModeCTR_CFG" 02H 00H 00H
CGLOBAL 01H 00H 0001H "KX022_STAT" 02H 00H 00H
CGLOBAL 01H 00H 0001H "KMX61_STATUS_REG" 02H 00H 00H
CGLOBAL 01H 00H 0001H "BH1730FVC_REG_INTERRUPT" 02H 00H 00H
CGLOBAL 01H 00H 0001H "RPR0521_ALS0_LSB" 02H 00H 00H
CGLOBAL 01H 00H 0001H "KX022_XOUTL" 02H 00H 00H
CGLOBAL 01H 00H 0001H "KX022_XOUTH" 02H 00H 00H
CGLOBAL 01H 00H 0001H "RPR0521_ALS0_MSB" 02H 00H 00H
CGLOBAL 01H 00H 0001H "KX022_BUF_READ" 02H 00H 00H
CGLOBAL 01H 00H 0001H "KMX61_WUFTH" 02H 00H 00H
CGLOBAL 01H 00H 0001H "KMX61_STBY_REG" 02H 00H 00H
CGLOBAL 01H 00H 0001H "BH1710FVC_CONT_M_RES_MOD" 02H 00H 00H
CGLOBAL 01H 00H 0001H "KX022_YHPL" 02H 00H 00H
CGLOBAL 01H 00H 0001H "KMX62_CNTL2_CFG" 02H 00H 00H
CGLOBAL 01H 00H 0001H "KX022_YHPH" 02H 00H 00H
CGLOBAL 01H 00H 0001H "KX022_I2C_ADDR" 02H 00H 00H
CGLOBAL 01H 00H 0001H "KX022_CNTL1_CFGDAT" 02H 00H 00H
CGLOBAL 01H 00H 0001H "KMX61_INC1" 02H 00H 00H
CGLOBAL 01H 00H 0001H "KMX61_INC2" 02H 00H 00H
CGLOBAL 01H 00H 0001H "KMX61_INC3" 02H 00H 00H
CGLOBAL 01H 00H 0001H "KX022_XHPL" 02H 00H 00H
CGLOBAL 01H 00H 0001H "KX022_CNTL3_CFGDAT" 02H 00H 00H
CGLOBAL 01H 00H 0001H "KX022_XHPH" 02H 00H 00H
CGLOBAL 01H 00H 0001H "BH17xxFVC_PWR_DOWN" 02H 00H 00H
CGLOBAL 01H 00H 0001H "KMX61_ACCEL_YOUT_H" 02H 00H 00H
CGLOBAL 01H 00H 0001H "BH1710FVC_CONT_L_RES_MOD" 02H 00H 00H
CGLOBAL 01H 00H 0001H "KMX61_ACCEL_YOUT_L" 02H 00H 00H
CGLOBAL 01H 00H 0001H "BH1721FVC_CONT_L_RES_MOD" 02H 00H 00H
CGLOBAL 01H 00H 0001H "KMX61_INS1" 02H 00H 00H
CGLOBAL 01H 00H 0001H "KMX61_INS2" 02H 00H 00H
CGLOBAL 01H 00H 0001H "KX022_TDTC" 02H 00H 00H
CGLOBAL 01H 00H 0001H "BH1780GLI_REG_MFG_ID" 02H 00H 00H
CSGLOBAL 42H 0001H "LEDFlashFlag" 02H 00H 00H
CGLOBAL 01H 00H 0001H "RPR0521_ALS1_LSB" 02H 00H 00H
CGLOBAL 01H 00H 0001H "RPR0521_ALS1_MSB" 02H 00H 00H
CGLOBAL 01H 00H 0001H "KX022_ZHPL" 02H 00H 00H
CGLOBAL 01H 00H 0001H "KX022_ZHPH" 02H 00H 00H
CGLOBAL 01H 00H 0001H "KX022_TDTRC" 02H 00H 00H
CGLOBAL 01H 00H 0001H "KMX61_MAG_YOUT_H" 02H 00H 00H
CGLOBAL 01H 00H 0001H "KMX61_MAG_YOUT_L" 02H 00H 00H
CGLOBAL 01H 00H 0001H "KMX62_MAG_XOUT_L" 02H 00H 00H
CGLOBAL 01H 00H 0001H "KX022_TILT_ANGLE_HL" 02H 00H 00H
CGLOBAL 01H 00H 0001H "KX022_TILT_ANGLE_LL" 02H 00H 00H
CGLOBAL 01H 00H 0001H "KMX61_BUF_THRESH_H" 02H 00H 00H
CGLOBAL 01H 00H 0001H "KMX61_BUF_THRESH_L" 02H 00H 00H
CGLOBAL 01H 00H 0001H "BH1730FVC_CMD_STOP_MIM" 02H 00H 00H
CGLOBAL 01H 00H 0001H "KX022_ODCNTL" 02H 00H 00H
CGLOBAL 01H 00H 0001H "BM1383GLV_MODE_CONTROL" 02H 00H 00H
CGLOBAL 01H 00H 0001H "KMX61_BUF_CLEAR" 02H 00H 00H
CGLOBAL 01H 00H 0001H "BM1383GLV_SLEEP" 02H 00H 00H
CGLOBAL 01H 00H 0001H "KXG03_CTRL_REG1_CFDAT" 02H 00H 00H
CGLOBAL 01H 00H 0001H "KXG03_CTRL_REG2_CFDAT" 02H 00H 00H
CGLOBAL 01H 00H 0001H "BH1745_PERSISTENCE" 02H 00H 00H
CGLOBAL 01H 00H 0001H "BM1383GLV_MODE_CONTROL_MODE" 02H 00H 00H
CSGLOBAL 01H 000AH "_uartSetParam" 04H 00H 05H 03H 00H
CGLOBAL 01H 00H 0001H "KXG03_ACC_XOUT_H" 02H 00H 00H
CGLOBAL 01H 00H 0001H "KXG03_ACC_ZOUT_L" 02H 00H 00H
CGLOBAL 01H 00H 0001H "KXG03_ACC_XOUT_L" 02H 00H 00H
CGLOBAL 01H 00H 0001H "KXG03_ACC_ZOUT_H" 02H 00H 00H
CGLOBAL 01H 00H 0001H "KX022_BUF_STATUS_1" 02H 00H 00H
CGLOBAL 01H 00H 0001H "KX022_BUF_STATUS_2" 02H 00H 00H
CGLOBAL 01H 00H 0001H "KX022_WHO_AM_I" 02H 00H 00H
CGLOBAL 01H 00H 0001H "BM1383GLV_PRESSURE_MSB" 02H 00H 00H
CGLOBAL 01H 00H 0001H "BH1730FVC_REG_DATA1HIGH" 02H 00H 00H
CGLOBAL 01H 00H 0001H "KX022_ZOUTL" 02H 00H 00H
CGLOBAL 01H 00H 0001H "KX022_ZOUTH" 02H 00H 00H
CGLOBAL 01H 00H 0001H "BM1383GLV_PRESSURE_LSB" 02H 00H 00H
CGLOBAL 01H 00H 0001H "KX022_TSCP" 02H 00H 00H
CGLOBAL 01H 00H 0001H "KMX61_ODCNTL_CFGDAT" 02H 00H 00H
CSGLOBAL 42H 0001H "SensorPlatformSelection" 02H 00H 00H
CGLOBAL 01H 00H 0001H "BM1383GLV_TEMPERATURE_LSB" 02H 00H 00H
CGLOBAL 01H 00H 0001H "KX022_TSPP" 02H 00H 00H
CGLOBAL 01H 00H 0001H "BH1730FVC_REG_TIMING" 02H 00H 00H
CGLOBAL 01H 00H 0001H "BM1383GLV_TEMPERATURE_MSB" 02H 00H 00H
CGLOBAL 01H 00H 0001H "RPR0521_ALS_ModeCTR_CFG" 02H 00H 00H
CGLOBAL 01H 00H 0001H "KMX61_BTH" 02H 00H 00H
CGLOBAL 01H 00H 0001H "KX022_TILT_TIMER_CFGDAT" 02H 00H 00H
CGLOBAL 01H 00H 0001H "BH1730FVC_REG_ID" 02H 00H 00H
CGLOBAL 01H 00H 0001H "KMX61_TEMP_EN_CNTL" 02H 00H 00H
CGLOBAL 01H 00H 0001H "KMX61_CNTL1" 02H 00H 00H
CGLOBAL 01H 00H 0001H "KMX61_CNTL2" 02H 00H 00H
CGLOBAL 01H 00H 0001H "KMX62_CNTL2" 02H 00H 00H
CGLOBAL 01H 00H 0001H "KMX61_XOUT_HPF_L" 02H 00H 00H
CSGLOBAL 42H 0001H "LEDChangeFlag" 02H 00H 00H
CGLOBAL 01H 00H 0001H "KMX61_XOUT_HPF_H" 02H 00H 00H
CGLOBAL 01H 00H 0001H "KX022_BUF_CLEAR" 02H 00H 00H
CGLOBAL 01H 00H 0001H "BH1710FVC_RESET" 02H 00H 00H
CGLOBAL 01H 00H 0001H "BH1745_GREEN_DATA_LSBs" 02H 00H 00H
CGLOBAL 01H 00H 0001H "BM1383GLV_MODE_CONTROL_REG" 02H 00H 00H
CGLOBAL 01H 00H 0001H "BH1730FVC_REG_CONTROL" 02H 00H 00H
CGLOBAL 01H 00H 0001H "KMX61_INL" 02H 00H 00H
CGLOBAL 01H 00H 0001H "KX022_WUFC" 02H 00H 00H
CGLOBAL 01H 00H 0001H "BH1730FVC_REG_DATA0HIGH" 02H 00H 00H
CGLOBAL 01H 00H 0001H "KX022_YOUTL" 02H 00H 00H
CGLOBAL 01H 00H 0001H "KXG03_GYRO_YOUT_L" 02H 00H 00H
CGLOBAL 01H 00H 0001H "KX022_YOUTH" 02H 00H 00H
CGLOBAL 01H 00H 0001H "KXG03_GYRO_YOUT_H" 02H 00H 00H
CGLOBAL 01H 00H 0001H "BH17xxFVC_PWR_ON" 02H 00H 00H
CGLOBAL 01H 00H 0001H "BH1745_GREEN_DATA_MSBs" 02H 00H 00H
CGLOBAL 01H 00H 0001H "BH1710FVC_ONET_L_RES_MOD" 02H 00H 00H
CGLOBAL 01H 00H 0001H "KMX61_ZOUT_HPF_L" 02H 00H 00H
CGLOBAL 01H 00H 0001H "KX022_LP_CNTL" 02H 00H 00H
CGLOBAL 01H 00H 0001H "KX022_ODCNTL_CFGDAT" 02H 00H 00H
CGLOBAL 01H 00H 0001H "BH1730FVC_REG_THLHIGH" 02H 00H 00H
CGLOBAL 01H 00H 0001H "KMX61_ZOUT_HPF_H" 02H 00H 00H
CGLOBAL 01H 00H 0001H "KMX61_YOUT_HPF_L" 02H 00H 00H
CGLOBAL 01H 00H 0001H "BH1730FVC_CMD_START_MIM" 02H 00H 00H
CGLOBAL 01H 00H 0001H "KMX61_YOUT_HPF_H" 02H 00H 00H
CGLOBAL 01H 00H 0001H "RPR0521_Prox_ModeCTR" 02H 00H 00H
CGLOBAL 01H 00H 0001H "KX022_ATH" 02H 00H 00H
CGLOBAL 01H 00H 0001H "KMX61_SN_1" 02H 00H 00H
CGLOBAL 01H 00H 0001H "KMX61_SN_2" 02H 00H 00H
CGLOBAL 01H 00H 0001H "KMX61_SN_3" 02H 00H 00H
CGLOBAL 01H 00H 0001H "BH1745_MODE_CONTROL1" 02H 00H 00H
CGLOBAL 01H 00H 0001H "BH1745_MODE_CONTROL2" 02H 00H 00H
CGLOBAL 01H 00H 0001H "BH1745_MODE_CONTROL3" 02H 00H 00H
CGLOBAL 01H 00H 0001H "KMX61_SN_4" 02H 00H 00H
CGLOBAL 01H 00H 0001H "BH1780GLI_REG_CONTROL" 02H 00H 00H
CGLOBAL 01H 00H 0001H "BM1383GLV_POWER_ON" 02H 00H 00H
CGLOBAL 00H 42H 0001H "_flgI2CFin" 02H 00H 00H
CGLOBAL 01H 00H 0001H "KX022_COTR" 02H 00H 00H
CGLOBAL 01H 00H 0001H "RPR0521_PS_ModeCTR" 02H 00H 00H
CGLOBAL 01H 00H 0001H "KMX61_SELF_TEST_CFGDAT" 02H 00H 00H
CGLOBAL 01H 00H 0001H "BH1745_SYSTEM_CONTROL" 02H 00H 00H
CGLOBAL 01H 00H 0001H "BM1383GLV_POWER_DOWN" 02H 00H 00H
CGLOBAL 01H 00H 0001H "KX022_FTD" 02H 00H 00H
CGLOBAL 01H 00H 0001H "KX022_BUF_CNTL1" 02H 00H 00H
CGLOBAL 01H 00H 0001H "KX022_BUF_CNTL2" 02H 00H 00H
CGLOBAL 01H 00H 0001H "KMX61_I2C_ADDR" 02H 00H 00H
CGLOBAL 01H 00H 0001H "RPR0521_ALS_ModeCTR" 02H 00H 00H
CGLOBAL 01H 00H 0001H "KMX61_BUF_READ" 02H 00H 00H
CGLOBAL 01H 00H 0001H "BH17xxFVC_ADDR_1" 02H 00H 00H
CGLOBAL 01H 00H 0001H "BH17xxFVC_ADDR_2" 02H 00H 00H
CGLOBAL 01H 00H 0001H "BH1730FVC_REG_THHLOW" 02H 00H 00H
CGLOBAL 01H 00H 0001H "BH1710FVC_ONET_M_RES_MOD" 02H 00H 00H
CGLOBAL 01H 00H 0001H "KX022_CNTL1" 02H 00H 00H
CGLOBAL 01H 00H 0001H "KX022_CNTL2" 02H 00H 00H
CGLOBAL 01H 00H 0001H "KX022_CNTL3" 02H 00H 00H
CGLOBAL 01H 00H 0001H "KMX61_TEMP_OUT_H" 02H 00H 00H
CGLOBAL 01H 00H 0001H "KMX61_TEMP_OUT_L" 02H 00H 00H
CGLOBAL 00H 42H 0001H "_reqNotHalt" 02H 00H 00H
CGLOBAL 01H 00H 0001H "BM1383GLV_POWER_OFF" 02H 00H 00H
CGLOBAL 01H 00H 0001H "KX022_STD" 02H 00H 00H
CGLOBAL 01H 00H 0001H "KXG03_STBY_REG" 02H 00H 00H
CGLOBAL 01H 00H 0001H "KMX61_ACCEL_XOUT_H" 02H 00H 00H
CGLOBAL 01H 00H 0001H "KMX61_ACCEL_ZOUT_H" 02H 00H 00H
CGLOBAL 01H 00H 0001H "BH1745_BLUE_DATA_MSBs" 02H 00H 00H
CGLOBAL 01H 00H 0001H "KMX61_ACCEL_XOUT_L" 02H 00H 00H
CGLOBAL 01H 00H 0001H "KMX61_ACCEL_ZOUT_L" 02H 00H 00H
CGLOBAL 00H 43H 000CH "flSensorOut" 05H 01H 03H 00H 00H 03H
CGLOBAL 01H 00H 0001H "BH1710FVC_ONET_H_RES_MOD" 02H 00H 00H
CGLOBAL 01H 00H 0001H "KMX61_BUF_CTRL2_CFGDAT" 02H 00H 00H
CGLOBAL 01H 00H 0001H "KX022_INC1" 02H 00H 00H
CGLOBAL 01H 00H 0001H "KX022_INC2" 02H 00H 00H
CGLOBAL 01H 00H 0001H "KX022_INC3" 02H 00H 00H
CGLOBAL 01H 00H 0001H "KMX61_BUF_CTRL1_CFGDAT" 02H 00H 00H
CGLOBAL 01H 00H 0001H "KX022_INC4" 02H 00H 00H
CGLOBAL 01H 00H 0001H "KX022_INC5" 02H 00H 00H
CGLOBAL 01H 00H 0001H "BH1730FVC_REG_GAIN" 02H 00H 00H
CGLOBAL 01H 00H 0001H "KX022_INC6" 02H 00H 00H
CGLOBAL 01H 00H 0001H "KXG03_CTRL_REG1" 02H 00H 00H
CGLOBAL 01H 00H 0001H "KXG03_CTRL_REG2" 02H 00H 00H
CGLOBAL 01H 00H 0001H "KX022_TLT" 02H 00H 00H
CGLOBAL 01H 00H 0001H "KMX61_BUF_CTRL1" 02H 00H 00H
CGLOBAL 01H 00H 0001H "KMX61_BUF_CTRL2" 02H 00H 00H
CGLOBAL 01H 00H 0001H "BH1745_BLUE_DATA_LSBs" 02H 00H 00H
CGLOBAL 01H 00H 0001H "BH1730FVC_CMD_SW_RESET" 02H 00H 00H
CGLOBAL 01H 00H 0001H "KXG03_STBY_SET" 02H 00H 00H
CGLOBAL 01H 00H 0001H "KX022_TTH" 02H 00H 00H
CGLOBAL 01H 00H 0001H "KXG03_ODCTRL_CFDAT" 02H 00H 00H
CGLOBAL 01H 00H 0001H "KX022_TTL" 02H 00H 00H
CGLOBAL 01H 00H 0001H "KX022_INS1" 02H 00H 00H
CGLOBAL 01H 00H 0001H "KX022_INS2" 02H 00H 00H
CGLOBAL 01H 00H 0001H "KX022_INS3" 02H 00H 00H
CGLOBAL 01H 00H 0001H "KX022_TWS" 02H 00H 00H
CGLOBAL 01H 00H 0001H "KMX61_BUF_STATUS_L" 02H 00H 00H
CGLOBAL 01H 00H 0001H "RPR0521_Manufact_ID" 02H 00H 00H
CGLOBAL 01H 00H 0001H "BH1730FVC_REG_DATA0LOW" 02H 00H 00H
CGLOBAL 01H 00H 0001H "KMX61_BUF_STATUS_H" 02H 00H 00H
CGLOBAL 01H 00H 0001H "KMX61_MAG_XOUT_H" 02H 00H 00H
CGLOBAL 01H 00H 0001H "KMX61_MAG_ZOUT_H" 02H 00H 00H
CGLOBAL 01H 00H 0001H "KMX61_MAG_XOUT_L" 02H 00H 00H
CGLOBAL 01H 00H 0001H "KMX61_MAG_ZOUT_L" 02H 00H 00H
CGLOBAL 01H 00H 0001H "KMX61_SELF_TEST" 02H 00H 00H
CSGLOBAL 42H 0001H "SensorIntializationFlag" 02H 00H 00H
CGLOBAL 01H 00H 0001H "BH1730FVC_REG_THLLOW" 02H 00H 00H
CGLOBAL 01H 00H 0001H "KX022_HYST_SET" 02H 00H 00H
CGLOBAL 01H 00H 0001H "BM1383GLV_SLEEP_ACT" 02H 00H 00H
CGLOBAL 01H 00H 0001H "KMX61_WHO_AM_I" 02H 00H 00H
CGLOBAL 01H 00H 0001H "KXG03_ACC_YOUT_L" 02H 00H 00H
CGLOBAL 00H 42H 0001H "_flgADCFin" 02H 00H 00H
CGLOBAL 01H 00H 0001H "KXG03_ACC_YOUT_H" 02H 00H 00H
CGLOBAL 01H 00H 0001H "RPR0521_Prox_PS_LSB" 02H 00H 00H
CGLOBAL 01H 00H 0001H "RPR0521_Prox_PS_MSB" 02H 00H 00H
CGLOBAL 01H 00H 0001H "KX022_TILT_TIMER" 02H 00H 00H
CGLOBAL 01H 00H 0001H "BH1730FVC_REG_DATA1LOW" 02H 00H 00H
CGLOBAL 01H 00H 0001H "BM1383GLV_MODE_CONTROL_AVGN" 02H 00H 00H
CGLOBAL 01H 00H 0001H "KMX61_BUF_STATUS_REG" 02H 00H 00H
CGLOBAL 01H 00H 0001H "BH1745_MANUFACTURER_ID" 02H 00H 00H
CFILE 0001H 0000085AH "main\\ML610112.H"
CFILE 0002H 000000D8H "main\\stdlib.h"
CFILE 0003H 0000007AH "main\\yvals.h"
CFILE 0004H 0000006BH "uart\\uart.h"
CFILE 0005H 00000027H "common\\common.h"
CFILE 0006H 00000057H "irq\\irq.h"
CFILE 0007H 00000023H "main\\mcu.h"
CFILE 0008H 00000045H "i2c\\i2c.h"
CFILE 0009H 00000046H "tbc\\tbc.h"
CFILE 000AH 000001B8H "timer\\timer.h"
CFILE 000BH 000000EEH "main\\stdio.h"
CFILE 0000H 0000094FH "main\\main.c"

	rseg $$main$main
CFUNCTION 237

_main	:
CBLOCK 237 1 547

;;{ 	
CLINEA 0000H 0001H 0223H 0001H 0003H
CBLOCK 237 2 547

;;	Initialization(); //Ports, UART, Timers, Oscillator, Comparators, etc.
CLINEA 0000H 0001H 0224H 0002H 0047H
	bl	_Initialization

;;	PRINTF(WelcomeString);
CLINEA 0000H 0001H 0226H 0002H 0017H
	mov	r0,	#01h
	mov	r1,	#01h
	push	er0
	mov	r2,	#BYTE1 OFFSET $$S30
	mov	r3,	#BYTE2 OFFSET $$S30
	mov	er0,	#0 
	bl	_write
	add	sp,	#2 

;;MainLoop:
CLINEA 0000H 0001H 022DH 0001H 0009H
CLABEL 001FH "MainLoop"
_$L31 :

;;	main_clrWDT();
CLINEA 0000H 0001H 022EH 0002H 000FH
	bl	_main_clrWDT

;;	DeviceSelection(); 	// SensorPlatformSelection holds 8-bits of sensor type
CLINEA 0000H 0001H 0231H 0002H 004BH
	bl	_DeviceSelection

;;	if(SensorIntializationFlag==1){	//Holds the SW Statement for Initializing Sensors
CLINEA 0000H 0001H 0234H 0002H 0052H
	l	r0,	NEAR _SensorIntializationFlag
	cmp	r0,	#01h
	bne	_$L32
CBLOCK 237 3 564

;;		SensorInitialization();
CLINEA 0000H 0001H 0235H 0003H 0019H
	bl	_SensorInitialization

;;		SensorIntializationFlag = 0;
CLINEA 0000H 0001H 0236H 0003H 001EH
	mov	r0,	#00h
	st	r0,	NEAR _SensorIntializationFlag
CBLOCKEND 237 3 567

;;	}
CLINEA 0000H 0000H 0237H 0002H 0002H
_$L32 :

;;	switch(SensorPlatformSelection){
CLINEA 0000H 0001H 0239H 0002H 0021H
	l	r0,	NEAR _SensorPlatformSelection
	mov	r1,	#00h
CBLOCK 237 4 569
	cmp	r0,	#038h
	cmpc	r1,	#00h
	ble	_$M2
	b	_$L38
_$M2 :
	cmp	r0,	#01h
	cmpc	r1,	#00h
	bge	_$M3
	b	_$L38
_$M3 :
	add	er0,	#-1
	sllc	r1,	#01h
	sll	r0,	#01h
	l	er0,	NEAR _$M1[er0]
	b	er0

;;	}
_$L37 :

;;	HLT = 1;	//Wait time here depends on the WDT timing
CLINEA 0000H 0001H 028AH 0002H 0034H
	sb	0f009h.0

;;	__asm("nop\n"); 
CLINEA 0000H 0001H 028BH 0002H 0011H
nop


;;	__asm("nop\n");
CLINEA 0000H 0001H 028CH 0002H 0010H
nop


;;	goto MainLoop;
CLINEA 0000H 0001H 028EH 0002H 000FH
	bal	_$L31
CBLOCKEND 237 2 655

;;		case 1:
CLINEA 0000H 0001H 023AH 0003H 0009H
_$S39 :

;;			MainOp_Hall_Effect_Sensors_1(); // Refer to function description for list of sensors
CLINEA 0000H 0001H 023BH 0004H 0057H
	bl	_MainOp_Hall_Effect_Sensors_1

;;			break;
CLINEA 0000H 0001H 023CH 0004H 0009H
	bal	_$L37

;;		case 2:
CLINEA 0000H 0001H 023DH 0003H 0009H
_$S40 :

;;			MainOp_Hall_Effect_Sensors_2(); // Refer to function description for list of sensors 
CLINEA 0000H 0001H 023EH 0004H 0058H
	bl	_MainOp_Hall_Effect_Sensors_2

;;			break;
CLINEA 0000H 0001H 023FH 0004H 0009H
	bal	_$L37

;;		case 48:
CLINEA 0000H 0001H 0241H 0003H 000AH
_$S41 :

;;			MainOp_Temperature_Sensor_22();
CLINEA 0000H 0001H 0243H 0004H 0022H
	bl	_MainOp_Temperature_Sensor_22

;;			MainOp_UV_Sensor_10();
CLINEA 0000H 0001H 0244H 0004H 0019H
	bl	_MainOp_UV_Sensor_10

;;			MainOp_Hall_Effect_Sensors_2();
CLINEA 0000H 0001H 0245H 0004H 0022H
	bl	_MainOp_Hall_Effect_Sensors_2

;;			MainOp_KMX61();
CLINEA 0000H 0001H 0246H 0004H 0012H
	bl	_MainOp_KMX61

;;			MainOp_Pressure_Sensor_3();
CLINEA 0000H 0001H 0248H 0004H 001EH
	bl	_MainOp_Pressure_Sensor_3

;;			MainOp_ALS_PROX_Sensor_11();
CLINEA 0000H 0001H 0249H 0004H 001FH
	bl	_MainOp_ALS_PROX_Sensor_11

;;			MainOp_Color_Sensor_4();
CLINEA 0000H 0001H 024AH 0004H 001BH
	bl	_MainOp_Color_Sensor_4

;;			MainOp_KX022();
CLINEA 0000H 0001H 024CH 0004H 0012H
	bl	_MainOp_KX022

;;			break;
CLINEA 0000H 0001H 0251H 0004H 0009H
	bal	_$L37

;;		case 49:
CLINEA 0000H 0001H 0252H 0003H 000AH
_$S42 :

;;			MainOp_Pressure_Sensor_3();
CLINEA 0000H 0001H 0253H 0004H 001EH
	bl	_MainOp_Pressure_Sensor_3

;;			break;
CLINEA 0000H 0001H 0254H 0004H 0009H
	bal	_$L37

;;		case 50:
CLINEA 0000H 0001H 0255H 0003H 000AH
_$S43 :

;;			MainOp_Color_Sensor_4();
CLINEA 0000H 0001H 0256H 0004H 001BH
	bl	_MainOp_Color_Sensor_4

;;			break;
CLINEA 0000H 0001H 0257H 0004H 0009H
	bal	_$L37

;;		case 56:
CLINEA 0000H 0001H 0258H 0003H 000AH
_$S44 :

;;			MainOp_ALS_PROX_Sensor_11();
CLINEA 0000H 0001H 0259H 0004H 001FH
	bl	_MainOp_ALS_PROX_Sensor_11

;;			break;
CLINEA 0000H 0001H 025AH 0004H 0009H
	bal	_$L37

;;		case 52:
CLINEA 0000H 0001H 025BH 0003H 000AH
_$S45 :

;;			MainOp_KXG03_Sensor_12();
CLINEA 0000H 0001H 025CH 0004H 001CH
	bl	_MainOp_KXG03_Sensor_12

;;			break;
CLINEA 0000H 0001H 025DH 0004H 0009H
	bal	_$L37

;;		case 5: 
CLINEA 0000H 0001H 025FH 0003H 000AH
_$S46 :

;;			MainOp_Ambient_Light_Sensor_5(); // Refer to function description for list of sensors
CLINEA 0000H 0001H 0260H 0004H 0058H
	bl	_MainOp_Ambient_Light_Sensor_5

;;			break;
CLINEA 0000H 0001H 0261H 0004H 0009H
	bal	_$L37

;;		case 6:
CLINEA 0000H 0001H 0262H 0003H 0009H
_$S47 :

;;			MainOp_Ambient_Light_Sensor_6(); // Refer to function description for list of sensors 
CLINEA 0000H 0001H 0263H 0004H 0059H
	bl	_MainOp_Ambient_Light_Sensor_6

;;			break;
CLINEA 0000H 0001H 0264H 0004H 0009H
	bal	_$L37

;;		case 7:
CLINEA 0000H 0001H 0265H 0003H 0009H
_$S48 :

;;			MainOp_Ambient_Light_Sensor_7(); // Refer to function description for list of sensors 
CLINEA 0000H 0001H 0266H 0004H 0059H
	bl	_MainOp_Ambient_Light_Sensor_7

;;			break;
CLINEA 0000H 0001H 0267H 0004H 0009H
	bal	_$L37

;;		case 8:
CLINEA 0000H 0001H 0268H 0003H 0009H
_$S49 :

;;			MainOp_Ambient_Light_Sensor_8(); // Refer to function description for list of sensors 
CLINEA 0000H 0001H 0269H 0004H 0059H
	bl	_MainOp_Ambient_Light_Sensor_8

;;			break;
CLINEA 0000H 0001H 026AH 0004H 0009H
	bal	_$L37

;;		case 9:
CLINEA 0000H 0001H 026BH 0003H 0009H
_$S50 :

;;			MainOp_Ambient_Light_Sensor_9(); // Refer to function description for list of sensors 
CLINEA 0000H 0001H 026CH 0004H 0059H
	bl	_MainOp_Ambient_Light_Sensor_9

;;			break;
CLINEA 0000H 0001H 026DH 0004H 0009H
	bal	_$L37

;;		case 10:
CLINEA 0000H 0001H 026EH 0003H 000AH
_$S51 :

;;			MainOp_UV_Sensor_10(); // Refer to function description for list of sensors 
CLINEA 0000H 0001H 026FH 0004H 004FH
	bl	_MainOp_UV_Sensor_10

;;			break;
CLINEA 0000H 0001H 0270H 0004H 0009H
	bal	_$L37

;;		case 15:
CLINEA 0000H 0001H 0271H 0003H 000AH
_$S52 :

;;			MainOp_KX022(); // Refer to function description for list of sensors 
CLINEA 0000H 0001H 0272H 0004H 0048H
	bl	_MainOp_KX022

;;			break;
CLINEA 0000H 0001H 0273H 0004H 0009H
	bal	_$L37

;;		case 16:
CLINEA 0000H 0001H 0274H 0003H 000AH
_$S53 :

;;			MainOp_KMX61(); // Refer to function description for list of sensors 
CLINEA 0000H 0001H 0275H 0004H 0048H
	bl	_MainOp_KMX61

;;			break;
CLINEA 0000H 0001H 0276H 0004H 0009H
	b	_$L37

;;		case 20:
CLINEA 0000H 0001H 0277H 0003H 000AH
_$S54 :

;;			MainOp_Temperature_Sensor_20(); // Refer to function description for list of sensors 
CLINEA 0000H 0001H 0278H 0004H 0058H
	bl	_MainOp_Temperature_Sensor_20

;;			break;
CLINEA 0000H 0001H 0279H 0004H 0009H
	b	_$L37

;;		case 21:
CLINEA 0000H 0001H 027AH 0003H 000AH
_$S55 :

;;			MainOp_Temperature_Sensor_21(); // Refer to function description for list of sensors
CLINEA 0000H 0001H 027BH 0004H 0057H
	bl	_MainOp_Temperature_Sensor_21

;;			break;
CLINEA 0000H 0001H 027CH 0004H 0009H
	b	_$L37

;;		case 22:
CLINEA 0000H 0001H 027DH 0003H 000AH
_$S56 :

;;			MainOp_Temperature_Sensor_22(); // Refer to function description for list of sensors 
CLINEA 0000H 0001H 027EH 0004H 0058H
	bl	_MainOp_Temperature_Sensor_22

;;			break;
CLINEA 0000H 0001H 027FH 0004H 0009H
	b	_$L37

;;		case 23:
CLINEA 0000H 0001H 0280H 0003H 000AH
_$S57 :

;;			MainOp_Temperature_Sensor_23(); // Refer to function description for list of sensors
CLINEA 0000H 0001H 0281H 0004H 0057H
	bl	_MainOp_Temperature_Sensor_23

;;			break; 
CLINEA 0000H 0001H 0282H 0004H 000AH
	b	_$L37

;;		default:
CLINEA 0000H 0001H 0283H 0003H 000AH
_$L38 :

;;			PRINTF(ESC_ERASE2END "No device connected." ESC_SOL);
CLINEA 0000H 0001H 0284H 0004H 0038H
	mov	er0,	#25
	push	er0
	mov	r2,	#BYTE1 OFFSET $$S58
	mov	r3,	#BYTE2 OFFSET $$S58
	mov	er0,	#0 
	bl	_write
	add	sp,	#2 

;;			printf(ESC_ERASE2END "device selected = %lu[lx]" ESC_SOL, (unsigned long)SensorPlatformSelection);
CLINEA 0000H 0001H 0285H 0004H 0065H
	l	r0,	NEAR _SensorPlatformSelection
	mov	r1,	#00h
	mov	er2,	#0 
	push	xr0
	mov	r0,	#BYTE1 OFFSET $$S59
	mov	r1,	#BYTE2 OFFSET $$S59
	push	er0
	bl	_printf_n
	add	sp,	#6 

;;			FlashLEDs();
CLINEA 0000H 0001H 0286H 0004H 000FH
	bl	_FlashLEDs

;;			break;
CLINEA 0000H 0001H 0287H 0004H 0009H
	b	_$L37
CBLOCKEND 237 4 648
CBLOCKEND 237 1 655
CFUNCTIONEND 237


	rseg $$Initialization$main
CFUNCTION 180

_Initialization	:
CBLOCK 180 1 667

;;static void Initialization(void){
CLINEA 0000H 0001H 029BH 0001H 0021H
	push	lr
CBLOCK 180 2 667
CRET 0000H

;;	DSIO0 = 1; // 0=> Enables Synchronous Serial Port 0 (initial value).
CLINEA 0000H 0001H 029FH 0002H 0045H
	sb	0f02ah.0

;;	DUA0  = 0; // 0=> Enables the operation of UART0 (initial value).
CLINEA 0000H 0001H 02A0H 0002H 0042H
	rb	0f02ah.2

;;	DUA1  = 1; // 0=> Enables Uart1 (initial value). 
CLINEA 0000H 0001H 02A1H 0002H 0032H
	sb	0f02ah.3

;;	DI2C1 = 1; // 0=> Enables I2C bus Interface (Slave) (initial value).
CLINEA 0000H 0001H 02A2H 0002H 0045H
	sb	0f02ah.6

;;	DI2C0 = 0; // 0=> Enables I2C bus Interface (Master) (initial value).	
CLINEA 0000H 0001H 02A3H 0002H 0047H
	rb	0f02ah.7

;;	BLKCON4 = 0x00; // 0=> Enables SA-ADC
CLINEA 0000H 0001H 02A5H 0002H 0026H
	mov	r0,	#00h
	st	r0,	0f02ch

;;	BLKCON6 = 0x00; // (1=disables; 0=enables) the operation of Timers 8, 9, A, E, F.
CLINEA 0000H 0001H 02A6H 0002H 0052H
	st	r0,	0f02eh

;;	BLKCON7 = 0x0F; // (1=disables; 0=enables) the operation of PWM (PWMC, PWMD, PWME, PWMF
CLINEA 0000H 0001H 02A7H 0002H 0058H
	mov	r0,	#0fh
	st	r0,	0f02fh

;;	PortA_Low();	//Initialize all 3 Ports of Port A to GPIO-Low
CLINEA 0000H 0001H 02AAH 0002H 003CH
	bl	_PortA_Low

;;	PortB_Low();	//Initialize all 8 Ports of Port B to GPIO-Low
CLINEA 0000H 0001H 02ABH 0002H 003CH
	bl	_PortB_Low

;;	PortC_Low();	//Initialize all 8 Ports of Port C to GPIO-Low
CLINEA 0000H 0001H 02ACH 0002H 003CH
	bl	_PortC_Low

;;	PortD_Low();	//Initialize all 6 Ports of Port D to input GPIO
CLINEA 0000H 0001H 02ADH 0002H 003EH
	bl	_PortD_Low

;;    SetOSC();
CLINEA 0000H 0001H 02B0H 0005H 000DH
	bl	_SetOSC

;;	PA0DIR = 1;
CLINEA 0000H 0001H 02B3H 0002H 000CH
	sb	0f251h.0

;;	PA1DIR = 1;		//GPIO Input
CLINEA 0000H 0001H 02B4H 0002H 001AH
	sb	0f251h.1

;;	SACH0 = 1;		//This enables the ADC Channel 0 from A0 Pin
CLINEA 0000H 0001H 02B5H 0002H 0039H
	sb	0f2f2h.0

;;	SACH1 = 1;		//This enables the ADC Channel 1 from A1 Pin
CLINEA 0000H 0001H 02B6H 0002H 0039H
	sb	0f2f2h.1

;;	SALP = 0;		//Single Read or Continuous Read... Single = 0, Consecutive = 1
CLINEA 0000H 0001H 02B7H 0002H 004BH
	rb	0f2f0h.0

;;	irq_di();	// Disable Interrupts
CLINEA 0000H 0001H 02BBH 0002H 0020H
	bl	_irq_di

;;	irq_init();	// Initialize Interrupts (All Off and NO Requests)
CLINEA 0000H 0001H 02BCH 0002H 003FH
	bl	_irq_init

;;	IE0 = IE1 = IE2 = IE3 = IE4 = IE5 = IE6 = IE7 = 0;
CLINEA 0000H 0001H 02BFH 0002H 0033H
	mov	r0,	#00h
	st	r0,	0f017h
	st	r0,	0f016h
	st	r0,	0f015h
	st	r0,	0f014h
	st	r0,	0f013h
	st	r0,	0f012h
	st	r0,	0f011h
	st	r0,	0f010h

;;	IRQ0 = IRQ1 = IRQ2 = IRQ3 = IRQ4 = IRQ5 = IRQ6 = IRQ7 = 0;
CLINEA 0000H 0001H 02C1H 0002H 003BH
	st	r0,	0f01fh
	st	r0,	0f01eh
	st	r0,	0f01dh
	st	r0,	0f01ch
	st	r0,	0f01bh
	st	r0,	0f01ah
	st	r0,	0f019h
	st	r0,	0f018h

;;	E2H = 0;	// E2H is the Enable flag for 2Hz TBC Interrupt (1=ENABLED)
CLINEA 0000H 0001H 02C3H 0002H 0045H
	rb	0f017h.3

;;	irq_setHdr((unsigned char)IRQ_NO_UA0INT, _intUart);
CLINEA 0000H 0001H 02C5H 0002H 0034H
	mov	r2,	#BYTE1 OFFSET __intUart
	mov	r3,	#BYTE2 OFFSET __intUart
	mov	r0,	#0fh
	bl	_irq_setHdr

;;	EUA0 = 1; 	// EUA0 is the enable flag for the UART0 interrupt (1=ENABLED)
CLINEA 0000H 0001H 02C6H 0002H 004AH
	sb	0f014h.0

;;	irq_setHdr((unsigned char)IRQ_NO_I2CMINT, _intI2c);
CLINEA 0000H 0001H 02C8H 0002H 0034H
	mov	r2,	#BYTE1 OFFSET __intI2c
	mov	r3,	#BYTE2 OFFSET __intI2c
	mov	r0,	#0ch
	bl	_irq_setHdr

;;	EI2CM = 1;
CLINEA 0000H 0001H 02C9H 0002H 000BH
	sb	0f012h.7

;;	QI2CM = 0;
CLINEA 0000H 0001H 02CAH 0002H 000BH
	rb	0f01ah.7

;;	irq_setHdr((unsigned char)IRQ_NO_SADINT, _intADC);
CLINEA 0000H 0001H 02CDH 0002H 0033H
	mov	r2,	#BYTE1 OFFSET __intADC
	mov	r3,	#BYTE2 OFFSET __intADC
	mov	r0,	#0ah
	bl	_irq_setHdr

;;	ESAD = 1;
CLINEA 0000H 0001H 02CEH 0002H 000AH
	sb	0f012h.2

;;	QSAD = 0;
CLINEA 0000H 0001H 02CFH 0002H 000AH
	rb	0f01ah.2

;;	irq_ei(); // Enable Interrupts
CLINEA 0000H 0001H 02DBH 0002H 001FH
	bl	_irq_ei

;;	WDTMOD = 0x01; 	
CLINEA 0000H 0001H 02E7H 0002H 0011H
	mov	r0,	#01h
	st	r0,	0f00fh

;;	main_clrWDT(); 	// Clear WDT
CLINEA 0000H 0001H 02E8H 0002H 001DH
	bl	_main_clrWDT

;;	i2c_init(I2C_MOD_FST, (unsigned short)HSCLK_KHZ, I2C_SYN_OFF);
CLINEA 0000H 0001H 02EEH 0002H 003FH
	mov	r0,	#00h
	push	r0
	mov	r2,	#040h
	mov	r3,	#01fh
	mov	r0,	#01h
	bl	_i2c_init
	add	sp,	#2 

;;			   &_uartSetParam );				/* Param... 	 */
CLINEA 0000H 0001H 02F3H 0007H 002BH
	mov	r0,	#BYTE1 OFFSET __uartSetParam
	mov	r1,	#BYTE2 OFFSET __uartSetParam
	push	er0
	mov	r2,	#040h
	mov	r3,	#01fh
	mov	r0,	#02h
	bl	_uart_init
	add	sp,	#2 

;;	uart_PortSet();
CLINEA 0000H 0001H 02F4H 0002H 0010H
	bl	_uart_PortSet
CBLOCKEND 180 2 760

;;}//End Initialization
CLINEA 0000H 0001H 02F8H 0001H 0015H
	pop	pc
CBLOCKEND 180 1 760
CFUNCTIONEND 180


	rseg $$write$main
CFUNCTION 186

_write	:
CBLOCK 186 1 774

;;{
CLINEA 0000H 0001H 0306H 0001H 0001H
	push	lr
	push	fp
	mov	fp,	sp
	push	er10
	mov	er10,	er2
CBLOCK 186 2 774
CRET 0004H
CARGUMENT 47H 0002H 0000H "handle" 02H 00H 01H
CARGUMENT 46H 0002H 0029H "buffer" 04H 03H 00H 00H 00H
CARGUMENT 42H 0002H 0004H "len" 02H 00H 01H

;;	_flgUartFin = 0; 
CLINEA 0000H 0001H 0307H 0002H 0012H
	mov	r0,	#00h
	st	r0,	NEAR __flgUartFin

;;	uart_stop();
CLINEA 0000H 0001H 0308H 0002H 000DH
	bl	_uart_stop

;;	uart_startSend(buffer, len, _funcUartFin); 
CLINEA 0000H 0001H 0309H 0002H 002CH
	mov	r0,	#BYTE1 OFFSET __funcUartFin
	mov	r1,	#BYTE2 OFFSET __funcUartFin
	push	er0
	l	er2,	4[fp]
	mov	er0,	er10
	bl	_uart_startSend
	add	sp,	#2 

;;	while(_flgUartFin != 1)
CLINEA 0000H 0000H 030AH 0001H 0001H
	bal	_$L66

;;	while(_flgUartFin != 1)
CLINEA 0000H 0000H 030AH 0002H 0018H
_$L64 :
CBLOCK 186 3 779

;;		main_clrWDT();
CLINEA 0000H 0001H 030CH 0003H 0010H
	bl	_main_clrWDT
CBLOCKEND 186 3 781

;;	while(_flgUartFin != 1)
CLINEA 0000H 0000H 030AH 0001H 0001H
_$L66 :
	l	r0,	NEAR __flgUartFin
	cmp	r0,	#01h
	bne	_$L64

;;	return len;
CLINEA 0000H 0001H 030EH 0002H 000CH
	l	er0,	4[fp]
CBLOCKEND 186 2 783

;;}
CLINEA 0000H 0000H 030FH 0001H 0001H
	pop	er10
	mov	sp,	fp
	pop	fp
	pop	pc
CBLOCKEND 186 1 783
CFUNCTIONEND 186


	rseg $$ADC_Read$main
CFUNCTION 187

_ADC_Read	:
CBLOCK 187 1 794

;;{
CLINEA 0000H 0001H 031AH 0001H 0001H
	push	lr
	push	er8
	mov	r8,	r0
CBLOCK 187 2 794
CRET 0002H
CARGUMENT 46H 0001H 001CH "idx" 02H 00H 00H

;;	_flgADCFin = 0;
CLINEA 0000H 0001H 031BH 0002H 0010H
	mov	r0,	#00h
	st	r0,	NEAR __flgADCFin

;;	SADMOD0 = (unsigned char)(1<<idx);
CLINEA 0000H 0001H 031CH 0002H 0023H
	mov	er0,	#1 
	mov	r2,	r8
_$M8 :
	cmp	r2,	#07h
	ble	_$M7
	sllc	r1,	#07h
	sll	r0,	#07h
	add	r2,	#0f9h
	bne	_$M8
_$M7 :
	sll	r0,	r2
	st	r0,	0f2f2h

;;	SARUN = 1;
CLINEA 0000H 0001H 031DH 0002H 000BH
	sb	0f2f1h.0

;;	while(_flgADCFin == 0)
CLINEA 0000H 0000H 031EH 0001H 0001H
	bal	_$L85

;;	while(_flgADCFin == 0)
CLINEA 0000H 0000H 031EH 0002H 0017H
_$L70 :
CBLOCK 187 3 799

;;		main_clrWDT();
CLINEA 0000H 0001H 0320H 0003H 0010H
	bl	_main_clrWDT
CBLOCKEND 187 3 801

;;	while(_flgADCFin == 0)
CLINEA 0000H 0000H 031EH 0001H 0001H
_$L85 :
	l	r0,	NEAR __flgADCFin
	beq	_$L70

;;	switch(idx)
CLINEA 0000H 0001H 0322H 0002H 000CH
	mov	r0,	r8
	mov	r1,	#00h
CBLOCK 187 4 803
	cmp	r8,	#07h
	cmpc	r1,	#00h
	ble	_$M10
	b	_$L76
_$M10 :
	sllc	r1,	#01h
	sll	r0,	#01h
	l	er0,	NEAR _$M9[er0]
	b	er0

;;	}
CBLOCKEND 187 2 814

;;}
CLINEA 0000H 0001H 032EH 0001H 0001H
_$L67 :
	pop	er8
	pop	pc

;;		case 0:		return (SADR0H<<2|SADR0L>>6);
CLINEA 0000H 0001H 0324H 0003H 0028H
_$S77 :
	l	r0,	0f2d1h
	mov	r1,	#00h
	sllc	r1,	#02h
	sll	r0,	#02h
	l	r2,	0f2d0h
	mov	r3,	#00h
	srlc	r2,	#06h
	sra	r3,	#06h
	or	r2,	r0
	or	r3,	r1
	mov	er0,	er2
	bal	_$L67

;;		case 1:		return (SADR1H<<2|SADR1L>>6);
CLINEA 0000H 0001H 0325H 0003H 0028H
_$S78 :
	l	r0,	0f2d3h
	mov	r1,	#00h
	sllc	r1,	#02h
	sll	r0,	#02h
	l	r2,	0f2d2h
	mov	r3,	#00h
	srlc	r2,	#06h
	sra	r3,	#06h
	or	r2,	r0
	or	r3,	r1
	mov	er0,	er2
	bal	_$L67

;;		case 2:		return (SADR2H<<2|SADR2L>>6);
CLINEA 0000H 0001H 0326H 0003H 0028H
_$S79 :
	l	r0,	0f2d5h
	mov	r1,	#00h
	sllc	r1,	#02h
	sll	r0,	#02h
	l	r2,	0f2d4h
	mov	r3,	#00h
	srlc	r2,	#06h
	sra	r3,	#06h
	or	r2,	r0
	or	r3,	r1
	mov	er0,	er2
	bal	_$L67

;;		case 3:		return (SADR3H<<2|SADR3L>>6);
CLINEA 0000H 0001H 0327H 0003H 0028H
_$S80 :
	l	r0,	0f2d7h
	mov	r1,	#00h
	sllc	r1,	#02h
	sll	r0,	#02h
	l	r2,	0f2d6h
	mov	r3,	#00h
	srlc	r2,	#06h
	sra	r3,	#06h
	or	r2,	r0
	or	r3,	r1
	mov	er0,	er2
	bal	_$L67

;;		case 4:		return (SADR4H<<2|SADR4L>>6);
CLINEA 0000H 0001H 0328H 0003H 0028H
_$S81 :
	l	r0,	0f2d9h
	mov	r1,	#00h
	sllc	r1,	#02h
	sll	r0,	#02h
	l	r2,	0f2d8h
	mov	r3,	#00h
	srlc	r2,	#06h
	sra	r3,	#06h
	or	r2,	r0
	or	r3,	r1
	mov	er0,	er2
	b	_$L67

;;		case 5:		return (SADR5H<<2|SADR5L>>6);
CLINEA 0000H 0001H 0329H 0003H 0028H
_$S82 :
	l	r0,	0f2dbh
	mov	r1,	#00h
	sllc	r1,	#02h
	sll	r0,	#02h
	l	r2,	0f2dah
	mov	r3,	#00h
	srlc	r2,	#06h
	sra	r3,	#06h
	or	r2,	r0
	or	r3,	r1
	mov	er0,	er2
	b	_$L67

;;		case 6:		return (SADR6H<<2|SADR6L>>6);
CLINEA 0000H 0001H 032AH 0003H 0028H
_$S83 :
	l	r0,	0f2ddh
	mov	r1,	#00h
	sllc	r1,	#02h
	sll	r0,	#02h
	l	r2,	0f2dch
	mov	r3,	#00h
	srlc	r2,	#06h
	sra	r3,	#06h
	or	r2,	r0
	or	r3,	r1
	mov	er0,	er2
	b	_$L67

;;		case 7:		return (SADR7H<<2|SADR7L>>6);
CLINEA 0000H 0001H 032BH 0003H 0028H
_$S84 :
	l	r0,	0f2dfh
	mov	r1,	#00h
	sllc	r1,	#02h
	sll	r0,	#02h
	l	r2,	0f2deh
	mov	r3,	#00h
	srlc	r2,	#06h
	sra	r3,	#06h
	or	r2,	r0
	or	r3,	r1
	mov	er0,	er2
	b	_$L67

;;		default:	return 0;
CLINEA 0000H 0001H 032CH 0003H 0014H
_$L76 :
	mov	er0,	#0 
	b	_$L67
CBLOCKEND 187 4 813
CBLOCKEND 187 1 814
CFUNCTIONEND 187


	rseg $$I2C_Read$main
CFUNCTION 188

_I2C_Read	:
CBLOCK 188 1 829

;;{
CLINEA 0000H 0001H 033DH 0001H 0001H
	push	lr
	push	fp
	mov	fp,	sp
	push	xr8
	mov	er10,	er2
	mov	r8,	r0
CBLOCK 188 2 829
CRET 0006H
CARGUMENT 46H 0001H 001CH "slave_address" 02H 00H 00H
CARGUMENT 46H 0002H 0029H "reg_address" 04H 03H 00H 00H 00H
CARGUMENT 42H 0001H 0004H "reg_address_size" 02H 00H 00H
CARGUMENT 42H 0002H 0006H "buffer" 04H 03H 00H 00H 00H
CARGUMENT 42H 0001H 0008H "size" 02H 00H 00H

;;	_flgI2CFin = 0;
CLINEA 0000H 0001H 033EH 0002H 0010H
	mov	r0,	#00h
	st	r0,	NEAR __flgI2CFin

;;	i2c_stop();	
CLINEA 0000H 0001H 033FH 0002H 000DH
	bl	_i2c_stop

;;	i2c_startReceive(slave_address, reg_address, reg_address_size, buffer, size, (cbfI2c)_funcI2CFin);
CLINEA 0000H 0001H 0340H 0002H 0063H
	mov	r0,	#BYTE1 OFFSET __funcI2CFin
	mov	r1,	#BYTE2 OFFSET __funcI2CFin
	push	er0
	l	r0,	8[fp]
	mov	r1,	#00h
	push	er0
	l	er0,	6[fp]
	push	er0
	l	r0,	4[fp]
	mov	r1,	#00h
	push	er0
	mov	er2,	er10
	mov	r0,	r8
	bl	_i2c_startReceive
	add	sp,	#8 

;;	while(_flgI2CFin != 1)
CLINEA 0000H 0000H 0341H 0001H 0001H
	bal	_$L91

;;	while(_flgI2CFin != 1)
CLINEA 0000H 0000H 0341H 0002H 0017H
_$L89 :
CBLOCK 188 3 834

;;		main_clrWDT();
CLINEA 0000H 0001H 0343H 0003H 0010H
	bl	_main_clrWDT
CBLOCKEND 188 3 836

;;	while(_flgI2CFin != 1)
CLINEA 0000H 0000H 0341H 0001H 0001H
_$L91 :
	l	r0,	NEAR __flgI2CFin
	cmp	r0,	#01h
	bne	_$L89
CBLOCKEND 188 2 837

;;}
CLINEA 0000H 0001H 0345H 0001H 0001H
	pop	xr8
	mov	sp,	fp
	pop	fp
	pop	pc
CBLOCKEND 188 1 837
CFUNCTIONEND 188


	rseg $$I2C_Write$main
CFUNCTION 189

_I2C_Write	:
CBLOCK 189 1 852

;;{
CLINEA 0000H 0001H 0354H 0001H 0001H
	push	lr
	push	fp
	mov	fp,	sp
	push	xr8
	mov	er10,	er2
	mov	r8,	r0
CBLOCK 189 2 852
CRET 0006H
CARGUMENT 46H 0001H 001CH "slave_address" 02H 00H 00H
CARGUMENT 46H 0002H 0029H "reg_address" 04H 03H 00H 00H 00H
CARGUMENT 42H 0001H 0004H "reg_address_size" 02H 00H 00H
CARGUMENT 42H 0002H 0006H "buffer" 04H 03H 00H 00H 00H
CARGUMENT 42H 0001H 0008H "size" 02H 00H 00H

;;	_flgI2CFin = 0;
CLINEA 0000H 0001H 0355H 0002H 0010H
	mov	r0,	#00h
	st	r0,	NEAR __flgI2CFin

;;	i2c_stop();	
CLINEA 0000H 0001H 0356H 0002H 000DH
	bl	_i2c_stop

;;	i2c_startSend(slave_address, reg_address, reg_address_size, buffer, size, (cbfI2c)_funcI2CFin);
CLINEA 0000H 0001H 0357H 0002H 0060H
	mov	r0,	#BYTE1 OFFSET __funcI2CFin
	mov	r1,	#BYTE2 OFFSET __funcI2CFin
	push	er0
	l	r0,	8[fp]
	mov	r1,	#00h
	push	er0
	l	er0,	6[fp]
	push	er0
	l	r0,	4[fp]
	mov	r1,	#00h
	push	er0
	mov	er2,	er10
	mov	r0,	r8
	bl	_i2c_startSend
	add	sp,	#8 

;;	while(_flgI2CFin != 1)
CLINEA 0000H 0000H 0358H 0001H 0001H
	bal	_$L97

;;	while(_flgI2CFin != 1)
CLINEA 0000H 0000H 0358H 0002H 0017H
_$L95 :
CBLOCK 189 3 857

;;		main_clrWDT();
CLINEA 0000H 0001H 035AH 0003H 0010H
	bl	_main_clrWDT
CBLOCKEND 189 3 859

;;	while(_flgI2CFin != 1)
CLINEA 0000H 0000H 0358H 0001H 0001H
_$L97 :
	l	r0,	NEAR __flgI2CFin
	cmp	r0,	#01h
	bne	_$L95
CBLOCKEND 189 2 860

;;}
CLINEA 0000H 0001H 035CH 0001H 0001H
	pop	xr8
	mov	sp,	fp
	pop	fp
	pop	pc
CBLOCKEND 189 1 860
CFUNCTIONEND 189


	rseg $$DeviceSelection$main
CFUNCTION 199

_DeviceSelection	:
CBLOCK 199 1 872

;;{  
CLINEA 0000H 0001H 0368H 0001H 0003H
CBLOCK 199 2 872

;;	if(PDD!=SensorPlatformSelection)
CLINEA 0000H 0001H 0375H 0002H 0021H
	l	r0,	0f268h
	l	r1,	NEAR _SensorPlatformSelection
	cmp	r0,	r1
	beq	_$L99
CBLOCK 199 3 886

;;		SensorIntializationFlag = 1;
CLINEA 0000H 0001H 0377H 0003H 001EH
	mov	r0,	#01h
	st	r0,	NEAR _SensorIntializationFlag

;;		SensorPlatformSelection = PDD;
CLINEA 0000H 0001H 0378H 0003H 0020H
	l	r0,	0f268h
	st	r0,	NEAR _SensorPlatformSelection
CBLOCKEND 199 3 889

;;	}
CLINEA 0000H 0000H 0379H 0002H 0002H
_$L99 :
CBLOCKEND 199 2 890

;;}
CLINEA 0000H 0001H 037AH 0001H 0001H
	rt
CBLOCKEND 199 1 890
CFUNCTIONEND 199


	rseg $$SensorInitialization$main
CFUNCTION 200

_SensorInitialization	:
CBLOCK 200 1 900

;;{  
CLINEA 0000H 0001H 0384H 0001H 0003H
	push	lr
CBLOCK 200 2 900
CRET 0000H

;;	switch(SensorPlatformSelection){
CLINEA 0000H 0001H 0385H 0002H 0021H
	l	r0,	NEAR _SensorPlatformSelection
	mov	r1,	#00h
CBLOCK 200 3 901
	cmp	r0,	#038h
	cmpc	r1,	#00h
	bgt	_$L105
	cmp	r0,	#01h
	cmpc	r1,	#00h
	blt	_$L105
	add	er0,	#-1
	sllc	r1,	#01h
	sll	r0,	#01h
	l	er0,	NEAR _$M15[er0]
	b	er0

;;	} 	 
_$L105 :
CBLOCKEND 200 2 969

;;}
CLINEA 0000H 0001H 03C9H 0001H 0001H
	pop	pc

;;		case 1:
CLINEA 0000H 0001H 0386H 0003H 0009H
_$S107 :

;;			Init_Hall_Effect_Sensors_1(); // Refer to function description for list of sensors
CLINEA 0000H 0001H 0387H 0004H 0055H
	bl	_Init_Hall_Effect_Sensors_1

;;			break;
CLINEA 0000H 0001H 0388H 0004H 0009H
	bal	_$L105

;;		case 2:
CLINEA 0000H 0001H 0389H 0003H 0009H
_$S108 :

;;			Init_Hall_Effect_Sensors_2(); // Refer to function description for list of sensors 
CLINEA 0000H 0001H 038AH 0004H 0056H
	bl	_Init_Hall_Effect_Sensors_2

;;			break;
CLINEA 0000H 0001H 038BH 0004H 0009H
	bal	_$L105

;;		case 48:			
CLINEA 0000H 0001H 038CH 0003H 000DH
_$S109 :

;;			Init_Temperature_Sensor_22();
CLINEA 0000H 0001H 038DH 0004H 0020H
	bl	_Init_Temperature_Sensor_22

;;			Init_UV_Sensor_10();
CLINEA 0000H 0001H 038EH 0004H 0017H
	bl	_Init_UV_Sensor_10

;;			Init_Hall_Effect_Sensors_2();
CLINEA 0000H 0001H 038FH 0004H 0020H
	bl	_Init_Hall_Effect_Sensors_2

;;			Init_KMX61();
CLINEA 0000H 0001H 0390H 0004H 0010H
	bl	_Init_KMX61

;;			Init_Pressure_Sensor_3();
CLINEA 0000H 0001H 0391H 0004H 001CH
	bl	_Init_Pressure_Sensor_3

;;			Init_ALS_PROX_Sensor_11();
CLINEA 0000H 0001H 0392H 0004H 001DH
	bl	_Init_ALS_PROX_Sensor_11

;;			Init_Color_Sensor_4();
CLINEA 0000H 0001H 0393H 0004H 0019H
	bl	_Init_Color_Sensor_4

;;			Init_KX022();			
CLINEA 0000H 0001H 0394H 0004H 0013H
	bl	_Init_KX022

;;			break;
CLINEA 0000H 0001H 0395H 0004H 0009H
	bal	_$L105

;;		case 49:
CLINEA 0000H 0001H 0396H 0003H 000AH
_$S110 :

;;			Init_Pressure_Sensor_3();
CLINEA 0000H 0001H 0397H 0004H 001CH
	bl	_Init_Pressure_Sensor_3

;;			break;
CLINEA 0000H 0001H 0398H 0004H 0009H
	bal	_$L105

;;		case 50:
CLINEA 0000H 0001H 0399H 0003H 000AH
_$S111 :

;;			Init_Color_Sensor_4();
CLINEA 0000H 0001H 039AH 0004H 0019H
	bl	_Init_Color_Sensor_4

;;			break;
CLINEA 0000H 0001H 039BH 0004H 0009H
	bal	_$L105

;;		case 56:
CLINEA 0000H 0001H 039CH 0003H 000AH
_$S112 :

;;			Init_ALS_PROX_Sensor_11();
CLINEA 0000H 0001H 039DH 0004H 001DH
	bl	_Init_ALS_PROX_Sensor_11

;;			break;
CLINEA 0000H 0001H 039EH 0004H 0009H
	bal	_$L105

;;		case 52:
CLINEA 0000H 0001H 039FH 0003H 000AH
_$S113 :

;;			Init_KXG03_Sensor_12();
CLINEA 0000H 0001H 03A0H 0004H 001AH
	bl	_Init_KXG03_Sensor_12

;;			break;
CLINEA 0000H 0001H 03A1H 0004H 0009H
	bal	_$L105

;;		case 5: 
CLINEA 0000H 0001H 03A2H 0003H 000AH
_$S114 :

;;			Init_Ambient_Light_Sensor_5(); // Refer to function description for list of sensors
CLINEA 0000H 0001H 03A3H 0004H 0056H
	bl	_Init_Ambient_Light_Sensor_5

;;			break;
CLINEA 0000H 0001H 03A4H 0004H 0009H
	bal	_$L105

;;		case 6:
CLINEA 0000H 0001H 03A5H 0003H 0009H
_$S115 :

;;			Init_Ambient_Light_Sensor_6(); // Refer to function description for list of sensors 
CLINEA 0000H 0001H 03A6H 0004H 0057H
	bl	_Init_Ambient_Light_Sensor_6

;;			break;
CLINEA 0000H 0001H 03A7H 0004H 0009H
	bal	_$L105

;;		case 7:
CLINEA 0000H 0001H 03A8H 0003H 0009H
_$S116 :

;;			Init_Ambient_Light_Sensor_7(); // Refer to function description for list of sensors 
CLINEA 0000H 0001H 03A9H 0004H 0057H
	bl	_Init_Ambient_Light_Sensor_7

;;			break;
CLINEA 0000H 0001H 03AAH 0004H 0009H
	bal	_$L105

;;		case 8:
CLINEA 0000H 0001H 03ABH 0003H 0009H
_$S117 :

;;			Init_Ambient_Light_Sensor_8(); // Refer to function description for list of sensors 
CLINEA 0000H 0001H 03ACH 0004H 0057H
	bl	_Init_Ambient_Light_Sensor_8

;;			break;
CLINEA 0000H 0001H 03ADH 0004H 0009H
	bal	_$L105

;;		case 9:
CLINEA 0000H 0001H 03AEH 0003H 0009H
_$S118 :

;;			Init_Ambient_Light_Sensor_9(); // Refer to function description for list of sensors 
CLINEA 0000H 0001H 03AFH 0004H 0057H
	bl	_Init_Ambient_Light_Sensor_9

;;			break;
CLINEA 0000H 0001H 03B0H 0004H 0009H
	bal	_$L105

;;		case 10:
CLINEA 0000H 0001H 03B1H 0003H 000AH
_$S119 :

;;			Init_UV_Sensor_10(); // Refer to function description for list of sensors 
CLINEA 0000H 0001H 03B2H 0004H 004DH
	bl	_Init_UV_Sensor_10

;;			break;
CLINEA 0000H 0001H 03B3H 0004H 0009H
	bal	_$L105

;;		case 15:
CLINEA 0000H 0001H 03B4H 0003H 000AH
_$S120 :

;;			Init_KX022(); // Refer to function description for list of sensors 
CLINEA 0000H 0001H 03B5H 0004H 0046H
	bl	_Init_KX022

;;			break;
CLINEA 0000H 0001H 03B6H 0004H 0009H
	bal	_$L105

;;		case 16:
CLINEA 0000H 0001H 03B7H 0003H 000AH
_$S121 :

;;			Init_KMX61(); // Refer to function description for list of sensors 
CLINEA 0000H 0001H 03B8H 0004H 0046H
	bl	_Init_KMX61

;;			break;
CLINEA 0000H 0001H 03B9H 0004H 0009H
	bal	_$L105

;;		case 20:
CLINEA 0000H 0001H 03BAH 0003H 000AH
_$S122 :

;;			Init_Temperature_Sensor_20(); // Refer to function description for list of sensors 
CLINEA 0000H 0001H 03BBH 0004H 0056H
	bl	_Init_Temperature_Sensor_20

;;			break;
CLINEA 0000H 0001H 03BCH 0004H 0009H
	bal	_$L105

;;		case 21:
CLINEA 0000H 0001H 03BDH 0003H 000AH
_$S123 :

;;			Init_Temperature_Sensor_21(); // Refer to function description for list of sensors
CLINEA 0000H 0001H 03BEH 0004H 0055H
	bl	_Init_Temperature_Sensor_21

;;			break;
CLINEA 0000H 0001H 03BFH 0004H 0009H
	b	_$L105

;;		case 22:
CLINEA 0000H 0001H 03C0H 0003H 000AH
_$S124 :

;;			Init_Temperature_Sensor_22(); // Refer to function description for list of sensors 
CLINEA 0000H 0001H 03C1H 0004H 0056H
	bl	_Init_Temperature_Sensor_22

;;			break;
CLINEA 0000H 0001H 03C2H 0004H 0009H
	b	_$L105

;;		case 23:
CLINEA 0000H 0001H 03C3H 0003H 000AH
_$S125 :

;;			Init_Temperature_Sensor_23(); // Refer to function description for list of sensors
CLINEA 0000H 0001H 03C4H 0004H 0055H
	bl	_Init_Temperature_Sensor_23

;;			break; 
CLINEA 0000H 0001H 03C5H 0004H 000AH
	b	_$L105

;;		default:
CLINEA 0000H 0001H 03C6H 0003H 000AH
_$L106 :

;;			break;
CLINEA 0000H 0001H 03C7H 0004H 0009H
	b	_$L105
CBLOCKEND 200 3 968
CBLOCKEND 200 1 969
CFUNCTIONEND 200


	rseg $$MainOp_Hall_Effect_Sensors_1$main
CFUNCTION 201

_MainOp_Hall_Effect_Sensors_1	:
CBLOCK 201 1 982

;;{
CLINEA 0000H 0001H 03D6H 0001H 0001H
	push	lr
CBLOCK 201 2 982
CRET 0000H

;;	if(SENINTF_HDR1_GPIO0(D)==1 && SENINTF_HDR1_GPIO1(D)==1)
CLINEA 0000H 0001H 03D7H 0002H 0039H
	tb	0f258h.2
	beq	_$L127
	tb	0f258h.3
	beq	_$L127
CBLOCK 201 3 984

;;		LEDOUT(0x0);	// Turn off all LEDs
CLINEA 0000H 0001H 03D9H 0003H 0023H
	mov	r0,	#00h
	st	r0,	0f260h

;;		PRINTF(ESC_ERASE2END "BU52004GUL> Hall – No Mag Fields Detected." ESC_SOL);
CLINEA 0000H 0001H 03DAH 0003H 004FH
	mov	er0,	#49
	push	er0
	mov	r2,	#BYTE1 OFFSET $$S134
	mov	r3,	#BYTE2 OFFSET $$S134
	mov	er0,	#0 
	bl	_write

;;	else if(SENINTF_HDR1_GPIO0(D)==1 && SENINTF_HDR1_GPIO1(D)==0)
CLINEA 0000H 0001H 03DCH 0002H 003EH
	bal	_$L153
_$L127 :
	tb	0f258h.2
	beq	_$L136
	tb	0f258h.3
	bne	_$L136
CBLOCK 201 4 989

;;		LEDOUT(0x02);	// Turn on LED1
CLINEA 0000H 0001H 03DEH 0003H 001FH
	mov	r0,	#02h
	st	r0,	0f260h

;;		PRINTF(ESC_ERASE2END "BU52004GUL> Hall – North Mag Field Detected." ESC_SOL);
CLINEA 0000H 0001H 03DFH 0003H 0051H
	mov	er0,	#51
	push	er0
	mov	r2,	#BYTE1 OFFSET $$S143
	mov	r3,	#BYTE2 OFFSET $$S143
	mov	er0,	#0 
	bl	_write

;;	else if(SENINTF_HDR1_GPIO0(D)==0 && SENINTF_HDR1_GPIO1(D)==1)
CLINEA 0000H 0001H 03E1H 0002H 003EH
	bal	_$L153
_$L136 :
	tb	0f258h.2
	bne	_$L145
	tb	0f258h.3
	beq	_$L145
CBLOCK 201 5 994

;;		LEDOUT(0x80);	// Turn on LED7
CLINEA 0000H 0001H 03E3H 0003H 001FH
	mov	r0,	#080h
	st	r0,	0f260h

;;		PRINTF(ESC_ERASE2END "BU52004GUL> Hall – South Mag Field Detected." ESC_SOL);
CLINEA 0000H 0001H 03E4H 0003H 0051H
	mov	er0,	#51
	push	er0
	mov	r2,	#BYTE1 OFFSET $$S152
	mov	r3,	#BYTE2 OFFSET $$S152
	mov	er0,	#0 
	bl	_write
CBLOCKEND 201 5 997

;;	else
CLINEA 0000H 0001H 03E6H 0002H 0005H
	bal	_$L153
_$L145 :
CBLOCK 201 6 999

;;		LEDOUT(0x82);	// Turn on LED7 and LED1
CLINEA 0000H 0001H 03E8H 0003H 0028H
	mov	r0,	#082h
	st	r0,	0f260h

;;		PRINTF( "BU52004GUL> Hall – Both Mag Fields Detected." ESC_NEWLINE);
CLINEA 0000H 0001H 03E9H 0003H 0048H
	mov	er0,	#49
	push	er0
	mov	r2,	#BYTE1 OFFSET $$S154
	mov	r3,	#BYTE2 OFFSET $$S154
	mov	er0,	#0 
	bl	_write
CBLOCKEND 201 6 1002

;;	}
CLINEA 0000H 0000H 03EAH 0002H 0002H
_$L153 :
	add	sp,	#2 
CBLOCKEND 201 4 1003
CBLOCKEND 201 3 1003
CBLOCKEND 201 2 1003

;;}
CLINEA 0000H 0001H 03EBH 0001H 0001H
	pop	pc
CBLOCKEND 201 1 1003
CFUNCTIONEND 201


	rseg $$MainOp_Hall_Effect_Sensors_2$main
CFUNCTION 202

_MainOp_Hall_Effect_Sensors_2	:
CBLOCK 202 1 1016

;;{
CLINEA 0000H 0001H 03F8H 0001H 0001H
	push	lr
CBLOCK 202 2 1016
CRET 0000H

;;	if(SENINTF_HDR1_GPIO0(D)==0)
CLINEA 0000H 0001H 03F9H 0002H 001DH
	tb	0f258h.2
	bne	_$L156
CBLOCK 202 3 1018

;;		LEDOUT(0x80);	// Turn on LED7
CLINEA 0000H 0001H 03FBH 0003H 001FH
	mov	r0,	#080h
	st	r0,	0f260h

;;		PRINTF( ESC_NEWLINE "BU52011HFV> \t\t\t\t= Mag Field Detected.        " ESC_NEWLINE );
CLINEA 0000H 0001H 03FCH 0003H 0058H
	mov	er0,	#50
	push	er0
	mov	r2,	#BYTE1 OFFSET $$S158
	mov	r3,	#BYTE2 OFFSET $$S158
	mov	er0,	#0 
	bl	_write
CBLOCKEND 202 3 1021

;;	else
CLINEA 0000H 0001H 03FEH 0002H 0005H
	bal	_$L159
_$L156 :
CBLOCK 202 4 1023

;;		LEDOUT(0x0);	// Turn off all LEDs
CLINEA 0000H 0001H 0400H 0003H 0023H
	mov	r0,	#00h
	st	r0,	0f260h

;;		PRINTF( ESC_NEWLINE "BU52011HFV> \t\t\t\t= No Mag Fields Detected.           " ESC_NEWLINE);
CLINEA 0000H 0001H 0401H 0003H 005EH
	mov	er0,	#57
	push	er0
	mov	r2,	#BYTE1 OFFSET $$S160
	mov	r3,	#BYTE2 OFFSET $$S160
	mov	er0,	#0 
	bl	_write
CBLOCKEND 202 4 1026

;;	}
CLINEA 0000H 0000H 0402H 0002H 0002H
_$L159 :
	add	sp,	#2 
CBLOCKEND 202 2 1027

;;}
CLINEA 0000H 0001H 0403H 0001H 0001H
	pop	pc
CBLOCKEND 202 1 1027
CFUNCTIONEND 202


	rseg $$MainOp_Pressure_Sensor_3$main
CFUNCTION 203

_MainOp_Pressure_Sensor_3	:
CBLOCK 203 1 1040

;;{
CLINEA 0000H 0001H 0410H 0001H 0001H
	push	lr
	push	fp
	mov	fp,	sp
	add	sp,	#-08
	push	xr8
	push	xr4
CBLOCK 203 2 1040
CRET 0012H
CLOCAL 47H 0004H 2928H 0002H "temperature" 02H 00H 03H
CLOCAL 4BH 0004H 0000H 0002H "pressure" 02H 00H 03H
CLOCAL 43H 0004H 0008H 0002H "var_int" 02H 00H 03H
CLOCAL 43H 0004H 0004H 0002H "var_frac" 02H 00H 03H
CLOCAL 47H 0004H 2726H 0002H "sign" 02H 00H 03H

;;	I2C_Read(BM1383GLV_I2C_ADDR, &BM1383GLV_TEMPERATURE_MSB, 1, uniRawSensorOut._ucharArr, 5);
CLINEA 0000H 0001H 0413H 0002H 005BH
	mov	r0,	#05h
	push	r0
	mov	r0,	#BYTE1 OFFSET _uniRawSensorOut
	mov	r1,	#BYTE2 OFFSET _uniRawSensorOut
	push	er0
	mov	r0,	#01h
	push	r0
	mov	r2,	#BYTE1 OFFSET _BM1383GLV_TEMPERATURE_MSB
	mov	r3,	#BYTE2 OFFSET _BM1383GLV_TEMPERATURE_MSB
	mov	r0,	#05dh
	bl	_I2C_Read
	add	sp,	#6 

;;	sign = ((uniRawSensorOut._ucharArr[0] >> 7) == 1) ? -1: 1 ;
CLINEA 0000H 0000H 0415H 0002H 003CH
	l	r0,	NEAR _uniRawSensorOut
	mov	r1,	#00h
	srlc	r0,	#07h
	sra	r1,	#07h
	cmp	r0,	#01h
	cmpc	r1,	#00h
	bne	_$L162
	mov	er0,	#-1
	bal	_$L164
_$L162 :
	mov	er0,	#1 
_$L164 :
	mov	r2,	r1
	extbw	er2
	mov	r2,	r3
	push	xr0
	bl	__fildu8sw
	pop	xr0

;;	var_frac = ( uniRawSensorOut._ucharArr[1] & 0x1f) * 0.03125 * sign  ; 		//0.03125 = 2^-5 
CLINEA 0000H 0001H 0416H 0002H 005AH
	push	xr0
	add	sp,	#-4
	bl	__ftodu8sw
	l	r0,	NEAR _uniRawSensorOut+01h
	mov	r1,	#00h
	and	r0,	#01fh
	and	r1,	#00h
	mov	r2,	r1
	extbw	er2
	mov	r2,	r3
	push	xr0
	add	sp,	#-4
	bl	__dildu8sw
	bl	__dmulu8sw
	add	sp,	#8 
	mov	er0,	#0 
	mov	er2,	#0 
	mov	er4,	#0 
	mov	r6,	#0a0h
	mov	r7,	#03fh
	push	qr0
	bl	__dmulu8sw
	add	sp,	#8 
	bl	__dtofu8sw
	add	sp,	#4 
	pop	xr0
	st	er0,	-4[fp]
	st	er2,	-2[fp]

;;	var_int  = ((signed char)uniRawSensorOut._ucharArr[0] )<< 3 |(uniRawSensorOut._ucharArr[1] >> 5) ;
CLINEA 0000H 0001H 0417H 0002H 0063H
	l	r0,	NEAR _uniRawSensorOut
	extbw	er0
	sllc	r1,	#03h
	sll	r0,	#03h
	l	r2,	NEAR _uniRawSensorOut+01h
	mov	r3,	#00h
	srlc	r2,	#05h
	sra	r3,	#05h
	or	r2,	r0
	or	r3,	r1
	mov	er0,	er2
	mov	r2,	r1
	extbw	er2
	mov	r2,	r3
	push	xr0
	bl	__fildu8sw
	pop	xr0
	st	er0,	-8[fp]
	st	er2,	-6[fp]

;;	temperature = (var_int + var_frac);///32 ;
CLINEA 0000H 0001H 0418H 0002H 002BH
	l	er0,	-4[fp]
	l	er2,	-2[fp]
	push	xr0
	l	er0,	-8[fp]
	l	er2,	-6[fp]
	push	xr0
	bl	__faddu8sw
	add	sp,	#4 
	pop	xr0
	mov	er8,	er0
	mov	er10,	er2

;;	var_int  = (uniRawSensorOut._ucharArr[2]<<3) | (uniRawSensorOut._ucharArr[3] >> 5);
CLINEA 0000H 0001H 041AH 0002H 0054H
	l	r0,	NEAR _uniRawSensorOut+02h
	mov	r1,	#00h
	sllc	r1,	#03h
	sll	r0,	#03h
	l	r2,	NEAR _uniRawSensorOut+03h
	mov	r3,	#00h
	srlc	r2,	#05h
	sra	r3,	#05h
	or	r2,	r0
	or	r3,	r1
	mov	er0,	er2
	mov	r2,	r1
	extbw	er2
	mov	r2,	r3
	push	xr0
	bl	__fildu8sw
	pop	xr0
	st	er0,	-8[fp]
	st	er2,	-6[fp]

;;	var_frac = ((uniRawSensorOut._ucharArr[3] & 0x1f) << 6 | (uniRawSensorOut._ucharArr[4] >> 2)) * 0.00048828125;  //0.00048828125 = 2^-11
CLINEA 0000H 0001H 041BH 0002H 0088H
	l	r0,	NEAR _uniRawSensorOut+03h
	mov	r1,	#00h
	and	r0,	#01fh
	and	r1,	#00h
	sllc	r1,	#06h
	sll	r0,	#06h
	l	r2,	NEAR _uniRawSensorOut+04h
	mov	r3,	#00h
	srlc	r2,	#02h
	sra	r3,	#02h
	or	r2,	r0
	or	r3,	r1
	mov	er0,	er2
	mov	r2,	r1
	extbw	er2
	mov	r2,	r3
	push	xr0
	add	sp,	#-4
	bl	__dildu8sw
	mov	er0,	#0 
	mov	er2,	#0 
	mov	r6,	#040h
	push	qr0
	bl	__dmulu8sw
	add	sp,	#8 
	bl	__dtofu8sw
	add	sp,	#4 
	pop	xr0
	st	er0,	-4[fp]
	st	er2,	-2[fp]

;;	printf( ESC_NEWLINE "BM1383> Pressure \t\t\t= %3.4f[hPa], \n\r\tTemperature \t\t\t= %3.4f[C]" ESC_NEWLINE, pressure,temperature);
CLINEA 0000H 0001H 041EH 0002H 0082H
	push	xr8
	add	sp,	#-4
	bl	__ftodu8sw
	l	er0,	-4[fp]
	l	er2,	-2[fp]
	push	xr0
	l	er0,	-8[fp]
	l	er2,	-6[fp]
	push	xr0
	bl	__faddu8sw
	bl	__ftodu8sw
	mov	r0,	#BYTE1 OFFSET $$S165
	mov	r1,	#BYTE2 OFFSET $$S165
	push	er0
	bl	_printf_n
	add	sp,	#18
CBLOCKEND 203 2 1056

;;}
CLINEA 0000H 0001H 0420H 0001H 0001H
	pop	xr4
	pop	xr8
	mov	sp,	fp
	pop	fp
	pop	pc
CBLOCKEND 203 1 1056
CFUNCTIONEND 203


	rseg $$MainOp_Color_Sensor_4$main
CFUNCTION 204

_MainOp_Color_Sensor_4	:
CBLOCK 204 1 1069

;;{
CLINEA 0000H 0001H 042DH 0001H 0001H
	push	lr
	push	xr4
	push	er8
CBLOCK 204 2 1069
CRET 0006H
CLOCAL 47H 0002H 0028H 0002H "R" 02H 00H 01H
CLOCAL 47H 0002H 0027H 0002H "G" 02H 00H 01H
CLOCAL 47H 0002H 0026H 0002H "B" 02H 00H 01H
CLOCAL 47H 0002H 0024H 0002H "C" 02H 00H 01H

;;	I2C_Read(BH1745_I2C_ADDR, &BH1745_RED_DATA_LSBs, 1, uniRawSensorOut._ucharArr, 4);		//ucharArr max 6 elens
CLINEA 0000H 0001H 042FH 0002H 006BH
	mov	r0,	#04h
	push	r0
	mov	r0,	#BYTE1 OFFSET _uniRawSensorOut
	mov	r1,	#BYTE2 OFFSET _uniRawSensorOut
	push	er0
	mov	r0,	#01h
	push	r0
	mov	r2,	#BYTE1 OFFSET _BH1745_RED_DATA_LSBs
	mov	r3,	#BYTE2 OFFSET _BH1745_RED_DATA_LSBs
	mov	r0,	#039h
	bl	_I2C_Read
	add	sp,	#6 

;;	R	= 	((int)uniRawSensorOut._ucharArr[0] | ((int)uniRawSensorOut._ucharArr[1])<<8);
CLINEA 0000H 0001H 0430H 0002H 0053H
	l	r0,	NEAR _uniRawSensorOut+01h
	mov	r1,	r0
	mov	r0,	#00h
	l	r2,	NEAR _uniRawSensorOut
	or	r0,	r2
	mov	er8,	er0

;;	G	= 	((int)uniRawSensorOut._ucharArr[2] | ((int)uniRawSensorOut._ucharArr[3])<<8);
CLINEA 0000H 0001H 0431H 0002H 0053H
	l	r2,	NEAR _uniRawSensorOut+02h
	l	r0,	NEAR _uniRawSensorOut+03h
	mov	r1,	r0
	mov	r0,	#00h
	or	r0,	r2
	mov	er6,	er0

;;	I2C_Read(BH1745_I2C_ADDR, &BH1745_BLUE_DATA_LSBs, 1, uniRawSensorOut._ucharArr, 4);		//ucharArr max 6 elens
CLINEA 0000H 0001H 0433H 0002H 006CH
	mov	r0,	#04h
	push	r0
	mov	r0,	#BYTE1 OFFSET _uniRawSensorOut
	mov	r1,	#BYTE2 OFFSET _uniRawSensorOut
	push	er0
	mov	r0,	#01h
	push	r0
	mov	r2,	#BYTE1 OFFSET _BH1745_BLUE_DATA_LSBs
	mov	r3,	#BYTE2 OFFSET _BH1745_BLUE_DATA_LSBs
	mov	r0,	#039h
	bl	_I2C_Read
	add	sp,	#6 

;;	B	= 	((int)uniRawSensorOut._ucharArr[0] | ((int)uniRawSensorOut._ucharArr[1])<<8);
CLINEA 0000H 0001H 0434H 0002H 0053H
	l	r0,	NEAR _uniRawSensorOut+01h
	mov	r1,	r0
	mov	r0,	#00h
	l	r2,	NEAR _uniRawSensorOut
	or	r0,	r2
	mov	er4,	er0

;;	C	 = 	((int)uniRawSensorOut._ucharArr[2] | ((int)uniRawSensorOut._ucharArr[3])<<8);
CLINEA 0000H 0001H 0435H 0002H 0054H
	l	r2,	NEAR _uniRawSensorOut+02h
	l	r0,	NEAR _uniRawSensorOut+03h
	mov	r1,	r0
	mov	r0,	#00h
	or	r0,	r2

;;	printf( ESC_NEWLINE "BH1745> R \t\t\t\t= %8hu, \n\r\tG \t\t\t\t= %8hu, \n\r\tB \t\t\t\t= %8hu, \n\r\tC \t\t\t\t= %8hu" ESC_NEWLINE, (unsigned short)R, (unsigned short)G, (unsigned short)B, (unsigned short)C);
CLINEA 0000H 0001H 0437H 0002H 00D1H
	push	er0
	push	er4
	push	er6
	push	er8
	mov	r0,	#BYTE1 OFFSET $$S167
	mov	r1,	#BYTE2 OFFSET $$S167
	push	er0
	bl	_printf_n
	add	sp,	#10
CBLOCKEND 204 2 1081

;;}
CLINEA 0000H 0001H 0439H 0001H 0001H
	pop	er8
	pop	xr4
	pop	pc
CBLOCKEND 204 1 1081
CFUNCTIONEND 204


	rseg $$MainOp_Ambient_Light_Sensor_5$main
CFUNCTION 205

_MainOp_Ambient_Light_Sensor_5	:
CBLOCK 205 1 1093

;;{	
CLINEA 0000H 0001H 0445H 0001H 0002H
	push	lr
CBLOCK 205 2 1093
CRET 0000H

;;	uniRawSensorOut._uint = ADC_Read(0);
CLINEA 0000H 0000H 0446H 0002H 0025H
	mov	r0,	#00h
	bl	_ADC_Read
	st	er0,	NEAR _uniRawSensorOut

;;	flSensorOut[0] = uniRawSensorOut._uint*3.3f/1023;
CLINEA 0000H 0001H 0448H 0002H 0032H
	mov	er2,	#0 
	push	xr0
	bl	__fuldu8sw
	mov	r0,	#033h
	mov	r1,	#033h
	mov	r2,	#053h
	mov	r3,	#040h
	push	xr0
	bl	__fmulu8sw
	add	sp,	#4 
	mov	r0,	#00h
	mov	r1,	#0c0h
	mov	r2,	#07fh
	mov	r3,	#044h
	push	xr0
	bl	__fdivu8sw
	add	sp,	#4 
	pop	xr0
	st	er0,	NEAR _flSensorOut
	st	er2,	NEAR _flSensorOut+02h

;;	switch(SENINTF_HDR1_GPIO1(D)<<1|SENINTF_HDR1_GPIO0(D))
CLINEA 0000H 0001H 044DH 0002H 0037H
	l	r0,	0f258h
	srl	r0,	#03h
	and	r0,	#01h
	mov	r1,	#00h
	mov	er2,	er0
	sllc	r3,	#01h
	sll	r2,	#01h
	l	r0,	0f258h
	srl	r0,	#02h
	and	r0,	#01h
	or	r0,	r2
	or	r1,	r3
	mov	er2,	er0
CBLOCK 205 3 1102
	cmp	r1,	#00h
	bne	_$L177
	mov	r0,	r2
	beq	_$L177

;;	switch(SENINTF_HDR1_GPIO1(D)<<1|SENINTF_HDR1_GPIO0(D))
CLINEA 0000H 0000H 044DH 0002H 0037H
	cmp	r2,	#01h
	beq	_$L174

;;	switch(SENINTF_HDR1_GPIO1(D)<<1|SENINTF_HDR1_GPIO0(D))
CLINEA 0000H 0000H 044DH 0002H 0037H
	cmp	r2,	#02h
	beq	_$L175

;;	switch(SENINTF_HDR1_GPIO1(D)<<1|SENINTF_HDR1_GPIO0(D))
CLINEA 0000H 0000H 044DH 0002H 0037H
	cmp	r2,	#03h
	bne	_$M21
	b	_$L176
_$M21 :

;;		case 0:	// Shutdown
CLINEA 0000H 0001H 0458H 0003H 0015H
_$L177 :

;;			flSensorOut[0] = 0;
CLINEA 0000H 0001H 045AH 0004H 0016H
	mov	er0,	#0 
	st	er0,	NEAR _flSensorOut
	st	er0,	NEAR _flSensorOut+02h
CBLOCKEND 205 3 1116

;;	}
CLINEA 0000H 0000H 045CH 0002H 0002H
_$L172 :

;;	LEDOUT(ReverseBits((unsigned char)(uniRawSensorOut._uint>>2)));
CLINEA 0000H 0000H 045EH 0002H 0040H
	l	er0,	NEAR _uniRawSensorOut
	srlc	r0,	#02h
	bl	_ReverseBits
	st	r0,	0f260h

;;	printf(ESC_ERASE2END "BH1620FVC> Ambient Light = %lu[lx]" ESC_SOL, (unsigned long)flSensorOut[0]);
CLINEA 0000H 0001H 045FH 0002H 0063H
	l	er0,	NEAR _flSensorOut
	l	er2,	NEAR _flSensorOut+02h
	push	xr0
	bl	__ftolu8sw
	pop	xr0
	push	xr0
	mov	r0,	#BYTE1 OFFSET $$S178
	mov	r1,	#BYTE2 OFFSET $$S178
	push	er0
	bl	_printf_n
	add	sp,	#6 
CBLOCKEND 205 2 1120

;;}
CLINEA 0000H 0001H 0460H 0001H 0001H
	pop	pc

;;		case 1: // H-Gain mode
CLINEA 0000H 0001H 044FH 0003H 0018H
_$L174 :

;;			flSensorOut[0] = flSensorOut[0]/(0.57e-6f*5.6e3f);
CLINEA 0000H 0001H 0450H 0004H 0035H
	l	er0,	NEAR _flSensorOut
	l	er2,	NEAR _flSensorOut+02h
	push	xr0
	mov	r0,	#0e0h
	mov	r1,	#030h
	mov	r2,	#051h
	mov	r3,	#03bh
	push	xr0
	bl	__fdivu8sw
	add	sp,	#4 
	pop	xr0
	st	er0,	NEAR _flSensorOut
	st	er2,	NEAR _flSensorOut+02h

;;			break;
CLINEA 0000H 0001H 0451H 0004H 0009H
	bal	_$L172

;;		case 2: // M-Gain mode
CLINEA 0000H 0001H 0452H 0003H 0018H
_$L175 :

;;			flSensorOut[0] = flSensorOut[0]/(0.057e-6f*5.6e3f);
CLINEA 0000H 0001H 0453H 0004H 0036H
	l	er0,	NEAR _flSensorOut
	l	er2,	NEAR _flSensorOut+02h
	push	xr0
	mov	r0,	#04dh
	mov	r1,	#05ah
	mov	r2,	#0a7h
	mov	r3,	#039h
	push	xr0
	bl	__fdivu8sw
	add	sp,	#4 
	pop	xr0
	st	er0,	NEAR _flSensorOut
	st	er2,	NEAR _flSensorOut+02h

;;			break;
CLINEA 0000H 0001H 0454H 0004H 0009H
	bal	_$L172

;;		case 3: // L-Gain mode
CLINEA 0000H 0001H 0455H 0003H 0018H
_$L176 :

;;			flSensorOut[0] = flSensorOut[0]/(0.0057e-6f*5.6e3f);
CLINEA 0000H 0001H 0456H 0004H 0037H
	l	er0,	NEAR _flSensorOut
	l	er2,	NEAR _flSensorOut+02h
	push	xr0
	mov	r0,	#0d7h
	mov	r1,	#0e1h
	mov	r2,	#05h
	mov	r3,	#038h
	push	xr0
	bl	__fdivu8sw
	add	sp,	#4 
	pop	xr0
	st	er0,	NEAR _flSensorOut
	st	er2,	NEAR _flSensorOut+02h

;;			break;
CLINEA 0000H 0001H 0457H 0004H 0009H
	b	_$L172
CBLOCKEND 205 1 1120
CFUNCTIONEND 205


	rseg $$MainOp_Ambient_Light_Sensor_6$main
CFUNCTION 206

_MainOp_Ambient_Light_Sensor_6	:
CBLOCK 206 1 1133

;;{
CLINEA 0000H 0001H 046DH 0001H 0001H
	push	lr
CBLOCK 206 2 1133
CRET 0000H

;;	I2C_Read(BH17xxFVC_ADDR_1, NULL, 0, uniRawSensorOut._ucharArr, 2);
CLINEA 0000H 0001H 0473H 0002H 0043H
	mov	r0,	#02h
	push	r0
	mov	r0,	#BYTE1 OFFSET _uniRawSensorOut
	mov	r1,	#BYTE2 OFFSET _uniRawSensorOut
	push	er0
	mov	r0,	#00h
	push	r0
	mov	er2,	#0 
	mov	r0,	#023h
	bl	_I2C_Read
	add	sp,	#6 

;;	flSensorOut[0] = (uniRawSensorOut._ucharArr[0]<<8|uniRawSensorOut._ucharArr[1])/1.2f;
CLINEA 0000H 0001H 0477H 0002H 0056H
	l	r0,	NEAR _uniRawSensorOut
	mov	r1,	#00h
	mov	r3,	r0
	l	r0,	NEAR _uniRawSensorOut+01h
	or	r1,	r3
	mov	r2,	r1
	extbw	er2
	mov	r2,	r3
	push	xr0
	bl	__fildu8sw
	mov	r0,	#09ah
	mov	r1,	#099h
	mov	r2,	#099h
	mov	r3,	#03fh
	push	xr0
	bl	__fdivu8sw
	add	sp,	#4 
	pop	xr0
	st	er0,	NEAR _flSensorOut
	st	er2,	NEAR _flSensorOut+02h

;;	LEDOUT(ReverseBits(uniRawSensorOut._ucharArr[0]));
CLINEA 0000H 0000H 0479H 0002H 0033H
	l	r0,	NEAR _uniRawSensorOut
	bl	_ReverseBits
	st	r0,	0f260h

;;	printf(ESC_ERASE2END "BH1710FVC> Ambient Light = %lu[lx]" ESC_SOL, (unsigned long)flSensorOut[0]);
CLINEA 0000H 0001H 047AH 0002H 0063H
	l	er0,	NEAR _flSensorOut
	l	er2,	NEAR _flSensorOut+02h
	push	xr0
	bl	__ftolu8sw
	pop	xr0
	push	xr0
	mov	r0,	#BYTE1 OFFSET $$S180
	mov	r1,	#BYTE2 OFFSET $$S180
	push	er0
	bl	_printf_n
	add	sp,	#6 
CBLOCKEND 206 2 1147

;;}
CLINEA 0000H 0001H 047BH 0001H 0001H
	pop	pc
CBLOCKEND 206 1 1147
CFUNCTIONEND 206


	rseg $$MainOp_Ambient_Light_Sensor_7$main
CFUNCTION 207

_MainOp_Ambient_Light_Sensor_7	:
CBLOCK 207 1 1160

;;{
CLINEA 0000H 0001H 0488H 0001H 0001H
	push	lr
	push	xr4
CBLOCK 207 2 1160
CRET 0004H

;;	I2C_Read(BH17xxFVC_ADDR_2, NULL, 0, uniRawSensorOut._ucharArr, 4);
CLINEA 0000H 0001H 048EH 0002H 0043H
	mov	r0,	#04h
	push	r0
	mov	r0,	#BYTE1 OFFSET _uniRawSensorOut
	mov	r1,	#BYTE2 OFFSET _uniRawSensorOut
	push	er0
	mov	r0,	#00h
	push	r0
	mov	er2,	#0 
	mov	r0,	#029h
	bl	_I2C_Read
	add	sp,	#6 

;;	flSensorOut[0] = (float)uniRawSensorOut._uintArr[1]/uniRawSensorOut._uintArr[0];
CLINEA 0000H 0001H 0495H 0002H 0051H
	l	er0,	NEAR _uniRawSensorOut+02h
	mov	er2,	#0 
	push	xr0
	bl	__fuldu8sw
	pop	xr0
	l	er4,	NEAR _uniRawSensorOut
	mov	er6,	#0 
	push	xr4
	bl	__fuldu8sw
	pop	xr4
	push	xr0
	push	xr4
	bl	__fdivu8sw
	add	sp,	#4 
	pop	xr0
	st	er0,	NEAR _flSensorOut
	st	er2,	NEAR _flSensorOut+02h

;;	if(flSensorOut[0]<0.26f)
CLINEA 0000H 0001H 0496H 0002H 0019H
	push	xr0
	mov	r0,	#0b8h
	mov	r1,	#01eh
	mov	r2,	#085h
	mov	r3,	#03eh
	push	xr0
	bl	__fcmpu8sw
	add	sp,	#8 
	mov	psw,	r0
	bge	_$L182

;;		flSensorOut[0] = (1.290f*uniRawSensorOut._uintArr[0]-2.733f*uniRawSensorOut._uintArr[1])/1*100/218;
CLINEA 0000H 0001H 0497H 0003H 0065H
	l	er0,	NEAR _uniRawSensorOut
	mov	er2,	#0 
	push	xr0
	bl	__fuldu8sw
	mov	r0,	#0b8h
	mov	r1,	#01eh
	mov	r2,	#0a5h
	mov	r3,	#03fh
	push	xr0
	bl	__fmulu8sw
	add	sp,	#4 
	pop	xr4
	l	er0,	NEAR _uniRawSensorOut+02h
	mov	er2,	#0 
	push	xr0
	bl	__fuldu8sw
	mov	r0,	#079h
	mov	r1,	#0e9h
	mov	r2,	#02eh
	mov	r3,	#040h
	push	xr0
	bl	__fmulu8sw
	add	sp,	#4 
	pop	xr0
	push	qr0
	bl	__fsubu8sw
	add	sp,	#4 
	mov	er0,	#0 
	mov	r2,	#0c8h
	mov	r3,	#042h
	push	xr0
	bl	__fmulu8sw
	add	sp,	#4 
	mov	r2,	#05ah
	mov	r3,	#043h
	push	xr0
	bl	__fdivu8sw
	add	sp,	#4 
	pop	xr0
	st	er0,	NEAR _flSensorOut
	st	er2,	NEAR _flSensorOut+02h

;;	else if(flSensorOut[0]<0.55f)
CLINEA 0000H 0001H 0498H 0002H 001EH
	b	_$L193
_$L182 :
	l	er0,	NEAR _flSensorOut
	l	er2,	NEAR _flSensorOut+02h
	push	xr0
	mov	r0,	#0cdh
	mov	r1,	#0cch
	mov	r2,	#0ch
	mov	r3,	#03fh
	push	xr0
	bl	__fcmpu8sw
	add	sp,	#8 
	mov	psw,	r0
	bge	_$L185

;;		flSensorOut[0] = (0.795f*uniRawSensorOut._uintArr[0]-0.859f*uniRawSensorOut._uintArr[1])/1*100/218;
CLINEA 0000H 0001H 0499H 0003H 0065H
	l	er0,	NEAR _uniRawSensorOut
	mov	er2,	#0 
	push	xr0
	bl	__fuldu8sw
	mov	r0,	#01fh
	mov	r1,	#085h
	mov	r2,	#04bh
	mov	r3,	#03fh
	push	xr0
	bl	__fmulu8sw
	add	sp,	#4 
	pop	xr4
	l	er0,	NEAR _uniRawSensorOut+02h
	mov	er2,	#0 
	push	xr0
	bl	__fuldu8sw
	mov	r0,	#06dh
	mov	r1,	#0e7h
	mov	r2,	#05bh
	mov	r3,	#03fh
	push	xr0
	bl	__fmulu8sw
	add	sp,	#4 
	pop	xr0
	push	qr0
	bl	__fsubu8sw
	add	sp,	#4 
	mov	er0,	#0 
	mov	r2,	#0c8h
	mov	r3,	#042h
	push	xr0
	bl	__fmulu8sw
	add	sp,	#4 
	mov	r2,	#05ah
	mov	r3,	#043h
	push	xr0
	bl	__fdivu8sw
	add	sp,	#4 
	pop	xr0
	st	er0,	NEAR _flSensorOut
	st	er2,	NEAR _flSensorOut+02h

;;	else if(flSensorOut[0]<1.09f)
CLINEA 0000H 0001H 049AH 0002H 001EH
	b	_$L193
_$L185 :
	l	er0,	NEAR _flSensorOut
	l	er2,	NEAR _flSensorOut+02h
	push	xr0
	mov	r0,	#01fh
	mov	r1,	#085h
	mov	r2,	#08bh
	mov	r3,	#03fh
	push	xr0
	bl	__fcmpu8sw
	add	sp,	#8 
	mov	psw,	r0
	bge	_$L188

;;		flSensorOut[0] = (0.510f*uniRawSensorOut._uintArr[0]-0.345f*uniRawSensorOut._uintArr[1])/1*100/218;
CLINEA 0000H 0001H 049BH 0003H 0065H
	l	er0,	NEAR _uniRawSensorOut
	mov	er2,	#0 
	push	xr0
	bl	__fuldu8sw
	mov	r0,	#05ch
	mov	r1,	#08fh
	mov	r2,	#02h
	mov	r3,	#03fh
	push	xr0
	bl	__fmulu8sw
	add	sp,	#4 
	pop	xr4
	l	er0,	NEAR _uniRawSensorOut+02h
	mov	er2,	#0 
	push	xr0
	bl	__fuldu8sw
	mov	r0,	#0d7h
	mov	r1,	#0a3h
	mov	r2,	#0b0h
	mov	r3,	#03eh
	push	xr0
	bl	__fmulu8sw
	add	sp,	#4 
	pop	xr0
	push	qr0
	bl	__fsubu8sw
	add	sp,	#4 
	mov	er0,	#0 
	mov	r2,	#0c8h
	mov	r3,	#042h
	push	xr0
	bl	__fmulu8sw
	add	sp,	#4 
	mov	r2,	#05ah
	mov	r3,	#043h
	push	xr0
	bl	__fdivu8sw
	add	sp,	#4 
	pop	xr0
	st	er0,	NEAR _flSensorOut
	st	er2,	NEAR _flSensorOut+02h

;;	else if(flSensorOut[0]<2.13f)
CLINEA 0000H 0001H 049CH 0002H 001EH
	b	_$L193
_$L188 :
	l	er0,	NEAR _flSensorOut
	l	er2,	NEAR _flSensorOut+02h
	push	xr0
	mov	r0,	#0ech
	mov	r1,	#051h
	mov	r2,	#08h
	mov	r3,	#040h
	push	xr0
	bl	__fcmpu8sw
	add	sp,	#8 
	mov	psw,	r0
	bge	_$L191

;;		flSensorOut[0] = (0.276f*uniRawSensorOut._uintArr[0]-0.130f*uniRawSensorOut._uintArr[1])/1*100/218;
CLINEA 0000H 0001H 049DH 0003H 0065H
	l	er0,	NEAR _uniRawSensorOut
	mov	er2,	#0 
	push	xr0
	bl	__fuldu8sw
	mov	r0,	#0dfh
	mov	r1,	#04fh
	mov	r2,	#08dh
	mov	r3,	#03eh
	push	xr0
	bl	__fmulu8sw
	add	sp,	#4 
	pop	xr4
	l	er0,	NEAR _uniRawSensorOut+02h
	mov	er2,	#0 
	push	xr0
	bl	__fuldu8sw
	mov	r0,	#0b8h
	mov	r1,	#01eh
	mov	r2,	#05h
	mov	r3,	#03eh
	push	xr0
	bl	__fmulu8sw
	add	sp,	#4 
	pop	xr0
	push	qr0
	bl	__fsubu8sw
	add	sp,	#4 
	mov	er0,	#0 
	mov	r2,	#0c8h
	mov	r3,	#042h
	push	xr0
	bl	__fmulu8sw
	add	sp,	#4 
	mov	r2,	#05ah
	mov	r3,	#043h
	push	xr0
	bl	__fdivu8sw
	add	sp,	#4 
	pop	xr0
	st	er0,	NEAR _flSensorOut
	st	er2,	NEAR _flSensorOut+02h

;;	else
CLINEA 0000H 0001H 049EH 0002H 0005H
	bal	_$L193
_$L191 :

;;		flSensorOut[0] = 0;
CLINEA 0000H 0001H 049FH 0003H 0015H
	mov	er0,	#0 
	st	er0,	NEAR _flSensorOut
	st	er0,	NEAR _flSensorOut+02h
_$L193 :

;;	LEDOUT(ReverseBits(uniRawSensorOut._ucharArr[1]));
CLINEA 0000H 0000H 04A1H 0002H 0033H
	l	r0,	NEAR _uniRawSensorOut+01h
	bl	_ReverseBits
	st	r0,	0f260h

;;	printf(ESC_ERASE2END "BH1730FVC> Ambient Light = %lu[lx]" ESC_SOL, (unsigned long)flSensorOut[0]);
CLINEA 0000H 0001H 04A2H 0002H 0063H
	l	er0,	NEAR _flSensorOut
	l	er2,	NEAR _flSensorOut+02h
	push	xr0
	bl	__ftolu8sw
	pop	xr0
	push	xr0
	mov	r0,	#BYTE1 OFFSET $$S194
	mov	r1,	#BYTE2 OFFSET $$S194
	push	er0
	bl	_printf_n
	add	sp,	#6 
CBLOCKEND 207 2 1187

;;}
CLINEA 0000H 0001H 04A3H 0001H 0001H
	pop	xr4
	pop	pc
CBLOCKEND 207 1 1187
CFUNCTIONEND 207


	rseg $$MainOp_Ambient_Light_Sensor_8$main
CFUNCTION 208

_MainOp_Ambient_Light_Sensor_8	:
CBLOCK 208 1 1200

;;{	
CLINEA 0000H 0001H 04B0H 0001H 0002H
	push	lr
CBLOCK 208 2 1200
CRET 0000H

;;	I2C_Read(BH17xxFVC_ADDR_1, NULL, 0, uniRawSensorOut._ucharArr, 2);
CLINEA 0000H 0001H 04B5H 0002H 0043H
	mov	r0,	#02h
	push	r0
	mov	r0,	#BYTE1 OFFSET _uniRawSensorOut
	mov	r1,	#BYTE2 OFFSET _uniRawSensorOut
	push	er0
	mov	r0,	#00h
	push	r0
	mov	er2,	#0 
	mov	r0,	#023h
	bl	_I2C_Read
	add	sp,	#6 

;;	flSensorOut[0] = (uniRawSensorOut._ucharArr[0]<<8|uniRawSensorOut._ucharArr[1])/1.2f;
CLINEA 0000H 0001H 04B9H 0002H 0056H
	l	r0,	NEAR _uniRawSensorOut
	mov	r1,	#00h
	mov	r3,	r0
	l	r0,	NEAR _uniRawSensorOut+01h
	or	r1,	r3
	mov	r2,	r1
	extbw	er2
	mov	r2,	r3
	push	xr0
	bl	__fildu8sw
	mov	r0,	#09ah
	mov	r1,	#099h
	mov	r2,	#099h
	mov	r3,	#03fh
	push	xr0
	bl	__fdivu8sw
	add	sp,	#4 
	pop	xr0
	st	er0,	NEAR _flSensorOut
	st	er2,	NEAR _flSensorOut+02h

;;	LEDOUT(ReverseBits(uniRawSensorOut._ucharArr[0]));
CLINEA 0000H 0000H 04BBH 0002H 0033H
	l	r0,	NEAR _uniRawSensorOut
	bl	_ReverseBits
	st	r0,	0f260h

;;	printf(ESC_ERASE2END "BH1721FVC> Ambient Light = %lu[lx]" ESC_SOL, (unsigned long)flSensorOut[0]);
CLINEA 0000H 0001H 04BCH 0002H 0063H
	l	er0,	NEAR _flSensorOut
	l	er2,	NEAR _flSensorOut+02h
	push	xr0
	bl	__ftolu8sw
	pop	xr0
	push	xr0
	mov	r0,	#BYTE1 OFFSET $$S196
	mov	r1,	#BYTE2 OFFSET $$S196
	push	er0
	bl	_printf_n
	add	sp,	#6 
CBLOCKEND 208 2 1213

;;}
CLINEA 0000H 0001H 04BDH 0001H 0001H
	pop	pc
CBLOCKEND 208 1 1213
CFUNCTIONEND 208


	rseg $$MainOp_Ambient_Light_Sensor_9$main
CFUNCTION 209

_MainOp_Ambient_Light_Sensor_9	:
CBLOCK 209 1 1226

;;{
CLINEA 0000H 0001H 04CAH 0001H 0001H
	push	lr
CBLOCK 209 2 1226
CRET 0000H

;;	I2C_Read(BH17xxFVC_ADDR_2, NULL, 0, uniRawSensorOut._ucharArr, 2);
CLINEA 0000H 0001H 04D0H 0002H 0043H
	mov	r0,	#02h
	push	r0
	mov	r0,	#BYTE1 OFFSET _uniRawSensorOut
	mov	r1,	#BYTE2 OFFSET _uniRawSensorOut
	push	er0
	mov	r0,	#00h
	push	r0
	mov	er2,	#0 
	mov	r0,	#029h
	bl	_I2C_Read
	add	sp,	#6 

;;	flSensorOut[0] = uniRawSensorOut._uint;
CLINEA 0000H 0001H 04D4H 0002H 0028H
	l	er0,	NEAR _uniRawSensorOut
	mov	er2,	#0 
	push	xr0
	bl	__fuldu8sw
	pop	xr0
	st	er0,	NEAR _flSensorOut
	st	er2,	NEAR _flSensorOut+02h

;;	LEDOUT(ReverseBits(uniRawSensorOut._ucharArr[1]));
CLINEA 0000H 0000H 04D6H 0002H 0033H
	l	r0,	NEAR _uniRawSensorOut+01h
	bl	_ReverseBits
	st	r0,	0f260h

;;	printf(ESC_ERASE2END "BH1780GLI> Ambient Light = %lu[lx]" ESC_SOL, (unsigned long)flSensorOut[0]);
CLINEA 0000H 0001H 04D7H 0002H 0063H
	l	er0,	NEAR _flSensorOut
	l	er2,	NEAR _flSensorOut+02h
	push	xr0
	bl	__ftolu8sw
	pop	xr0
	push	xr0
	mov	r0,	#BYTE1 OFFSET $$S198
	mov	r1,	#BYTE2 OFFSET $$S198
	push	er0
	bl	_printf_n
	add	sp,	#6 
CBLOCKEND 209 2 1240

;;}
CLINEA 0000H 0001H 04D8H 0001H 0001H
	pop	pc
CBLOCKEND 209 1 1240
CFUNCTIONEND 209


	rseg $$MainOp_UV_Sensor_10$main
CFUNCTION 210

_MainOp_UV_Sensor_10	:
CBLOCK 210 1 1253

;;{
CLINEA 0000H 0001H 04E5H 0001H 0001H
	push	lr
CBLOCK 210 2 1253
CRET 0000H

;;	uniRawSensorOut._uint = ADC_Read(1);
CLINEA 0000H 0000H 04E6H 0002H 0025H
	mov	r0,	#01h
	bl	_ADC_Read
	st	er0,	NEAR _uniRawSensorOut

;;	flSensorOut[0] = uniRawSensorOut._uint*3.3f/1023;
CLINEA 0000H 0001H 04E8H 0002H 0032H
	mov	er2,	#0 
	push	xr0
	bl	__fuldu8sw
	mov	r0,	#033h
	mov	r1,	#033h
	mov	r2,	#053h
	mov	r3,	#040h
	push	xr0
	bl	__fmulu8sw
	add	sp,	#4 
	mov	r0,	#00h
	mov	r1,	#0c0h
	mov	r2,	#07fh
	mov	r3,	#044h
	push	xr0
	bl	__fdivu8sw
	add	sp,	#4 
	pop	xr0
	st	er0,	NEAR _flSensorOut
	st	er2,	NEAR _flSensorOut+02h

;;	flSensorOut[1] = Voltage2UVIntensity(flSensorOut[0]);
CLINEA 0000H 0001H 04EAH 0002H 0036H
	push	xr0
	mov	r0,	#0cdh
	mov	r1,	#0cch
	mov	r2,	#0ch
	mov	r3,	#0c0h
	push	xr0
	bl	__faddu8sw
	add	sp,	#4 
	mov	r0,	#093h
	mov	r1,	#018h
	mov	r2,	#04h
	mov	r3,	#03eh
	push	xr0
	bl	__fdivu8sw
	add	sp,	#4 
	mov	er0,	#0 
	mov	r2,	#020h
	mov	r3,	#041h
	push	xr0
	bl	__faddu8sw
	add	sp,	#4 
	pop	xr0
	st	er0,	NEAR _flSensorOut+04h
	st	er2,	NEAR _flSensorOut+06h

;;	LEDOUT(ReverseBits((unsigned char)(uniRawSensorOut._uint>>2)));
CLINEA 0000H 0000H 04ECH 0002H 0040H
	l	er0,	NEAR _uniRawSensorOut
	srlc	r0,	#02h
	bl	_ReverseBits
	st	r0,	0f260h

;;	printf( "\n\rML8511> UV Intensity \t\t\t= %.02f[mW/cm2]. \n\r\tVsenout \t\t\t= %.02f[V] \n\r" , flSensorOut[1], flSensorOut[0]);
CLINEA 0000H 0001H 04EDH 0002H 0081H
	l	er0,	NEAR _flSensorOut
	l	er2,	NEAR _flSensorOut+02h
	push	xr0
	add	sp,	#-4
	bl	__ftodu8sw
	l	er0,	NEAR _flSensorOut+04h
	l	er2,	NEAR _flSensorOut+06h
	push	xr0
	add	sp,	#-4
	bl	__ftodu8sw
	mov	r0,	#BYTE1 OFFSET $$S200
	mov	r1,	#BYTE2 OFFSET $$S200
	push	er0
	bl	_printf_n
	add	sp,	#18
CBLOCKEND 210 2 1262

;;}
CLINEA 0000H 0001H 04EEH 0001H 0001H
	pop	pc
CBLOCKEND 210 1 1262
CFUNCTIONEND 210


	rseg $$MainOp_ALS_PROX_Sensor_11$main
CFUNCTION 211

_MainOp_ALS_PROX_Sensor_11	:
CBLOCK 211 1 1275

;;{
CLINEA 0000H 0001H 04FBH 0001H 0001H
	push	lr
	push	er4
CBLOCK 211 2 1275
CRET 0002H
CLOCAL 46H 0002H 0026H 0002H "Prox" 02H 00H 08H
CLOCAL 46H 0002H 0024H 0002H "ALS" 02H 00H 08H

;;	I2C_Read(RPR0521_I2C_ADDR, &RPR0521_Prox_PS_LSB, 1, uniRawSensorOut._ucharArr, 8);
CLINEA 0000H 0001H 04FDH 0002H 0053H
	mov	r0,	#08h
	push	r0
	mov	r0,	#BYTE1 OFFSET _uniRawSensorOut
	mov	r1,	#BYTE2 OFFSET _uniRawSensorOut
	push	er0
	mov	r0,	#01h
	push	r0
	mov	r2,	#BYTE1 OFFSET _RPR0521_Prox_PS_LSB
	mov	r3,	#BYTE2 OFFSET _RPR0521_Prox_PS_LSB
	mov	r0,	#038h
	bl	_I2C_Read
	add	sp,	#6 

;;	Prox	= 	((unsigned short)uniRawSensorOut._ucharArr[0] | ((unsigned short)uniRawSensorOut._ucharArr[1])<<8);
CLINEA 0000H 0001H 04FEH 0002H 006CH
	l	r0,	NEAR _uniRawSensorOut+01h
	mov	r1,	r0
	mov	r0,	#00h
	l	r2,	NEAR _uniRawSensorOut
	or	r0,	r2
	mov	er4,	er0

;;	ALS		= 	((unsigned short)uniRawSensorOut._ucharArr[2] | ((unsigned short)uniRawSensorOut._ucharArr[3])<<8);
CLINEA 0000H 0001H 04FFH 0002H 006CH
	l	r2,	NEAR _uniRawSensorOut+02h
	l	r0,	NEAR _uniRawSensorOut+03h
	mov	r1,	r0
	mov	r0,	#00h
	or	r0,	r2

;;	printf( ESC_NEWLINE "RPR0521> Prox \t\t\t\t= %10lu[raw], \n\r\tALS \t\t\t\t= %10lu[raw]" ESC_NEWLINE, (long)Prox, (long)ALS);
CLINEA 0000H 0001H 0501H 0002H 007EH
	mov	er2,	#0 
	push	xr0
	mov	er0,	er4
	push	xr0
	mov	r0,	#BYTE1 OFFSET $$S202
	mov	r1,	#BYTE2 OFFSET $$S202
	push	er0
	bl	_printf_n
	add	sp,	#10
CBLOCKEND 211 2 1282

;;}
CLINEA 0000H 0001H 0502H 0001H 0001H
	pop	er4
	pop	pc
CBLOCKEND 211 1 1282
CFUNCTIONEND 211


	rseg $$MainOp_KXG03_Sensor_12$main
CFUNCTION 212

_MainOp_KXG03_Sensor_12	:
CBLOCK 212 1 1295

;;{
CLINEA 0000H 0001H 050FH 0001H 0001H
	push	lr
CBLOCK 212 2 1295
CRET 0000H

;;	I2C_Read(KXG03_I2C_ADDR, &KXG03_GYRO_XOUT_L, 1, uniRawSensorOut._ucharArr, 6);
CLINEA 0000H 0001H 0514H 0002H 004FH
	mov	r0,	#06h
	push	r0
	mov	r0,	#BYTE1 OFFSET _uniRawSensorOut
	mov	r1,	#BYTE2 OFFSET _uniRawSensorOut
	push	er0
	mov	r0,	#01h
	push	r0
	mov	r2,	#BYTE1 OFFSET _KXG03_GYRO_XOUT_L
	mov	r3,	#BYTE2 OFFSET _KXG03_GYRO_XOUT_L
	mov	r0,	#04eh
	bl	_I2C_Read
	add	sp,	#6 

;;	flSensorOut[0] = (float)uniRawSensorOut._intArr[0]*2048/32768.0f;	// GX
CLINEA 0000H 0001H 0517H 0002H 0048H
	l	er0,	NEAR _uniRawSensorOut
	mov	r2,	r1
	extbw	er2
	mov	r2,	r3
	push	xr0
	bl	__fildu8sw
	mov	er0,	#0 
	mov	r2,	#00h
	mov	r3,	#045h
	push	xr0
	bl	__fmulu8sw
	add	sp,	#4 
	mov	r3,	#047h
	push	xr0
	bl	__fdivu8sw
	add	sp,	#4 
	pop	xr0
	st	er0,	NEAR _flSensorOut
	st	er2,	NEAR _flSensorOut+02h

;;	flSensorOut[1] = (float)uniRawSensorOut._intArr[1]*2048/32768.0f;	// GY
CLINEA 0000H 0001H 0518H 0002H 0048H
	l	er0,	NEAR _uniRawSensorOut+02h
	mov	r2,	r1
	extbw	er2
	mov	r2,	r3
	push	xr0
	bl	__fildu8sw
	mov	er0,	#0 
	mov	r2,	#00h
	mov	r3,	#045h
	push	xr0
	bl	__fmulu8sw
	add	sp,	#4 
	mov	r3,	#047h
	push	xr0
	bl	__fdivu8sw
	add	sp,	#4 
	pop	xr0
	st	er0,	NEAR _flSensorOut+04h
	st	er2,	NEAR _flSensorOut+06h

;;	flSensorOut[2] = (float)uniRawSensorOut._intArr[2]*2048/32768.0f;	// GZ
CLINEA 0000H 0001H 0519H 0002H 0048H
	l	er0,	NEAR _uniRawSensorOut+04h
	mov	r2,	r1
	extbw	er2
	mov	r2,	r3
	push	xr0
	bl	__fildu8sw
	mov	er0,	#0 
	mov	r2,	#00h
	mov	r3,	#045h
	push	xr0
	bl	__fmulu8sw
	add	sp,	#4 
	mov	r3,	#047h
	push	xr0
	bl	__fdivu8sw
	add	sp,	#4 
	pop	xr0
	st	er0,	NEAR _flSensorOut+08h
	st	er2,	NEAR _flSensorOut+0ah

;;		uniRawSensorOut._intArr[0], flSensorOut[0], uniRawSensorOut._intArr[1], flSensorOut[1], uniRawSensorOut._intArr[2], flSensorOut[2]);
CLINEA 0000H 0001H 051CH 0003H 0086H
	push	xr0
	add	sp,	#-4
	bl	__ftodu8sw
	l	er0,	NEAR _uniRawSensorOut+04h
	push	er0
	l	er0,	NEAR _flSensorOut+04h
	l	er2,	NEAR _flSensorOut+06h
	push	xr0
	add	sp,	#-4
	bl	__ftodu8sw
	l	er0,	NEAR _uniRawSensorOut+02h
	push	er0
	l	er0,	NEAR _flSensorOut
	l	er2,	NEAR _flSensorOut+02h
	push	xr0
	add	sp,	#-4
	bl	__ftodu8sw
	l	er0,	NEAR _uniRawSensorOut
	push	er0
	mov	r0,	#BYTE1 OFFSET $$S204
	mov	r1,	#BYTE2 OFFSET $$S204
	push	er0
	bl	_printf_n
	add	sp,	#32

;;	I2C_Read(KXG03_I2C_ADDR, &KXG03_ACC_XOUT_L, 1, uniRawSensorOut._ucharArr, 6);
CLINEA 0000H 0001H 051FH 0002H 004EH
	mov	r0,	#06h
	push	r0
	mov	r0,	#BYTE1 OFFSET _uniRawSensorOut
	mov	r1,	#BYTE2 OFFSET _uniRawSensorOut
	push	er0
	mov	r0,	#01h
	push	r0
	mov	r2,	#BYTE1 OFFSET _KXG03_ACC_XOUT_L
	mov	r3,	#BYTE2 OFFSET _KXG03_ACC_XOUT_L
	mov	r0,	#04eh
	bl	_I2C_Read
	add	sp,	#6 

;;	flSensorOut[0] = (float)uniRawSensorOut._intArr[0]*2/2048.0f;	// AX
CLINEA 0000H 0001H 0522H 0002H 0044H
	l	er0,	NEAR _uniRawSensorOut
	mov	r2,	r1
	extbw	er2
	mov	r2,	r3
	push	xr0
	bl	__fildu8sw
	mov	er0,	#0 
	mov	r2,	#00h
	mov	r3,	#040h
	push	xr0
	bl	__fmulu8sw
	add	sp,	#4 
	mov	r3,	#045h
	push	xr0
	bl	__fdivu8sw
	add	sp,	#4 
	pop	xr0
	st	er0,	NEAR _flSensorOut
	st	er2,	NEAR _flSensorOut+02h

;;	flSensorOut[1] = (float)uniRawSensorOut._intArr[1]*2/2048.0f;	// AY
CLINEA 0000H 0001H 0523H 0002H 0044H
	l	er0,	NEAR _uniRawSensorOut+02h
	mov	r2,	r1
	extbw	er2
	mov	r2,	r3
	push	xr0
	bl	__fildu8sw
	mov	er0,	#0 
	mov	r2,	#00h
	mov	r3,	#040h
	push	xr0
	bl	__fmulu8sw
	add	sp,	#4 
	mov	r3,	#045h
	push	xr0
	bl	__fdivu8sw
	add	sp,	#4 
	pop	xr0
	st	er0,	NEAR _flSensorOut+04h
	st	er2,	NEAR _flSensorOut+06h

;;	flSensorOut[2] = (float)uniRawSensorOut._intArr[2]*2/2048.0f;	// AZ
CLINEA 0000H 0001H 0524H 0002H 0044H
	l	er0,	NEAR _uniRawSensorOut+04h
	mov	r2,	r1
	extbw	er2
	mov	r2,	r3
	push	xr0
	bl	__fildu8sw
	mov	er0,	#0 
	mov	r2,	#00h
	mov	r3,	#040h
	push	xr0
	bl	__fmulu8sw
	add	sp,	#4 
	mov	r3,	#045h
	push	xr0
	bl	__fdivu8sw
	add	sp,	#4 
	pop	xr0
	st	er0,	NEAR _flSensorOut+08h
	st	er2,	NEAR _flSensorOut+0ah

;;		uniRawSensorOut._intArr[0], flSensorOut[0], uniRawSensorOut._intArr[1], flSensorOut[1], uniRawSensorOut._intArr[2], flSensorOut[2]);
CLINEA 0000H 0001H 0527H 0003H 0086H
	push	xr0
	add	sp,	#-4
	bl	__ftodu8sw
	l	er0,	NEAR _uniRawSensorOut+04h
	push	er0
	l	er0,	NEAR _flSensorOut+04h
	l	er2,	NEAR _flSensorOut+06h
	push	xr0
	add	sp,	#-4
	bl	__ftodu8sw
	l	er0,	NEAR _uniRawSensorOut+02h
	push	er0
	l	er0,	NEAR _flSensorOut
	l	er2,	NEAR _flSensorOut+02h
	push	xr0
	add	sp,	#-4
	bl	__ftodu8sw
	l	er0,	NEAR _uniRawSensorOut
	push	er0
	mov	r0,	#BYTE1 OFFSET $$S205
	mov	r1,	#BYTE2 OFFSET $$S205
	push	er0
	bl	_printf_n
	add	sp,	#32
CBLOCKEND 212 2 1321

;;}
CLINEA 0000H 0001H 0529H 0001H 0001H
	pop	pc
CBLOCKEND 212 1 1321
CFUNCTIONEND 212


	rseg $$MainOp_KX022$main
CFUNCTION 213

_MainOp_KX022	:
CBLOCK 213 1 1334

;;{
CLINEA 0000H 0001H 0536H 0001H 0001H
	push	lr
CBLOCK 213 2 1334
CRET 0000H

;;	I2C_Read(KX022_I2C_ADDR, &KX022_XOUTL, 1, uniRawSensorOut._ucharArr, 6);
CLINEA 0000H 0001H 053BH 0002H 0049H
	mov	r0,	#06h
	push	r0
	mov	r0,	#BYTE1 OFFSET _uniRawSensorOut
	mov	r1,	#BYTE2 OFFSET _uniRawSensorOut
	push	er0
	mov	r0,	#01h
	push	r0
	mov	r2,	#BYTE1 OFFSET _KX022_XOUTL
	mov	r3,	#BYTE2 OFFSET _KX022_XOUTL
	mov	r0,	#01eh
	bl	_I2C_Read
	add	sp,	#6 

;;	flSensorOut[0] = (float)uniRawSensorOut._intArr[0]/16384.0f;	// X
CLINEA 0000H 0001H 053EH 0002H 0042H
	l	er0,	NEAR _uniRawSensorOut
	mov	r2,	r1
	extbw	er2
	mov	r2,	r3
	push	xr0
	bl	__fildu8sw
	mov	er0,	#0 
	mov	r2,	#080h
	mov	r3,	#046h
	push	xr0
	bl	__fdivu8sw
	add	sp,	#4 
	pop	xr0
	st	er0,	NEAR _flSensorOut
	st	er2,	NEAR _flSensorOut+02h

;;	flSensorOut[1] = (float)uniRawSensorOut._intArr[1]/16384.0f;	// Y
CLINEA 0000H 0001H 053FH 0002H 0042H
	l	er0,	NEAR _uniRawSensorOut+02h
	mov	r2,	r1
	extbw	er2
	mov	r2,	r3
	push	xr0
	bl	__fildu8sw
	mov	er0,	#0 
	mov	r2,	#080h
	mov	r3,	#046h
	push	xr0
	bl	__fdivu8sw
	add	sp,	#4 
	pop	xr0
	st	er0,	NEAR _flSensorOut+04h
	st	er2,	NEAR _flSensorOut+06h

;;	flSensorOut[2] = (float)uniRawSensorOut._intArr[2]/16384.0f;	// Y
CLINEA 0000H 0001H 0540H 0002H 0042H
	l	er0,	NEAR _uniRawSensorOut+04h
	mov	r2,	r1
	extbw	er2
	mov	r2,	r3
	push	xr0
	bl	__fildu8sw
	mov	er0,	#0 
	mov	r2,	#080h
	mov	r3,	#046h
	push	xr0
	bl	__fdivu8sw
	add	sp,	#4 
	pop	xr0
	st	er0,	NEAR _flSensorOut+08h
	st	er2,	NEAR _flSensorOut+0ah

;;		uniRawSensorOut._intArr[0], flSensorOut[0], uniRawSensorOut._intArr[1], flSensorOut[1], uniRawSensorOut._intArr[2], flSensorOut[2]);
CLINEA 0000H 0001H 0543H 0003H 0086H
	push	xr0
	add	sp,	#-4
	bl	__ftodu8sw
	l	er0,	NEAR _uniRawSensorOut+04h
	push	er0
	l	er0,	NEAR _flSensorOut+04h
	l	er2,	NEAR _flSensorOut+06h
	push	xr0
	add	sp,	#-4
	bl	__ftodu8sw
	l	er0,	NEAR _uniRawSensorOut+02h
	push	er0
	l	er0,	NEAR _flSensorOut
	l	er2,	NEAR _flSensorOut+02h
	push	xr0
	add	sp,	#-4
	bl	__ftodu8sw
	l	er0,	NEAR _uniRawSensorOut
	push	er0
	mov	r0,	#BYTE1 OFFSET $$S207
	mov	r1,	#BYTE2 OFFSET $$S207
	push	er0
	bl	_printf_n
	add	sp,	#32

;;	I2C_Read(KX022_I2C_ADDR, &KX022_TSCP, 1, uniRawSensorOut._ucharArr, 2);
CLINEA 0000H 0001H 0546H 0002H 0048H
	mov	r0,	#02h
	push	r0
	mov	r0,	#BYTE1 OFFSET _uniRawSensorOut
	mov	r1,	#BYTE2 OFFSET _uniRawSensorOut
	push	er0
	mov	r0,	#01h
	push	r0
	mov	r2,	#BYTE1 OFFSET _KX022_TSCP
	mov	r3,	#BYTE2 OFFSET _KX022_TSCP
	mov	r0,	#01eh
	bl	_I2C_Read
	add	sp,	#6 

;;	switch(uniRawSensorOut._ucharArr[0])
CLINEA 0000H 0001H 0548H 0002H 0025H
	l	r0,	NEAR _uniRawSensorOut
CBLOCK 213 3 1353
	cmp	r0,	#01h
	beq	_$L213

;;	switch(uniRawSensorOut._ucharArr[0])
CLINEA 0000H 0000H 0548H 0002H 0025H
	cmp	r0,	#02h
	beq	_$L214

;;	switch(uniRawSensorOut._ucharArr[0])
CLINEA 0000H 0000H 0548H 0002H 0025H
	cmp	r0,	#04h
	beq	_$L215

;;	switch(uniRawSensorOut._ucharArr[0])
CLINEA 0000H 0000H 0548H 0002H 0025H
	cmp	r0,	#08h
	beq	_$L216

;;	switch(uniRawSensorOut._ucharArr[0])
CLINEA 0000H 0000H 0548H 0002H 0025H
	cmp	r0,	#010h
	beq	_$L217

;;	switch(uniRawSensorOut._ucharArr[0])
CLINEA 0000H 0000H 0548H 0002H 0025H
	cmp	r0,	#020h
	beq	_$L218

;;		default:	LEDOUT(0x00u); break;	// NONE
CLINEA 0000H 0000H 0550H 0003H 0028H
	mov	r0,	#00h
CBLOCKEND 213 3 1361

;;	}
CLINEA 0000H 0000H 0551H 0002H 0002H
_$L211 :
	st	r0,	0f260h
CBLOCKEND 213 2 1362

;;}
CLINEA 0000H 0001H 0552H 0001H 0001H
	pop	pc

;;		case 0x01u:	LEDOUT(0x1u<<4); break;	// FU: Face-Up State (Z+). Turn on LED4
CLINEA 0000H 0001H 054AH 0003H 004DH
_$L213 :
	mov	r0,	#010h
	bal	_$L211

;;		case 0x02u:	LEDOUT(0x1u<<3); break;	// FD: Face-Down State (Z-). Turn on LED3
CLINEA 0000H 0001H 054BH 0003H 004FH
_$L214 :
	mov	r0,	#08h
	bal	_$L211

;;		case 0x04u:	LEDOUT(0x1u<<2); break;	// UP: Up State (Y+). Turn on LED2
CLINEA 0000H 0001H 054CH 0003H 0048H
_$L215 :
	mov	r0,	#04h
	bal	_$L211

;;		case 0x08u:	LEDOUT(0x1u<<5); break;	// DO: Down State (Y-). Turn on LED5
CLINEA 0000H 0001H 054DH 0003H 004AH
_$L216 :
	mov	r0,	#020h
	bal	_$L211

;;		case 0x10u:	LEDOUT(0x1u<<7); break;	// RI: Right State (X+). Turn on LED7
CLINEA 0000H 0001H 054EH 0003H 004BH
_$L217 :
	mov	r0,	#080h
	bal	_$L211

;;		case 0x20u:	LEDOUT(0x1u<<0); break;	// LE: Left State (X-). Turn on LED0
CLINEA 0000H 0001H 054FH 0003H 004AH
_$L218 :
	mov	r0,	#01h
	bal	_$L211
CBLOCKEND 213 1 1362
CFUNCTIONEND 213


	rseg $$MainOp_KMX61$main
CFUNCTION 214

_MainOp_KMX61	:
CBLOCK 214 1 1375

;;{ 
CLINEA 0000H 0001H 055FH 0001H 0002H
	push	lr
CBLOCK 214 2 1375
CRET 0000H

;;	I2C_Read(KMX61_I2C_ADDR, &KMX61_ACCEL_XOUT_L, 1, uniRawSensorOut._ucharArr, 6);
CLINEA 0000H 0001H 0561H 0002H 0050H
	mov	r0,	#06h
	push	r0
	mov	r0,	#BYTE1 OFFSET _uniRawSensorOut
	mov	r1,	#BYTE2 OFFSET _uniRawSensorOut
	push	er0
	mov	r0,	#01h
	push	r0
	mov	r2,	#BYTE1 OFFSET _KMX61_ACCEL_XOUT_L
	mov	r3,	#BYTE2 OFFSET _KMX61_ACCEL_XOUT_L
	mov	r0,	#0eh
	bl	_I2C_Read
	add	sp,	#6 

;;	uniRawSensorOut._intArr[0] = uniRawSensorOut._intArr[0]>>2;
CLINEA 0000H 0001H 0562H 0002H 003CH
	l	er0,	NEAR _uniRawSensorOut
	srlc	r0,	#02h
	sra	r1,	#02h
	st	er0,	NEAR _uniRawSensorOut

;;	uniRawSensorOut._intArr[1] = uniRawSensorOut._intArr[1]>>2;
CLINEA 0000H 0001H 0563H 0002H 003CH
	l	er0,	NEAR _uniRawSensorOut+02h
	srlc	r0,	#02h
	sra	r1,	#02h
	st	er0,	NEAR _uniRawSensorOut+02h

;;	uniRawSensorOut._intArr[2] = uniRawSensorOut._intArr[2]>>2;
CLINEA 0000H 0001H 0564H 0002H 003CH
	l	er0,	NEAR _uniRawSensorOut+04h
	srlc	r0,	#02h
	sra	r1,	#02h
	st	er0,	NEAR _uniRawSensorOut+04h

;;	flSensorOut[0] = (float)uniRawSensorOut._intArr[0]/2048.0f;	// X
CLINEA 0000H 0001H 0566H 0002H 0041H
	l	er0,	NEAR _uniRawSensorOut
	mov	r2,	r1
	extbw	er2
	mov	r2,	r3
	push	xr0
	bl	__fildu8sw
	mov	er0,	#0 
	mov	r2,	#00h
	mov	r3,	#045h
	push	xr0
	bl	__fdivu8sw
	add	sp,	#4 
	pop	xr0
	st	er0,	NEAR _flSensorOut
	st	er2,	NEAR _flSensorOut+02h

;;	flSensorOut[1] = (float)uniRawSensorOut._intArr[1]/2048.0f;	// Y
CLINEA 0000H 0001H 0567H 0002H 0041H
	l	er0,	NEAR _uniRawSensorOut+02h
	mov	r2,	r1
	extbw	er2
	mov	r2,	r3
	push	xr0
	bl	__fildu8sw
	mov	er0,	#0 
	mov	r2,	#00h
	mov	r3,	#045h
	push	xr0
	bl	__fdivu8sw
	add	sp,	#4 
	pop	xr0
	st	er0,	NEAR _flSensorOut+04h
	st	er2,	NEAR _flSensorOut+06h

;;	flSensorOut[2] = (float)uniRawSensorOut._intArr[2]/2048.0f;	// Z
CLINEA 0000H 0001H 0568H 0002H 0041H
	l	er0,	NEAR _uniRawSensorOut+04h
	mov	r2,	r1
	extbw	er2
	mov	r2,	r3
	push	xr0
	bl	__fildu8sw
	mov	er0,	#0 
	mov	r2,	#00h
	mov	r3,	#045h
	push	xr0
	bl	__fdivu8sw
	add	sp,	#4 
	pop	xr0
	st	er0,	NEAR _flSensorOut+08h
	st	er2,	NEAR _flSensorOut+0ah

;;		uniRawSensorOut._intArr[0], flSensorOut[0], uniRawSensorOut._intArr[1], flSensorOut[1], uniRawSensorOut._intArr[2], flSensorOut[2]);
CLINEA 0000H 0001H 056AH 0003H 0086H
	push	xr0
	add	sp,	#-4
	bl	__ftodu8sw
	l	er0,	NEAR _uniRawSensorOut+04h
	push	er0
	l	er0,	NEAR _flSensorOut+04h
	l	er2,	NEAR _flSensorOut+06h
	push	xr0
	add	sp,	#-4
	bl	__ftodu8sw
	l	er0,	NEAR _uniRawSensorOut+02h
	push	er0
	l	er0,	NEAR _flSensorOut
	l	er2,	NEAR _flSensorOut+02h
	push	xr0
	add	sp,	#-4
	bl	__ftodu8sw
	l	er0,	NEAR _uniRawSensorOut
	push	er0
	mov	r0,	#BYTE1 OFFSET $$S220
	mov	r1,	#BYTE2 OFFSET $$S220
	push	er0
	bl	_printf_n
	add	sp,	#32

;;	if(-0.5f<flSensorOut[0] && flSensorOut[0]<0.5f && 0.5f<flSensorOut[1])
CLINEA 0000H 0001H 056CH 0002H 0047H
	mov	er0,	#0 
	mov	r2,	#00h
	mov	r3,	#0bfh
	push	xr0
	l	er0,	NEAR _flSensorOut
	l	er2,	NEAR _flSensorOut+02h
	push	xr0
	bl	__fcmpu8sw
	add	sp,	#8 
	mov	psw,	r0
	bge	_$L221
	l	er0,	NEAR _flSensorOut
	push	xr0
	mov	er0,	#0 
	mov	r2,	#00h
	mov	r3,	#03fh
	push	xr0
	bl	__fcmpu8sw
	add	sp,	#8 
	mov	psw,	r0
	bge	_$L221
	mov	er0,	#0 
	mov	r2,	#00h
	mov	r3,	#03fh
	push	xr0
	l	er0,	NEAR _flSensorOut+04h
	l	er2,	NEAR _flSensorOut+06h
	push	xr0
	bl	__fcmpu8sw
	add	sp,	#8 
	mov	psw,	r0
	bge	_$L221

;;		LEDOUT(0x1u<<5);	// -30<angle(X,1g)<30 & angle(Y,1g)>30. Turn on LED5
CLINEA 0000H 0001H 056DH 0003H 0047H
	mov	r0,	#020h
	st	r0,	0f260h

;;	else if(0.5f<flSensorOut[0] && -0.5f<flSensorOut[1] && flSensorOut[1]<0.5f)
CLINEA 0000H 0001H 056EH 0002H 004CH
	b	_$L268
_$L221 :
	mov	er0,	#0 
	mov	r2,	#00h
	mov	r3,	#03fh
	push	xr0
	l	er0,	NEAR _flSensorOut
	l	er2,	NEAR _flSensorOut+02h
	push	xr0
	bl	__fcmpu8sw
	add	sp,	#8 
	mov	psw,	r0
	bge	_$L232
	mov	er0,	#0 
	mov	r2,	#00h
	mov	r3,	#0bfh
	push	xr0
	l	er0,	NEAR _flSensorOut+04h
	l	er2,	NEAR _flSensorOut+06h
	push	xr0
	bl	__fcmpu8sw
	add	sp,	#8 
	mov	psw,	r0
	bge	_$L232
	l	er0,	NEAR _flSensorOut+04h
	push	xr0
	mov	er0,	#0 
	mov	r2,	#00h
	mov	r3,	#03fh
	push	xr0
	bl	__fcmpu8sw
	add	sp,	#8 
	mov	psw,	r0
	bge	_$L232

;;		LEDOUT(0x1u<<0);	// 30<angle(X,1g) & -30<angle(Y,1g)<30. Turn on LED0
CLINEA 0000H 0001H 056FH 0003H 0047H
	mov	r0,	#01h
	st	r0,	0f260h

;;	else if(-0.5f<flSensorOut[0] && flSensorOut[0]<0.5f && flSensorOut[1]<-0.5f)
CLINEA 0000H 0001H 0570H 0002H 004DH
	b	_$L268
_$L232 :
	mov	er0,	#0 
	mov	r2,	#00h
	mov	r3,	#0bfh
	push	xr0
	l	er0,	NEAR _flSensorOut
	l	er2,	NEAR _flSensorOut+02h
	push	xr0
	bl	__fcmpu8sw
	add	sp,	#8 
	mov	psw,	r0
	bge	_$L243
	l	er0,	NEAR _flSensorOut
	push	xr0
	mov	er0,	#0 
	mov	r2,	#00h
	mov	r3,	#03fh
	push	xr0
	bl	__fcmpu8sw
	add	sp,	#8 
	mov	psw,	r0
	bge	_$L243
	l	er0,	NEAR _flSensorOut+04h
	l	er2,	NEAR _flSensorOut+06h
	push	xr0
	mov	er0,	#0 
	mov	r2,	#00h
	mov	r3,	#0bfh
	push	xr0
	bl	__fcmpu8sw
	add	sp,	#8 
	mov	psw,	r0
	bge	_$L243

;;		LEDOUT(0x1u<<2);	// -30<angle(X,1g)<30 & angle(Y,1g)<-30. Turn on LED2
CLINEA 0000H 0001H 0571H 0003H 0048H
	mov	r0,	#04h
	st	r0,	0f260h

;;	else if(flSensorOut[0]<-0.5f && -0.5f<flSensorOut[1] && flSensorOut[1]<0.5f)
CLINEA 0000H 0001H 0572H 0002H 004DH
	b	_$L268
_$L243 :
	l	er0,	NEAR _flSensorOut
	l	er2,	NEAR _flSensorOut+02h
	push	xr0
	mov	er0,	#0 
	mov	r2,	#00h
	mov	r3,	#0bfh
	push	xr0
	bl	__fcmpu8sw
	add	sp,	#8 
	mov	psw,	r0
	bge	_$L254
	mov	er0,	#0 
	mov	r2,	#00h
	mov	r3,	#0bfh
	push	xr0
	l	er0,	NEAR _flSensorOut+04h
	l	er2,	NEAR _flSensorOut+06h
	push	xr0
	bl	__fcmpu8sw
	add	sp,	#8 
	mov	psw,	r0
	bge	_$L254
	l	er0,	NEAR _flSensorOut+04h
	push	xr0
	mov	er0,	#0 
	mov	r2,	#00h
	mov	r3,	#03fh
	push	xr0
	bl	__fcmpu8sw
	add	sp,	#8 
	mov	psw,	r0
	bge	_$L254

;;		LEDOUT(0x1u<<7);	// angle(X,1g)<-30 & -30<angle(Y,1g)<30. Turn on LED7
CLINEA 0000H 0001H 0573H 0003H 0048H
	mov	r0,	#080h
	st	r0,	0f260h

;;	else if(flSensorOut[2]>0.5f)
CLINEA 0000H 0001H 0574H 0002H 001DH
	bal	_$L268
_$L254 :
	l	er0,	NEAR _flSensorOut+08h
	l	er2,	NEAR _flSensorOut+0ah
	push	xr0
	mov	er0,	#0 
	mov	r2,	#00h
	mov	r3,	#03fh
	push	xr0
	bl	__fcmpu8sw
	add	sp,	#8 
	mov	psw,	r0
	ble	_$L265

;;		LEDOUT(0x1u<<4);	// angle(Z,1g)>30. Turn on LED4
CLINEA 0000H 0001H 0575H 0003H 0032H
	mov	r0,	#010h
	st	r0,	0f260h

;;	else if(flSensorOut[2]<-0.5f)
CLINEA 0000H 0001H 0576H 0002H 001EH
	bal	_$L268
_$L265 :
	l	er0,	NEAR _flSensorOut+08h
	l	er2,	NEAR _flSensorOut+0ah
	push	xr0
	mov	er0,	#0 
	mov	r2,	#00h
	mov	r3,	#0bfh
	push	xr0
	bl	__fcmpu8sw
	add	sp,	#8 
	mov	psw,	r0
	bge	_$L268

;;		LEDOUT(0x1u<<3);	// angle(Z,1g)<-30. Turn on LED3
CLINEA 0000H 0001H 0577H 0003H 0033H
	mov	r0,	#08h
	st	r0,	0f260h
_$L268 :

;;	I2C_Read(KMX61_I2C_ADDR, &KMX62_MAG_XOUT_L, 1, uniRawSensorOut._ucharArr, 6);
CLINEA 0000H 0001H 057AH 0002H 004EH
	mov	r0,	#06h
	push	r0
	mov	r0,	#BYTE1 OFFSET _uniRawSensorOut
	mov	r1,	#BYTE2 OFFSET _uniRawSensorOut
	push	er0
	mov	r0,	#01h
	push	r0
	mov	r2,	#BYTE1 OFFSET _KMX62_MAG_XOUT_L
	mov	r3,	#BYTE2 OFFSET _KMX62_MAG_XOUT_L
	mov	r0,	#0eh
	bl	_I2C_Read
	add	sp,	#6 

;;	uniRawSensorOut._intArr[0] = uniRawSensorOut._intArr[0]>>2;
CLINEA 0000H 0001H 057BH 0002H 003CH
	l	er0,	NEAR _uniRawSensorOut
	srlc	r0,	#02h
	sra	r1,	#02h
	st	er0,	NEAR _uniRawSensorOut

;;	uniRawSensorOut._intArr[1] = uniRawSensorOut._intArr[1]>>2;
CLINEA 0000H 0001H 057CH 0002H 003CH
	l	er0,	NEAR _uniRawSensorOut+02h
	srlc	r0,	#02h
	sra	r1,	#02h
	st	er0,	NEAR _uniRawSensorOut+02h

;;	uniRawSensorOut._intArr[2] = uniRawSensorOut._intArr[2]>>2;
CLINEA 0000H 0001H 057DH 0002H 003CH
	l	er0,	NEAR _uniRawSensorOut+04h
	srlc	r0,	#02h
	sra	r1,	#02h
	st	er0,	NEAR _uniRawSensorOut+04h

;;	flSensorOut[0] = (float)uniRawSensorOut._intArr[0]*0.146f;	// X
CLINEA 0000H 0001H 057FH 0002H 0040H
	l	er0,	NEAR _uniRawSensorOut
	mov	r2,	r1
	extbw	er2
	mov	r2,	r3
	push	xr0
	bl	__fildu8sw
	mov	r0,	#06h
	mov	r1,	#081h
	mov	r2,	#015h
	mov	r3,	#03eh
	push	xr0
	bl	__fmulu8sw
	add	sp,	#4 
	pop	xr0
	st	er0,	NEAR _flSensorOut
	st	er2,	NEAR _flSensorOut+02h

;;	flSensorOut[1] = (float)uniRawSensorOut._intArr[1]*0.146f;	// Y
CLINEA 0000H 0001H 0580H 0002H 0040H
	l	er0,	NEAR _uniRawSensorOut+02h
	mov	r2,	r1
	extbw	er2
	mov	r2,	r3
	push	xr0
	bl	__fildu8sw
	mov	r0,	#06h
	mov	r1,	#081h
	mov	r2,	#015h
	mov	r3,	#03eh
	push	xr0
	bl	__fmulu8sw
	add	sp,	#4 
	pop	xr0
	st	er0,	NEAR _flSensorOut+04h
	st	er2,	NEAR _flSensorOut+06h

;;	flSensorOut[2] = (float)uniRawSensorOut._intArr[2]*0.146f;	// Y
CLINEA 0000H 0001H 0581H 0002H 0040H
	l	er0,	NEAR _uniRawSensorOut+04h
	mov	r2,	r1
	extbw	er2
	mov	r2,	r3
	push	xr0
	bl	__fildu8sw
	mov	r0,	#06h
	mov	r1,	#081h
	mov	r2,	#015h
	mov	r3,	#03eh
	push	xr0
	bl	__fmulu8sw
	add	sp,	#4 
	pop	xr0
	st	er0,	NEAR _flSensorOut+08h
	st	er2,	NEAR _flSensorOut+0ah

;;		uniRawSensorOut._intArr[0], flSensorOut[0], uniRawSensorOut._intArr[1], flSensorOut[1], uniRawSensorOut._intArr[2], flSensorOut[2]);
CLINEA 0000H 0001H 0583H 0003H 0086H
	push	xr0
	add	sp,	#-4
	bl	__ftodu8sw
	l	er0,	NEAR _uniRawSensorOut+04h
	push	er0
	l	er0,	NEAR _flSensorOut+04h
	l	er2,	NEAR _flSensorOut+06h
	push	xr0
	add	sp,	#-4
	bl	__ftodu8sw
	l	er0,	NEAR _uniRawSensorOut+02h
	push	er0
	l	er0,	NEAR _flSensorOut
	l	er2,	NEAR _flSensorOut+02h
	push	xr0
	add	sp,	#-4
	bl	__ftodu8sw
	l	er0,	NEAR _uniRawSensorOut
	push	er0
	mov	r0,	#BYTE1 OFFSET $$S270
	mov	r1,	#BYTE2 OFFSET $$S270
	push	er0
	bl	_printf_n
	add	sp,	#32
CBLOCKEND 214 2 1412

;;}
CLINEA 0000H 0001H 0584H 0001H 0001H
	pop	pc
CBLOCKEND 214 1 1412
CFUNCTIONEND 214


	rseg $$MainOp_Temperature_Sensor_20$main
CFUNCTION 215

_MainOp_Temperature_Sensor_20	:
CBLOCK 215 1 1425

;;{
CLINEA 0000H 0001H 0591H 0001H 0001H
	push	lr
CBLOCK 215 2 1425
CRET 0000H

;;	uniRawSensorOut._uint = ADC_Read(0);
CLINEA 0000H 0000H 0592H 0002H 0025H
	mov	r0,	#00h
	bl	_ADC_Read
	st	er0,	NEAR _uniRawSensorOut

;;	flSensorOut[0] = uniRawSensorOut._uint*3.3f/1023;
CLINEA 0000H 0001H 0594H 0002H 0032H
	mov	er2,	#0 
	push	xr0
	bl	__fuldu8sw
	mov	r0,	#033h
	mov	r1,	#033h
	mov	r2,	#053h
	mov	r3,	#040h
	push	xr0
	bl	__fmulu8sw
	add	sp,	#4 
	mov	r0,	#00h
	mov	r1,	#0c0h
	mov	r2,	#07fh
	mov	r3,	#044h
	push	xr0
	bl	__fdivu8sw
	add	sp,	#4 
	pop	xr0
	st	er0,	NEAR _flSensorOut
	st	er2,	NEAR _flSensorOut+02h

;;	flSensorOut[1] = Voltage2Temperature(flSensorOut[0], 1.3f, 30.0f, -0.0082f);
CLINEA 0000H 0001H 0596H 0002H 004DH
	push	xr0
	mov	r0,	#066h
	mov	r1,	#066h
	mov	r2,	#0a6h
	mov	r3,	#0bfh
	push	xr0
	bl	__faddu8sw
	add	sp,	#4 
	mov	r0,	#04bh
	mov	r1,	#059h
	mov	r2,	#06h
	mov	r3,	#0bch
	push	xr0
	bl	__fdivu8sw
	add	sp,	#4 
	mov	er0,	#0 
	mov	r2,	#0f0h
	mov	r3,	#041h
	push	xr0
	bl	__faddu8sw
	add	sp,	#4 
	pop	xr0
	st	er0,	NEAR _flSensorOut+04h
	st	er2,	NEAR _flSensorOut+06h

;;	LEDOUT(((unsigned char)(uniRawSensorOut._uint>>2)));
CLINEA 0000H 0001H 0598H 0002H 0035H
	l	er0,	NEAR _uniRawSensorOut
	srlc	r0,	#02h
	st	r0,	0f260h

;;	printf( ESC_NEWLINE "BD1020HFV> Temperature = %6.6f[°C]. Vsenout = %6.6f[V]" ESC_NEWLINE, flSensorOut[1], flSensorOut[0]);
CLINEA 0000H 0001H 0599H 0002H 007CH
	l	er0,	NEAR _flSensorOut
	l	er2,	NEAR _flSensorOut+02h
	push	xr0
	add	sp,	#-4
	bl	__ftodu8sw
	l	er0,	NEAR _flSensorOut+04h
	l	er2,	NEAR _flSensorOut+06h
	push	xr0
	add	sp,	#-4
	bl	__ftodu8sw
	mov	r0,	#BYTE1 OFFSET $$S272
	mov	r1,	#BYTE2 OFFSET $$S272
	push	er0
	bl	_printf_n
	add	sp,	#18
CBLOCKEND 215 2 1434

;;}
CLINEA 0000H 0001H 059AH 0001H 0001H
	pop	pc
CBLOCKEND 215 1 1434
CFUNCTIONEND 215


	rseg $$MainOp_Temperature_Sensor_21$main
CFUNCTION 216

_MainOp_Temperature_Sensor_21	:
CBLOCK 216 1 1447

;;{
CLINEA 0000H 0001H 05A7H 0001H 0001H
	push	lr
CBLOCK 216 2 1447
CRET 0000H

;;	uniRawSensorOut._uint = ADC_Read(0);
CLINEA 0000H 0000H 05A8H 0002H 0025H
	mov	r0,	#00h
	bl	_ADC_Read
	st	er0,	NEAR _uniRawSensorOut

;;	flSensorOut[0] = uniRawSensorOut._uint*3.3f/1023;
CLINEA 0000H 0001H 05AAH 0002H 0032H
	mov	er2,	#0 
	push	xr0
	bl	__fuldu8sw
	mov	r0,	#033h
	mov	r1,	#033h
	mov	r2,	#053h
	mov	r3,	#040h
	push	xr0
	bl	__fmulu8sw
	add	sp,	#4 
	mov	r0,	#00h
	mov	r1,	#0c0h
	mov	r2,	#07fh
	mov	r3,	#044h
	push	xr0
	bl	__fdivu8sw
	add	sp,	#4 
	pop	xr0
	st	er0,	NEAR _flSensorOut
	st	er2,	NEAR _flSensorOut+02h

;;	flSensorOut[1] = Voltage2Temperature(flSensorOut[0], 1.3f, 30.0f, -0.0082f);
CLINEA 0000H 0001H 05ACH 0002H 004DH
	push	xr0
	mov	r0,	#066h
	mov	r1,	#066h
	mov	r2,	#0a6h
	mov	r3,	#0bfh
	push	xr0
	bl	__faddu8sw
	add	sp,	#4 
	mov	r0,	#04bh
	mov	r1,	#059h
	mov	r2,	#06h
	mov	r3,	#0bch
	push	xr0
	bl	__fdivu8sw
	add	sp,	#4 
	mov	er0,	#0 
	mov	r2,	#0f0h
	mov	r3,	#041h
	push	xr0
	bl	__faddu8sw
	add	sp,	#4 
	pop	xr0
	st	er0,	NEAR _flSensorOut+04h
	st	er2,	NEAR _flSensorOut+06h

;;	LEDOUT(ReverseBits((unsigned char)(uniRawSensorOut._uint>>3)));
CLINEA 0000H 0000H 05AEH 0002H 0040H
	l	er0,	NEAR _uniRawSensorOut
	srlc	r0,	#03h
	bl	_ReverseBits
	st	r0,	0f260h

;;	printf(ESC_ERASE2END "BDJ0601HFV> Temperature = %.02f[°C]. Vsenout = %.02f[V]", flSensorOut[1], flSensorOut[0]);
CLINEA 0000H 0001H 05AFH 0002H 0072H
	l	er0,	NEAR _flSensorOut
	l	er2,	NEAR _flSensorOut+02h
	push	xr0
	add	sp,	#-4
	bl	__ftodu8sw
	l	er0,	NEAR _flSensorOut+04h
	l	er2,	NEAR _flSensorOut+06h
	push	xr0
	add	sp,	#-4
	bl	__ftodu8sw
	mov	r0,	#BYTE1 OFFSET $$S274
	mov	r1,	#BYTE2 OFFSET $$S274
	push	er0
	bl	_printf_n
	add	sp,	#18

;;	if(SENINTF_HDR1_GPIO0(D)==1)
CLINEA 0000H 0001H 05B0H 0002H 001DH
	tb	0f258h.2
	beq	_$L275

;;		PRINTF(ESC_NEWLINE "BDJ0601HFV> Temperature Threshold Reached." ESC_PREVLINE);
CLINEA 0000H 0001H 05B1H 0003H 0050H
	mov	er0,	#48
	push	er0
	mov	r2,	#BYTE1 OFFSET $$S277
	mov	r3,	#BYTE2 OFFSET $$S277
	mov	er0,	#0 
	bl	_write

;;	else
CLINEA 0000H 0001H 05B2H 0002H 0005H
	bal	_$L278
_$L275 :

;;		PRINTF(ESC_NEWLINE "BDJ0601HFV> Temperature Threshold Not Reached." ESC_PREVLINE);
CLINEA 0000H 0001H 05B3H 0003H 0054H
	mov	er0,	#52
	push	er0
	mov	r2,	#BYTE1 OFFSET $$S279
	mov	r3,	#BYTE2 OFFSET $$S279
	mov	er0,	#0 
	bl	_write
_$L278 :
	add	sp,	#2 
CBLOCKEND 216 2 1460

;;}
CLINEA 0000H 0001H 05B4H 0001H 0001H
	pop	pc
CBLOCKEND 216 1 1460
CFUNCTIONEND 216


	rseg $$MainOp_Temperature_Sensor_22$main
CFUNCTION 217

_MainOp_Temperature_Sensor_22	:
CBLOCK 217 1 1473

;;{
CLINEA 0000H 0001H 05C1H 0001H 0001H
	push	lr
CBLOCK 217 2 1473
CRET 0000H

;;	uniRawSensorOut._uint = ADC_Read(0);
CLINEA 0000H 0000H 05C2H 0002H 0025H
	mov	r0,	#00h
	bl	_ADC_Read
	st	er0,	NEAR _uniRawSensorOut

;;	flSensorOut[0] = uniRawSensorOut._uint*3.3f/1023;
CLINEA 0000H 0001H 05C4H 0002H 0032H
	mov	er2,	#0 
	push	xr0
	bl	__fuldu8sw
	mov	r0,	#033h
	mov	r1,	#033h
	mov	r2,	#053h
	mov	r3,	#040h
	push	xr0
	bl	__fmulu8sw
	add	sp,	#4 
	mov	r0,	#00h
	mov	r1,	#0c0h
	mov	r2,	#07fh
	mov	r3,	#044h
	push	xr0
	bl	__fdivu8sw
	add	sp,	#4 
	pop	xr0
	st	er0,	NEAR _flSensorOut
	st	er2,	NEAR _flSensorOut+02h

;;	flSensorOut[1] = Voltage2Temperature(flSensorOut[0], 1.753f, 30.0f, -0.01068f);
CLINEA 0000H 0001H 05C6H 0002H 0050H
	push	xr0
	mov	r0,	#04eh
	mov	r1,	#062h
	mov	r2,	#0e0h
	mov	r3,	#0bfh
	push	xr0
	bl	__faddu8sw
	add	sp,	#4 
	mov	r0,	#02bh
	mov	r1,	#0fbh
	mov	r2,	#02eh
	mov	r3,	#0bch
	push	xr0
	bl	__fdivu8sw
	add	sp,	#4 
	mov	er0,	#0 
	mov	r2,	#0f0h
	mov	r3,	#041h
	push	xr0
	bl	__faddu8sw
	add	sp,	#4 
	pop	xr0
	st	er0,	NEAR _flSensorOut+04h
	st	er2,	NEAR _flSensorOut+06h

;;	LEDOUT(ReverseBits((unsigned char)(uniRawSensorOut._uint>>3)));
CLINEA 0000H 0000H 05C8H 0002H 0040H
	l	er0,	NEAR _uniRawSensorOut
	srlc	r0,	#03h
	bl	_ReverseBits
	st	r0,	0f260h

;;	printf(ESC_STX "BDE0600G> Temperature \t\t\t= %.02f[C]." ESC_NEWLINE, flSensorOut[1]);
CLINEA 0000H 0001H 05C9H 0002H 0057H
	l	er0,	NEAR _flSensorOut+04h
	l	er2,	NEAR _flSensorOut+06h
	push	xr0
	add	sp,	#-4
	bl	__ftodu8sw
	mov	r0,	#BYTE1 OFFSET $$S281
	mov	r1,	#BYTE2 OFFSET $$S281
	push	er0
	bl	_printf_n
	add	sp,	#10
CBLOCKEND 217 2 1486

;;}
CLINEA 0000H 0001H 05CEH 0001H 0001H
	pop	pc
CBLOCKEND 217 1 1486
CFUNCTIONEND 217


	rseg $$MainOp_Temperature_Sensor_23$main
CFUNCTION 218

_MainOp_Temperature_Sensor_23	:
CBLOCK 218 1 1499

;;{
CLINEA 0000H 0001H 05DBH 0001H 0001H
	push	lr
CBLOCK 218 2 1499
CRET 0000H

;;	uniRawSensorOut._uint = ADC_Read(0);
CLINEA 0000H 0000H 05DCH 0002H 0025H
	mov	r0,	#00h
	bl	_ADC_Read
	st	er0,	NEAR _uniRawSensorOut

;;	flSensorOut[0] = uniRawSensorOut._uint*3.3f/1023;
CLINEA 0000H 0001H 05DEH 0002H 0032H
	mov	er2,	#0 
	push	xr0
	bl	__fuldu8sw
	mov	r0,	#033h
	mov	r1,	#033h
	mov	r2,	#053h
	mov	r3,	#040h
	push	xr0
	bl	__fmulu8sw
	add	sp,	#4 
	mov	r0,	#00h
	mov	r1,	#0c0h
	mov	r2,	#07fh
	mov	r3,	#044h
	push	xr0
	bl	__fdivu8sw
	add	sp,	#4 
	pop	xr0
	st	er0,	NEAR _flSensorOut
	st	er2,	NEAR _flSensorOut+02h

;;	flSensorOut[1] = Voltage2Temperature(flSensorOut[0], 1.3f, 30.0f, -0.0082f);
CLINEA 0000H 0001H 05E0H 0002H 004DH
	push	xr0
	mov	r0,	#066h
	mov	r1,	#066h
	mov	r2,	#0a6h
	mov	r3,	#0bfh
	push	xr0
	bl	__faddu8sw
	add	sp,	#4 
	mov	r0,	#04bh
	mov	r1,	#059h
	mov	r2,	#06h
	mov	r3,	#0bch
	push	xr0
	bl	__fdivu8sw
	add	sp,	#4 
	mov	er0,	#0 
	mov	r2,	#0f0h
	mov	r3,	#041h
	push	xr0
	bl	__faddu8sw
	add	sp,	#4 
	pop	xr0
	st	er0,	NEAR _flSensorOut+04h
	st	er2,	NEAR _flSensorOut+06h

;;	LEDOUT(ReverseBits((unsigned char)(uniRawSensorOut._uint>>3)));
CLINEA 0000H 0000H 05E2H 0002H 0040H
	l	er0,	NEAR _uniRawSensorOut
	srlc	r0,	#03h
	bl	_ReverseBits
	st	r0,	0f260h

;;	printf(ESC_ERASE2END "BDJ0550HFV> Temperature = %.02f[°C]. Vsenout = %.02f[V]", flSensorOut[1], flSensorOut[0]);
CLINEA 0000H 0001H 05E3H 0002H 0072H
	l	er0,	NEAR _flSensorOut
	l	er2,	NEAR _flSensorOut+02h
	push	xr0
	add	sp,	#-4
	bl	__ftodu8sw
	l	er0,	NEAR _flSensorOut+04h
	l	er2,	NEAR _flSensorOut+06h
	push	xr0
	add	sp,	#-4
	bl	__ftodu8sw
	mov	r0,	#BYTE1 OFFSET $$S283
	mov	r1,	#BYTE2 OFFSET $$S283
	push	er0
	bl	_printf_n
	add	sp,	#18

;;	if(SENINTF_HDR1_GPIO0(D)==0)
CLINEA 0000H 0001H 05E4H 0002H 001DH
	tb	0f258h.2
	bne	_$L284

;;		PRINTF(ESC_NEWLINE "BDJ0550HFV> Temperature Threshold Reached." ESC_PREVLINE);
CLINEA 0000H 0001H 05E5H 0003H 0050H
	mov	er0,	#48
	push	er0
	mov	r2,	#BYTE1 OFFSET $$S286
	mov	r3,	#BYTE2 OFFSET $$S286
	mov	er0,	#0 
	bl	_write

;;	else
CLINEA 0000H 0001H 05E6H 0002H 0005H
	bal	_$L287
_$L284 :

;;		PRINTF(ESC_NEWLINE "BDJ0550HFV> Temperature Threshold Not Reached." ESC_PREVLINE);
CLINEA 0000H 0001H 05E7H 0003H 0054H
	mov	er0,	#52
	push	er0
	mov	r2,	#BYTE1 OFFSET $$S288
	mov	r3,	#BYTE2 OFFSET $$S288
	mov	er0,	#0 
	bl	_write
_$L287 :
	add	sp,	#2 
CBLOCKEND 218 2 1512

;;}
CLINEA 0000H 0001H 05E8H 0001H 0001H
	pop	pc
CBLOCKEND 218 1 1512
CFUNCTIONEND 218


	rseg $$Init_Hall_Effect_Sensors_1$main
CFUNCTION 219

_Init_Hall_Effect_Sensors_1	:
CBLOCK 219 1 1525
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
