ROHMUSDC/ROHM_SensorPlatform_Multi-Sensor-Shield/(commit log)

2015-06-15 ROHM Multi-Sensor Shield Board - First Commit
    Still needs some work, but wanted to add in the related files used to
    present this board at Sensor Expo 2015
    [SENSORKIT-MULTISENSORSHIELD_BOARD_BRD_REV01_2015-05-18.brd, SENSORKIT-MULTISENSORSHIELD_BOARD_SCH_REV01_2015-05-18.DSN, SENSORKIT_MULTISENSORSHIELD_BOARD_BOM_REV01_2015-05-18.xlsx]
2015-06-16 Commented Arduino Code, Added NXP LPC Full Project Files
2015-06-16 Added in GPLv3 into Source Files (main.c, *.ino)
    Also added first draft of Arduino User's Manual... this is a work in
    progress but is starting
2015-06-26 Updated Arduino code and documentation
2015-09-10 Schematic/BOM update
    Added Magnetometer+LevelShifter+LDO
    Made minor changes
    [BM1422GMV.OLB, SENSORKIT-MULTISENSORSHIELD_BOARD_SCH_REV01_2015-05-18.DSN, SENSORKIT_MULTISENSORSHIELD_BOARD_BOM_REV01_2015-05-18.xlsx, sensorkit-multisensorshield_board_sch_rev01_2015-05-18.opj]
2015-09-11 Updated HW Files
    Schematic, BOM updates
    [SENSORKIT-MULTISENSORSHIELD_BOARD_SCH_REV01_2015-05-18.DSN, SENSORKIT_MULTISENSORSHIELD_BOARD_BOM_REV02_2015-09-11.xlsx, sensorkit-multisensorshield_board_sch_rev01_2015-05-18.opj]
2015-10-02 Updated Sch and BOM
    Updated Sch and BOM
    [ROHM_PARTS_ONLY_SENSORKIT_MULTISENSORSHIELD_BOM.xlsx, SENSORKIT-MULTISENSORSHIELD_BOARD_SCH_REV01_2015-05-18.DSN, SENSORKIT_MULTISENSORSHIELD_BOARD_BOM_REV02_2015-09-11.xlsx, SENSORKIT_MULTISENSORSHIELD_BOARD_BOM_REV02_2015-09-22.xlsx, sensorkit-multisensorshield_board_sch_rev01_2015-05-18.opj, sensorkit-multisensorshield_board_sch_rev01_2015-09-21.opj]
2015-10-07 Added Datasheet and references to "ROHM_SENSORSHLD1-EVK-101"
    Added general datasheet. Also added this naming to the documentation.
    Also change file structure around to accommodate the old and new
    revision PN
    [BM1422GMV.OLB, ROHM_PARTS_ONLY_SENSORKIT_MULTISENSORSHIELD_BOM.xlsx, ROHM_SENSORSHLD0-EVK-101_BOARD_BRD_REV01_2015-05-18.brd, ROHM_SENSORSHLD0-EVK-101_BOM_REV01_2015-05-18.xlsx, ROHM_SENSORSHLD0-EVK-101_SCH_REV01_2015-05-18.DSN, ROHM_SENSORSHLD1-EVK-101_BOM_REV02_2015-09-22.xlsx, ROHM_SENSORSHLD1-EVK-101_BRD_REV02_2015-09-25.brd, ROHM_SENSORSHLD1-EVK-101_SCH_REV01_2015-09-22.DSN]
2015-12-18 Add KXG03
    Nordic, Arduino and MultiTech
2016-03-04 Major Update: 3-3-2016
    This is a Major update for this repository. Cleared up erroneous
    information in the documentation folder. Updated Shield Datasheet for
    SHLD1 Board. Updated Sensor Datasheets. Updated README. README
    changed to include disclaimer instead of open source.
    [ROHM_SENSORSHLD0-EVK-101_BOARD_BRD_REV01_2015-05-18.brd, ROHM_SENSORSHLD0-EVK-101_BOM_REV01_2015-05-18.xlsx, ROHM_SENSORSHLD0-EVK-101_SCH_REV01_2015-05-18.DSN, ROHM_SENSORSHLD1-EVK-101_BOM_REV02_2015-09-22.xlsx, ROHM_SENSORSHLD1-EVK-101_BRD_REV02_2015-09-25.brd, ROHM_SENSORSHLD1-EVK-101_SCH_REV01_2015-09-22.DSN, SENSORKIT_MULTISENSORSHIELD_BOARD_BOM_REV02_2015-09-22.xlsx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]
2016-03-29 HW Files Updated
    Updated HW files for SHLD1 Build; cleaned up the rest of the repository
    [ROHM_SENSORSHLD0-EVK-101_BOARD_BRD_REV00_2015-05-18.brd, ROHM_SENSORSHLD0-EVK-101_BOARD_BRD_REV01_2015-05-18.brd, ROHM_SENSORSHLD0-EVK-101_BOM_REV00_2015-05-18.xlsx, ROHM_SENSORSHLD0-EVK-101_BOM_REV01_2015-05-18.xlsx, ROHM_SENSORSHLD0-EVK-101_SCH_REV00_2015-05-18.DSN, ROHM_SENSORSHLD0-EVK-101_SCH_REV01_2015-05-18.DSN, ROHM_SENSORSHLD1-EVK-101_BOM_REV00.1_2015-03-03.xlsx, ROHM_SENSORSHLD1-EVK-101_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]
2016-04-12 RoHS Compliance documents
    Added RoHS documentation
    [ROHM_SENSORSHLD1-EVK-101_BOM_REV01_2016-03-16.xlsx]
2016-04-23 Fixed Readme
    Fixed Readme information for some small mistakes found. Also applied
    same changes to datasheet.
    [ROHM_SENSORSHLD1-EVK-101_BOM_REV01_2016-03-16.xlsx]
2016-04-28 Updated Readme
    Added FAQ question about corner accelerometers
2016-05-31 Updated ReadMe and Arduino Platform Guide Information
    Added one question to the ReadMe regarding the HW rework required for
    using this shield with the Arduino Uno. Added additional fixes to
    Arduino Uno Platform guide for new mag sensor on the SHLD1 board. Added
    a Arduino Usage guide for partners who want to demo the shield using a
    provided Arudino Shield board without having to go though the full
    platform guide.
    [ROHM_SENSORSHLD0-EVK-101_11-17-2015.ino, ROHM_SENSORSHLD1-EVK-101_05-03-2016.ino]
2016-05-31 Adjusted Arduino Usage Manual
    Updated HW rework description on the Arduino Usage manual to SHLD1
    references.
2016-05-31 Readme Fix
    Adjusted FAQ for Arduino Shield rework to SHLD1 references.
2016-06-08 SHLD1 Update - Nordic Platform Operation
    Added SHLD1 Code update for Nordic nRF51-DK. See ...platform
    guides\nordic...
    [ROHM_SENSORSHLD1-EVK-101_BOM_REV01_2016-03-16.xlsx, ROHM_SENSORSHLD1-EVK-101_BOM_REV01_2016-03-16_ROHS.xlsx]
2016-08-29 FAQ/Tester Code Updated
    Updated FAQ to explain yellow sticker, uploaded tester code to
    repository
    [ROHM_SENSORSHLD1-EVK-101_BOM_REV01_2016-03-16.xlsx]
2016-08-31 Documentation Updated
    Added CE DoC related files
    [ROHM_SENSORSHLD1-EVK-101_BOM_REV01_2016-03-16_ROHS.xlsx]
2016-09-15 Updated Nordic Platform Code
    Added code for handling "Yellow" Stickered boards (Pressure Sensor
    issue). Added Section to Documentation on how to setup without running
    through the MBED compiler. Added HEX File output to allow user to
    program without looking at any code. Fixed Typo in README File.
    [main_06-08-2016.cpp]
2016-10-20 Updated Arduino Platform Code and Documentation
    Found extraneous I2C initialization for KX122, added fix to Baud Rate
    mismatch between documentation and code.
    [ROHM_SENSORSHLD1-EVK-101_10-20-2016.ino]
2016-10-25 Added General Arduino Presentation
    Added General Presentation on how to use this shield with the Arduino
    Uno and also provides some sensor overview for sensors on the shield.
2016-11-11 Added Logging Function to Arduino Example
    Added Logging Function to Arduino Code, Added Documentation to Explain
    how to use this logging feature, and made some minor fixed to sensor
    read code
    [ROHM_SENSORSHLD1-EVK-101_TerminalDemo_11-10-2016.ino]
2017-03-14 Updated Readme
    UV Sensor Obsolete
