ROHMUSDC/ROHM_SensorPlatform_Multi-Sensor-Shield/(notices)

Notices in the files:
Platform Code/Arduino_UNO_FirmwareExample/ROHM_SENSORSHLD1-EVK-101_10-20-2016/ROHM_SENSORSHLD1-EVK-101_TerminalDemo_11-10-2016/ROHM_SENSORSHLD1-EVK-101_TerminalDemo_11-10-2016.ino:
This program is free software: you can redistribute it and/or modify
it under the terms of the GNU General Public License as published by
the Free Software Foundation, either version 3 of the License, or
(at your option) any later version.
